trawngson/aware/PAPER.md

# AWARE Paper

Canonical Google Docs paper:

<https://docs.google.com/document/d/1BP99mH7bwltNn4pk-PNhn_heGZIfV6X5lEwvW1smD6A/edit?tab=t.0>

Use this Google Doc as the current source of truth for the paper. Local
research and implementation notes may supplement it, but should not be assumed
to reflect the latest prose in the paper.
