trawngson/aware/design/ab/body-options.html

Thùng rác phân loại · thân B · khung và vỏ

# Phương án thân B

Năm cách làm khung và vỏ cho cùng một thân 680 × 680 × 1170 mm. Cụm đầu, 2 ngăn kéo và 4 thùng gấp PP giữ nguyên. Chọn một phương án để xem hình 3D, vật liệu từng phần, giá và điểm mạnh yếu.

Tách rời Nhìn xuyên vỏ Kéo ngăn kéo Góc nhìn ban đầu

## So sánh 5 phương án

Giá khung và vỏ lấy từ tab 3 của sheet vật tư (giá tấm, thanh từ trang báo giá; tiền cắt, hàn, chấn, dán cạnh là ước tính). Hai phương án mix và cân nặng là ước tính của mình, chưa tra.

Hình 3D dựng từ kích thước thiết kế để so sánh hình dáng và vật liệu, chưa phải CAD đã kiểm tra va chạm. Chỉ Mix 2 (đã chọn) đang có trong CAD và đã qua kiểm tra 25 tư thế; các phương án khác phải sửa CAD và chạy lại kiểm tra trước khi gửi xưởng.
