trawngson/aware/design/ab/index.html

aware · design/ab · thiết kế chi tiết · E1

# Thiết kế thùng rác tự phân loại

- Kích thước ngoài 698 × 698 × 1170 mm, nặng khoảng 40 kg (ước tính). Khung sắt V lỗ bắt bulông, vỏ và nắp inox 304 dày 1 mm.
- Miệng ném Ø550 ở cao 1170 mm. Rác rơi xuống đĩa nhôm Ø320: MG90S xoay đĩa ±45° về phía ngăn, MG996R nghiêng đĩa 45° qua đai GT2 2:1 để đổ.
- 4 thùng trên 2 ngăn kéo: 1 Nhựa (sau phải), 2 Giấy (sau trái), 3 Kim loại (trước trái), 4 Khác (trước phải). Không chắc loại thì vào ngăn 4. Mỗi thùng 270 × 270 × 573 mm, 39,7 L theo hình học, dùng thật khoảng 25–31 L.
- Vật nặng tối đa ở mép đĩa 0,63 kg nếu giữ servo dưới 50% sức kéo. Vật 0,5 kg dùng 40% sức MG996R.
- Mạch S3-1: ESP32-S3 CAM với camera OV2640 120°, màn Guition 4,3" có ESP32-S3 riêng, 4 cảm biến đầy HC-SR04, nguồn adapter 12 V 5 A.

Thân

B · Khung nhôm

Màu nắp inox thân B

Đang tải lưới CAD…

Sẵn sàng

1 · Nhựa 2 · Giấy 3 · Kim loại 4 · Khác Nhìn xuyên vỏ Tách rời Góc nhìn ban đầu

## Số đo chính

## Chi tiết theo cách gia công

### Gửi đi gia công

- Cắt laser hoặc CNC: lấy các file trong dxf/, tỉ lệ 1:1, đơn vị mm. Gồm mâm, đĩa, đế xoay, phễu trải phẳng, các tấm, khay ngăn kéo và 2 file thùng gấp PP bin_wall_strip_x4, bin_floor_x4.
- Cắt CNC tấm Formex: floor_plate, head_seat_plate (Formex 15 mm, khoét góc), drawer_bottom_formex_x2 (Formex 8 mm). Alu 6 mm cắt lẻ: slide_mount_left/right, center_wall.
- Cắt laser + chấn inox 1 mm: phôi có đường gấp (lớp CUT, BEND, NOTE): side_panel_left/right, back_panel, head_panel_front, drawer_front_left/right (có lỗ tay nắm), drawer_stiffener_x4, top_cover. Thêm 4 bản đế chân thép 3 mm (foot_plate_1..4, hàn đai ốc M8).
- In 3D: lấy các file trong parts/*.stl: giá chữ C, giá MG996R, miếng nối servo xoay (yaw_hub, đặc 100%), miếng nối puly 20T (tilt_pulley_adapter, đặc 100%), 2 tai đĩa, 2 cục chặn, rãnh và trống vòng cáp, hộp cảm biến, bệ màn hình.
- Cắt thanh: nhôm hộp 30×30 và 40×30, nhôm dẹt 60×10 (2 đoạn 61 mm, taro M4 hai đầu), trục inox Ø8 (200 mm và 93 mm). Sắt V lỗ cắt theo cut_list_slotted_angle.csv: 4 cây 1155 mm, 9 cây 671 mm, 1 cây 665 mm.
- Bulông cơ cấu nghiêng: 42 con, CAD ghi cỡ và vị trí trong dimensions.json (mục tilt_drive_fasteners): phần lớn M4, thêm M3, M2 và 2 bulông M5 bắt giá chữ C. Xem trang lắp ráp Lắp truyền động D (https://claude.ai/artifact/4bjrufrW9ZDk44Mt1UgGmx).
- File cho xưởng: assembly_e1.step, exploded_e1.step, tilt_to_bin_1..4.step, components.csv.

### Phải đo trước khi cắt

- Thùng gấp PP: gấp thử 1 thùng trước, đo lại kích thước ngoài và độ phồng của thành khi chứa đầy.
- Servo MG996R và MG90S thật: lỗ tai (MG996R đang lấy 48,5 × 10 theo số cộng đồng tự đo), horn chữ thập của MG90S, số răng trục then hoa MG90S (20 hay 21). Đo mô-men MG996R bằng cân treo.
- Puly: lỗ 8 mm hay 5 mm (40T), chiều dài (17 hay 18 mm), đường kính vành 40T (26–29 mm).
- Gối KFL08: khoảng cách lỗ (36–37 mm, giá đã khoét rãnh ±1 mm) và chiều cao (11,5–13 mm). Đường kính trục inox mua về.
- Board ESP32-S3 camera thật: kích thước, số chân rảnh.
- Màn Guition 4,3" thật: kích thước bo, độ dày tính cả đầu cắm, lỗ bắt, vùng hiển thị có nằm giữa bo không (CAD đang giả sử nằm giữa). Board CAM thật: kích thước, vị trí đầu cắm camera và cổng USB-C.
- Ray trượt thật: độ dày, chiều cao, khoảng cách lỗ bắt.
- Sắt V lỗ thật: bề rộng cánh (26 hay 30 mm), khoảng cách lỗ tới góc và bước lỗ, để khoan lỗ vỏ inox và tấm bắt ray trùng lỗ thanh. Nắp inox: hỏi xưởng lượng bù khi gấp mép 1 mm (file tính theo K = 0,44).

## Cụm đầu và phễu

Cụm đầu là một khối liền: mâm, phễu, khung treo, cơ cấu nghiêng, đĩa, cảm biến đầy và bệ màn hình. Toàn bộ treo trên một vòng mâm đặt ở cao độ 1050 mm. Gom hết vào một khối thì thân chỉ cần làm đúng một việc: đỡ vòng mâm ở đúng cao độ đó.

Phần đậm là chi tiết của tab này, phần mờ là phần còn lại của thùng (nút “Hiện phần còn lại” để bật hoặc tắt). Bấm một dòng trong bảng “Chi tiết trong CAD” ở cuối tab để làm nổi chi tiết đó và xoay camera tới.

### Kích thước chính

Hạng mục | Giá trị
Cao miệng ném (mép trên phễu) | 1170 mm
Miệng phễu | Ø550
Phễu côn: cao / thành dày | 140 / 2 mm
Cổ phễu: đường kính / cao gờ | Ø330 / 30 mm
Mâm đầu (nhôm 3 mm) | Ø594 / lỗ Ø400, z = 1050
Vòng định vị dưới mâm | Ø556, sâu 20 mm
4 thanh treo 30×30×2 ở r255 | dài 375 mm
Thanh chữ thập 40×30×2 | 2 × 540 mm, đáy z = 645
Diềm cổ phễu | 36 dải PVC mềm × 14 mm
Chốt định hướng Ø6 | r284, mép sau
Khối lượng cụm đầu (ước tính) | khoảng 4–5 kg

### Gia công phễu (file DXF cắt laser)

- funnel_cone_half_x2.dxf: phễu côn gồm 2 nửa hình quạt, mỗi nửa 113,13°, bán kính trong và ngoài 268,7 / 446,7 mm, có mép chồng 15 mm để tán rivet. Vật liệu PP 2 mm.
- funnel_collar_ring.dxf: vành miệng phễu. funnel_lip_band.dxf: băng gờ cổ phễu, uốn tròn.
- head_shell_ring_strip.dxf: dải vỏ đầu (nhôm composite 3 mm, uốn tròn). head_locating_ring_strip.dxf: dải vòng định vị (PP 3 mm).
- head_deck.dxf: mâm đầu, có sẵn 4 lỗ bắt thanh treo.

Lỗi hay gặp: PP gần như không dán được bằng keo thường. Phải nối bằng rivet nhựa hoặc rivet nhôm kèm long đền, hoặc hàn nhựa. Mặt ngoài của mép chồng phải nằm xuôi theo chiều rác trượt xuống, nếu không rác sẽ vướng vào mép.

### Trình tự lắp

1. Cuộn dải vòng định vị thành vòng tròn, tán rivet rồi bắt vào mặt dưới mâm.
2. Bắt 4 thanh treo vào mâm (4 lỗ có sẵn). Bắt thanh chữ thập vào đầu dưới các thanh treo, chỗ hai thanh bắt chéo nhau có kẹp tấm 3 mm.
3. Dán 4 chân cao su dưới đầu thanh chữ thập. Đóng chốt định hướng vào lỗ ở mép sau mâm.
4. Cuộn và tán phễu côn, vành và gờ cổ. Đặt phễu lên mâm, dựng vỏ đầu bao quanh.
5. Treo diềm PVC dưới gờ cổ phễu. Lắp cơ cấu nghiêng (tab tiếp theo), 4 hộp cảm biến và bệ màn hình.

### Chi tiết trong CAD

Phương án D · đã chốt ngày 9/10

## Động cơ và cơ cấu nghiêng: xoay rồi nghiêng

Đĩa chạy theo 2 bước nối tiếp. Bước 1: servo nhỏ MG90S xoay cả cụm nghiêng quanh một trục đứng, để mép đĩa quay về phía ngăn cần đổ. Bước 2: MG996R nghiêng đĩa quanh một bản lề nằm ngang, qua đai GT2 tỉ số 2:1. Đĩa nghiêng được cả 2 chiều, nên chỉ cần xoay ±45° là tới đủ 4 ngăn chéo.

Hai điểm giúp motor nhỏ vẫn đủ sức: bản lề nằm sát mặt đĩa (cách 22 mm, gần trọng tâm đĩa) nên đĩa gần như cân bằng, và 2 gối đỡ ổ bi chịu trọng lượng đĩa, servo chỉ việc tạo mô-men xoay.

Phần đậm là chi tiết của tab này, phần mờ là phần còn lại của thùng (nút “Hiện phần còn lại” để bật hoặc tắt). Bấm một dòng trong bảng “Chi tiết trong CAD” ở cuối tab để làm nổi chi tiết đó và xoay camera tới.

### Truyền động

giá chữ C (trên thanh chữ thập)
  └ MG90S ─ horn chữ thập ─ miếng nối in ─ trục đứng Ø8 trong 2 gối KFL08 ─ mặt bích Ø32 ─ đế xoay
đế xoay
  ├ 2 trụ 60×10 ─ 2 gối KP08 ─ trục bản lề Ø8 ─ 2 tai ─ đĩa nhôm
  └ MG996R ─ horn nhôm 25T ─ miếng nối in ─ puly 20T ═ đai GT2 158 ═ puly 40T trên trục bản lề

Hạng mục | Giá trị
Servo nghiêng / xoay | MG996R / MG90S
Góc nghiêng / góc xoay | ±45° / ±45°
Mô-men kẹt MG996R ở 6 V (số thận trọng, shop ghi 15 kg·cm) | khoảng 11 kg·cm = 1,08 N·m
Puly, tỉ số | GT2 20T → 40T, 2:1
Đai kín GT2 rộng 6 mm / khoảng cách tâm puly | 158 mm / 48,58 mm
Trục bản lề (cách mặt đĩa 22 mm) | Ø8 × 200 mm, z = 878
Trục đứng | Ø8 × 93 mm
Đế xoay, nhôm 4 mm (13 lỗ, 4 lỗ ren M4 cho mặt bích) | 196 × 192 mm, z = 797–802
Puly 20T / 40T (dài theo trục, gồm vành và cổ) | 16 / 17 mm, vành Ø16 / Ø29
Mặt phẳng đai / mép puly 40T tới gối KP08 | x = 67–73 / 1,75 mm
Gối KP08 / KFL08: lỗ bắt | cách 42 / 37 mm, bulông M4
Mặt bích nối trục 8 mm | Ø32 × 13, 4 × M4 trên vòng Ø24
Trụ đỡ gối KP08 | nhôm dẹt 60×10 × 61 mm, taro M4

### Mô-men và tải

Trường hợp (đĩa nghiêng 45°, vật ở mép) | Giá trị
Mô-men cần ở bản lề, vật 0,5 kg | 0,783 N·m
Mô-men cần ở MG996R (qua 2:1, hiệu suất 90%) | 0,435 N·m (40%)
Vật nặng nhất ở mức 50% sức servo | 0,63 kg
Vật nặng nhất trước khi servo chết máy | 1,29 kg
Lực lớn nhất đĩa ép lên tay ở mép | khoảng 12 N
Tải của MG90S (trục xoay) | chỉ có quán tính, trọng lực không tạo mô-men quanh trục đứng

Quy tắc thiết kế: servo không làm việc quá 50% sức kéo tối đa. Script dừng hẳn nếu vượt mức này. Ngày 9/10 phương án D tính được vật ở mép khoảng 0,6 kg cho đĩa Ø280. CAD mới cho đĩa Ø320 bằng nhôm ra 0,63 kg, khớp với số cũ.

### Đĩa nghiêng

- Nhôm 1,5 mm, Ø320, nặng 0,326 kg, bắt vào 2 tai PETG bằng 4 vít M4 × 6 đầu bằng vào đai ốc cấy nhiệt. Mỗi tai kẹp trục bản lề bằng 1 vít trí M3 trên mặt D.
- Mặt đĩa ở cao độ 900 mm, trục bản lề ở 878 mm. Bản lề sát mặt đĩa nên đĩa nặng hơn PP vẫn nhẹ tải.
- Đổi từ PP sang nhôm: không chảy khi gặp tàn thuốc, khó xước, dễ lau.

Lưu ý: nhôm trần bóng sẽ hắt ánh đèn LED vào camera. Đã chốt bỏ sơn (20/10): chà mặt đĩa bằng miếng Scotch-Brite cho mờ, rồi chụp thử xem còn chói không. Không dán decal, vì decal sẽ chảy khi gặp đồ nóng.

### Cục chặn cứng 47° trên đế xoay

- 2 cục chặn PETG bọc cao su, đặt trên đế xoay ở y = ±88 mm, mặt trên ở z = 807,3.
- Đế xoay quay cùng hướng với đĩa, nên cục chặn luôn nằm ngay dưới mép đang hạ xuống.
- Đĩa nghiêng 45° vẫn cách cục chặn 5,7 mm. Tới 47° thì đáp lên cao su.
- Lực va đập hoặc lực tay ấn đi vào ổ của trục đứng, không đi vào bánh răng của cả 2 servo. Lực thẳng đứng không tạo mô-men quanh trục đứng, nên MG90S cũng không phải gánh.
- Mép thấp của đĩa ra tới bán kính khoảng 128 mm, còn đế xoay chỉ dài 96 mm mỗi bên, nên rác rơi ra không chạm đế.

### Đo góc

MPU-6050 dán dưới đĩa đo được góc nghiêng thật, nên phát hiện được kẹt (ra lệnh nghiêng sau 1,5 giây mà góc vẫn lệch quá 5°) và biết đĩa đang nghiêng bao nhiêu khi có điện lại.

IMU không đo được góc xoay, vì trọng lực không đổi khi xoay quanh trục đứng. MG90S chỉ chịu quán tính nên ít khi trượt bước. Nếu thử thực tế thấy hay đổ nhầm ngăn thì thêm AS5600 (khoảng 55k) dưới trục đứng.

Dây MG996R và IMU đi qua trục xoay: chừa vòng dây đủ dài cho ±45° xoay và ±47° nghiêng. Dùng dây silicon mềm.

### Đi dây động cơ qua khớp xoay (đã vẽ trong CAD)

Dây MG996R và IMU phải đi qua khớp xoay. Khớp này uốn khoảng 36.000 lần mỗi năm (ước tính 100 lần đổ mỗi ngày), nên không thả vòng chùng tự do mà dùng vòng lăn trong rãnh tròn: cáp dẹt gập chữ U, nằm giữa một thành cố định và một trống quay theo đế. Khi đế xoay, chỗ gập chỉ lăn dọc theo rãnh, nên cáp luôn uốn ở cùng một bán kính và không bị kéo căng.

Nhìn từ trên xuống, dưới đế xoay (z 783–797):

        thành ngoài cố định (r 40–43), có 2 vấu chặn ở ±70°
      ╭─────────────────────────╮
     │  cáp ─ chạy áp thành ngoài │ ← cáp vào qua rãnh ở 60°
     │    ╭─────────╮             │
     │    │ trống   │  ◯ trục Ø8  │   chốt chặn M4 dưới đế, ở r 55
     │    │ quay    │             │
     │    ╰────┬────╯             │
     │         ⊃ chỗ gập U, bán kính uốn 10,2 mm, lăn theo khi xoay
      ╰─────────────────────────╯
  cáp ra áp trống quay, đi lên qua lỗ ở đế (30°)

Hạng mục | Giá trị
Cáp | cáp dẹt 10 sợi, bước 1,27 mm, loại chịu uốn
Thứ tự sợi | 6 V, 6 V, GND, GND, PWM, GND, SDA, GND, SCL, 3,3 V
Chiều dài cáp trong rãnh | 134 mm
Bán kính uốn ở chỗ gập | 10,2 mm, khoảng 10 lần bề dày cáp
Chỗ gập lăn đi khi xoay hết ±70° | khoảng 46° quanh trục
Dây MG996R và IMU, cả đường từ bệ | khoảng 1,04 m → mua 1,2 m
Dây MG90S (không qua khớp) | 780 mm → dây nối dài servo 1 m

### Khi trục xoay quay quá tầm hoặc quay mãi

MG90S chuẩn chỉ quay trong 180°. Trục xoay vẫn có thể quay tự do nếu miếng nối trượt trên trục, tuốt răng servo, lắp nhầm bản MG90S 360°, hoặc có người lấy tay xoay đĩa. Khi đó dây có thể bị quấn quanh trục và giật đứt. Có 4 lớp bảo vệ:

1. Chặn cứng ±70° (đã vẽ): chốt M4 có ống lót dưới đế xoay, chạm vào 2 vấu trên rãnh. Dù servo hay miếng nối hỏng thì cụm vẫn không quay quá ±70°, đúng tầm rãnh được thiết kế. Đã kiểm tra: ở 68° chốt chưa chạm, ở 72° thì đã chạm. Tay ấn mạnh ở mép đĩa (khoảng 8 N·m) tạo khoảng 150 N lên chốt, nên vấu phải in đặc 100% và dán cao su.
2. Miếng nối servo xoay: không dùng khớp nối mềm. Khớp 5 × 8 mm dài 25 mm, không lọt dưới tay gối dưới, mà nửa 5 mm chỉ ôm được đầu then hoa ngắn của MG90S. Thay bằng một miếng nối in PETG đặc 100%, Ø20 × 11 mm. MG90S chỉ kèm horn dạng tay, không có horn tròn: miếng nối bắt vào horn chữ thập bằng 2 vít M2 tự ren qua 2 lỗ trên tay horn, mặt dưới có hốc tránh đầu vít tâm. Trục kẹp bằng vít trí M3 và đai ốc thả từ trên xuống, lên mặt D, bôi keo khoá ren. MG90S treo qua lỗ trên kệ, 2 tai tì lên mặt kệ (TowerPro: mặt dưới tai cách đáy 18,5 mm, trục then hoa nhô 4,1 mm). Kích thước horn chữ thập trong CAD là số tạm: đo horn thật trước khi in.
3. Phần mềm phát hiện: con quay trong IMU đo được tốc độ xoay quanh trục đứng. Thấy xoay khi không có lệnh, hoặc xoay quá xa so với lệnh, thì ngắt relay servo và báo lỗi. Ngắt xung PWM khi đứng yên để servo không rung làm mỏi dây. Lệnh xoay luôn giới hạn trong ±65°.
4. Khoanh vùng hỏng: cầu chì tự phục hồi 3 A trên đường 6 V, để dây có chập thì cũng không cháy mạch. Kẹp neo giữ vỏ cáp, để lực kéo không truyền vào mối hàn.

Khi lắp: cấp xung 1500 µs cho MG90S. Nếu servo cứ quay mãi thì đó là bản 360°, lắp nhầm hàng. Mình chưa thử tuổi thọ của cáp dẹt bán ở VN với bán kính uốn 10 mm. Nên in thử rãnh, cho chạy vài nghìn lần rồi đo thông mạch.

### Lỗi hay gặp

- Đai chùng hoặc quá căng: đai kín không có bộ căng đai, nên khoảng cách tâm 48,58 mm phải đúng. Giá bắt MG996R có rãnh đứng 2 mm (khoảng cách 2 puly là theo chiều đứng): kéo servo xuống cho đai căng rồi siết 4 vít M3.
- Puly 20T không lắp thẳng vào spline 25T của MG996R: lắp horn nhôm 25T Ø20 (4 lỗ ren M3), bắt miếng nối in vào horn bằng 4 vít M3, rồi lồng puly lên trụ Ø5,9 của miếng nối. Puly dài 16 mm: cổ puly quay về phía servo, vì 2 vít trí nằm trên cổ; mài mặt vát trên trụ cách đầu cổ 4 mm.
- Puly 40T dài 17 mm (2 vành Ø29, cổ một phía): lắp cổ quay vào giữa, vành ngoài cách gối KP08 khoảng 1,7 mm. Quay cổ ra ngoài là đụng gối.
- Puly 40T có shop ghi lỗ 8 mm nhưng đường link lại ghi 5 mm. Hỏi shop trước, nếu là lỗ 5 mm thì khoan lên 8 mm.
- MG996R giá rẻ hay là hàng nhái: mua 1 con, đo mô-men bằng cân treo rồi mới mua thêm. Gắn tay đòn 2,5 cm ở 6 V: cân phải lên tới khoảng 3,5 kg servo mới chịu thua (tức 9 kg·cm, đủ để tải 0,435 N·m chỉ chiếm 50%). Tháo đáy xem mọi bánh răng đều là kim loại. Shop đang chọn có bán cả bản MG996R-360: cấp xung 1500 µs, servo phải đứng yên ở giữa chứ không quay mãi.
- Xoay khi đĩa đang nghiêng: phần mềm phải luôn đưa đĩa về nằm ngang trước, rồi mới xoay sang ngăn khác.
- Nghiêng quá nhanh làm rác văng: tăng tốc từ từ, khoảng 1 giây cho 45°.

### Chi tiết trong CAD

## Cơ chế đổ

Rác không bị đẩy. Đĩa chỉ nghiêng về hướng của ngăn đích, và vật tự trượt khỏi mép thấp, qua khe giữa mép đĩa và gờ cổ phễu rồi rơi vào ngăn.

Phần đậm là chi tiết của tab này, phần mờ là phần còn lại của thùng (nút “Hiện phần còn lại” để bật hoặc tắt). Bấm một dòng trong bảng “Chi tiết trong CAD” ở cuối tab để làm nổi chi tiết đó và xoay camera tới.

### Hình học khi đổ (nghiêng 45°)

Hạng mục | Giá trị
Khe thoát dưới gờ cổ phễu | 180,9 mm
Cao độ mép thấp của đĩa | 779,4 mm
Cao độ miệng ngăn | 620 mm
Bán kính điểm rơi (tâm ngăn) | 224 mm
Vật lớn nhất lọt qua khe thoát | khoảng 170 mm

### Một lần đổ

1. Vật nằm yên trên đĩa, miệng phễu không có tay: camera nhận dạng và chọn ngăn.
2. Kiểm tra ngăn đó: còn chỗ chưa, có đang khoá không (đầy, hay ngăn kéo đang rút).
3. Xoay cụm nghiêng tới hướng ngăn (±45°, khoảng 0,7 giây), rồi nghiêng 45° trong khoảng 1 giây, tăng tốc và giảm tốc êm. Theo dõi IMU suốt lúc nghiêng.
4. Giữ 0,8 giây cho vật trượt hết.
5. Nghiêng về nằm ngang trong khoảng 1 giây, rồi mới xoay về 0°. Camera chụp lại xem đĩa đã trống chưa. Còn vật thì lắc nhẹ 2 lần, vẫn còn thì báo.

### Sức chứa

| Hình học (CAD) | Dùng được thật (ước tính) | Cả 4 ngăn
B · thùng 270×270×573 | 39,7 L | 25–31 L | khoảng 164 L

Rác luôn rơi vào cùng một chỗ nên chất thành hình nón, chỉ dùng được 60–75% thể tích. T17 · rải đều: mỗi lần đổ, đổi góc xoay lệch khoảng ±20° quanh đường chéo ngăn (MG90S làm được, vì xoay tới ±65° vẫn trong 180° của servo) và đổi góc nghiêng trong khoảng 35–45°, để dịch điểm rơi. Cách này có thể nâng phần dùng được lên khoảng 80%, nhưng mới là plausible, phải thử với rác thật.

### Khi đầy

Mức | Điều kiện (chỉnh lại khi thử) | Máy làm gì
Bình thường | Còn nhiều chỗ | Nhận rác
Gần đầy | khoảng 80% | Vẫn nhận. Màn hình hiện thanh vàng cho ngăn đó. E1 báo lên điện thoại qua wifi (tuỳ chọn)
Đầy | khoảng 90%, hoặc đỉnh rác cách đường rơi khoảng 80 mm | Khoá ngăn. Vật thuộc loại đó được giữ lại trên đĩa, màn hình báo “Ngăn X đầy”
Kẹt dù cảm biến chưa báo đầy | IMU thấy đĩa không tới được góc lệnh | Quay về, khoá ngăn, báo kẹt
Vừa đổ rác xong | Ngăn kéo đóng lại, cảm biến đo thấy ngăn trống | Hỏi “Đã lót túi chưa?”. Người dùng xác nhận thì mở khoá
Đo được dưới 200 mm | Rác không thể cao tới đó: đĩa nghiêng hết cỡ thì mép thấp ở 779 mm, cách cảm biến 216 mm. Đây là tiếng vọng từ diềm hoặc mép đĩa | Coi như cảm biến lỗi. Khoá ngăn, báo “Kiểm tra cảm biến ngăn X”
Nhảy từ gần trống lên đầy sau 1 lần đổ | Một vật không thể lấp gần hết ngăn. Thường là cảm biến nghe thấy mép túi hoặc khung | Khoá ngăn, báo kiểm tra cảm biến
Không có tiếng vọng | ECHO giữ mức cao quá 30 ms | Coi là không đọc được, không coi là trống. Khoá ngăn, báo kiểm tra

Đọc mỗi cảm biến 5 lần rồi lấy trung vị. Chỉ chuyển mức khi kết quả giữ nguyên 3 chu kỳ liền, để túi nilon phồng lên không làm máy báo đầy sai. Chỉ đo khi đĩa nằm ngang và đứng yên, vì lúc đổ thì rác rơi ngang qua chùm sóng.

### Chi tiết trong CAD (đường đổ rác, thân B)

## Lấy rác khi một ngăn đầy (thân B)

Rác nằm trong túi lót, nên lấy túi ra là lấy hết rác. Thùng vẫn nằm yên trong ngăn kéo, người dùng chỉ nhấc túi, không phải nhấc cả thùng nặng 10–12 kg. Bấm nút một ngăn bên dưới hình để xem từng bước.

Thùng và mặt ngăn kéo vẽ trong suốt để thấy túi rác bên trong. Túi đen là hình minh hoạ, không có trong CAD. Ray trượt vẽ đứng yên, thực tế ray kéo dài ra theo ngăn kéo.

### Các bước

1. Kéo ngăn kéo ra hết (ray 600 mm). Công tắc ở cuối ngăn kéo nhả ra, cắt nguồn servo và khoá 2 ngăn của ngăn kéo đó, nên đĩa không đổ rác xuống tay người.
2. Tháo vòng chun ở miệng thùng, miệng túi đang lộn ngoài vành sẽ tuột ra.
3. Gom miệng túi và buộc lại. Túi có dây rút thì chỉ cần kéo dây.
4. Nhấc túi thẳng lên. 4 lỗ Ø10 ở đáy cho khí vào dưới túi, nên túi không bị hút dính.
5. Lót túi mới, lộn miệng túi ra ngoài vành khoảng 5 cm, rồi lồng vòng chun lại.
6. Đẩy ngăn kéo vào rồi bấm xác nhận “Đã lót túi” trên màn hình để mở khoá ngăn.

### Khi có sự cố

Tình huống | Cách lấy rác ra
Quên lót túi, hoặc rác lọt xuống giữa túi và thành thùng | Kéo ngăn kéo ra, nhấc cả thùng lên (thùng nằm ngoài khung), dốc ngược đổ vào túi lớn
Túi rách khi nhấc | Nhấc cả thùng ra, dốc ngược như trên
Túi quá nặng (giấy ướt, chai lọ) | Thay sớm hơn. Màn hình báo vàng ở khoảng 80%, khoá ngăn ở khoảng 90%
Nước rỉ xuống đáy | Nước chảy qua lỗ thông khí xuống khay ngăn kéo. Lau khay, hoặc lót tấm thấm dưới đáy khay

### Lỗi hay gặp

- Túi quá nhỏ: túi phải rộng ít nhất 55 cm, dài ít nhất 82 cm. Túi ngắn sẽ tụt vào trong khi rác rơi xuống, rồi rác lọt xuống đáy thùng.
- Nhét tay thêm rác khi ngăn đã khoá: rác cao quá miệng thùng thì không buộc được túi.
- Thùng sau: khi kéo ra hết, thanh ngang trước của khung (rộng 20 mm) vẫn ở phía trên miệng thùng, cao hơn miệng 404 mm. Nhấc túi thì nghiêng túi ra trước một chút.

### Chi tiết trong CAD

## Bệ màn hình và camera

Bệ màn hình gồm hai phần: một tấm màn hình 4,3 inch ngả ra sau 12° và một đế thấp phía sau chứa các bo mạch. Màn hình là Guition JC4827W543: tấm IPS 480×272 gắn sẵn ESP32-S3 riêng, nối với board camera qua cổng UART JST 1,25 mm 4 chân. Ngoài hiển thị, board màn còn đọc 4 cảm biến siêu âm báo đầy. Tấm in là khung mỏng 5 mm quanh bo màn 120 × 70 mm (số của shop, phải đo). Sơ đồ chân ở trang mạch S3-1 (https://claude.ai/artifact/641f6wND7d8yH814VZVqmR).

Phần đậm là chi tiết của tab này, phần mờ là phần còn lại của thùng (nút “Hiện phần còn lại” để bật hoặc tắt). Bấm một dòng trong bảng “Chi tiết trong CAD” ở cuối tab để làm nổi chi tiết đó và xoay camera tới.

### Kích thước

Hạng mục | Giá trị
Đế: rộng × sâu × cao | 160 × 156 × 46 mm
Cằm: mép trước / cao | y = 132 / 20 mm
Màn hình 4,3": vùng hiển thị / tấm | 95 × 54 / 130 × 80 × 22 mm, ngả 12°
Mép trên màn hình (thân B) | cao 1268,3 mm so với sàn
Cáp camera 75 mm: khoảng cách từ camera tới đầu cắm trên board | 16,8 mm, dư khoảng 58 mm
Ống kính camera | (0; 154,9; 1178,7)
Trục camera so với phương thẳng đứng | 29,1°, chĩa vào tâm đĩa
Góc nhìn cần có (hình nón) | 60,2° → dùng ống 120°
Mép đĩa bị khuất | 0 / 72 điểm
Khoảng dư của tia nhìn tại gờ cổ phễu | khoảng 6,1 mm
Dải LED trắng 2835 (cắt mỗi 50 mm), rãnh rộng 9 | 100 mm, y = 174
Vành bắt vít trên mép phễu | cao 5 mm, từ y = 235 ra sau

### Bên trong bệ (vỏ in rỗng)

- Board ESP32-S3-N16R8 CAM nằm trong đế. Camera OV2640 ống 120° tách khỏi board, nối bằng cáp dẹt 75 mm, gắn sau ô kính dưới cằm, chĩa vào tâm đĩa. Script kiểm tra cáp với tới đầu cắm trên board, còn dư ít nhất 15 mm.
- Màn Guition 4,3" (bo 120 × 70 mm, khoảng 13 mm dày tính cả đầu cắm, số tạm) nằm gọn trong tấm màn, nối board camera bằng UART và nhận 5 V riêng từ mạch hạ áp. Giao diện làm bằng Guition Editor hoặc Arduino. Chừa lối cắm cổng USB-C của cả 2 board để nạp code không phải tháo bệ.
- Dải LED 5 V dài 100 mm (dải chỉ cắt được ở mốc 50 mm), bật tắt qua module 2 MOSFET XY-MOS. Module nhận tín hiệu từ 3,3 V nên chân GPIO của ESP32 mở hết MOSFET, đèn sáng tối đa. Lúc camera chụp thì bật 100%, không làm mờ bằng PWM để ảnh không bị sọc.
- Cầu đấu nguồn 5 V kèm tấm mạch nhỏ 8 điện trở chia áp, tụ 2200 µF, module relay cắt nguồn servo (xem tab Điện).
- Bệ in PETG làm 2 nửa, ghép bằng vít M3 và đai ốc cấy nhiệt. Bệ nằm trên mép trên của phễu, ra khỏi đường nước, bắt xuống mép phễu qua một vành thấp hai bên.
- Chỗ cho mạch (tra ngày 01/11): script kiểm tra 8 khối đặt vừa trong đế, mỗi khối có vách 2,5 mm bao quanh và không chạm màn hình, hốc camera hay nhau: board ESP32-S3 CAM 57×28×15 (2 cổng USB-C quay ra khe ở vách trái), cầu đấu 12P cắt còn 4 cực (37×18), tấm chia áp 24×20, tụ 13×26, XL4015 54×23 cộng chỗ dây hai đầu (66×23×18), mạch hạ áp 5 V 59×21×17 hàn dây ở hai đầu (62×21×17), relay 50×26 cộng phía cầu đấu (60×26×19), XY-MOS 34×17×12. Màn Guition 120×70,2 có 4 lỗ M3 cách 112,6 × 62,1, cổng USB-C và JST nguồn/UART ở mép trái ra qua khe trên thành tấm màn, vùng hiển thị lệch lên 1,7 mm so với tâm bo. Camera đặt sâu 3 mm trong lỗ Ø22 nên thành lỗ nằm ngoài nón 120°. Cáp camera 75 mm: từ camera tới đầu cắm giữa board khoảng 58 mm.

### Lỗi hay gặp

- Tấm màn hình dễ bị tì tay hoặc va: mép trên cao hơn miệng thùng khoảng 180 mm, lực bẻ dồn vào vành bắt vít ở mép phễu. Chưa kiểm tra độ bền chỗ này.
- Khoảng dư tia nhìn chỉ khoảng 6,1 mm: lắp camera lệch quá mức đó là khuất mất mép sau đĩa. In ổ camera có rãnh chỉnh và căn bằng một ảnh mẫu đĩa trống.
- Ống 120° làm méo ảnh kiểu mắt cá: hiệu chỉnh một lần bằng ảnh bàn cờ, hoặc huấn luyện mô hình nhận dạng luôn trên ảnh đã méo.
- LED chiếu thẳng xuống đĩa nhôm bóng gây chói: chà mặt đĩa cho mờ; nếu còn chói thì dán một dải nhựa mờ (không có trong danh sách mua) lên rãnh LED.

### Chi tiết trong CAD

## Cảm biến và điện

Dùng một adapter 12 V 5 A. Mạch hạ áp XL4015 hạ xuống 6 V cho 2 servo: phương án D tính mô-men của MG996R ở 6 V. Một mạch hạ áp khác hạ xuống 5 V cho ESP32-S3, màn hình và cảm biến. Nguồn servo đi qua công tắc an toàn bằng phần cứng, nên dù phần mềm treo thì ngăn kéo rút ra cũng không làm đĩa chuyển động được.

Phần đậm là chi tiết của tab này, phần mờ là phần còn lại của thùng (nút “Hiện phần còn lại” để bật hoặc tắt). Bấm một dòng trong bảng “Chi tiết trong CAD” ở cuối tab để làm nổi chi tiết đó và xoay camera tới.

### Sơ đồ nguồn

Adapter 12 V 5 A ──┬── hạ áp 5 V 3 A ── ESP32-S3 cam, màn hình, IMU, 4 × HC-SR04, LED
                   └── XL4015 6 V ── cầu chì 3 A ── Relay ── tụ 2200 µF ── MG996R + MG90S
                         ▲
   2 công tắc ngăn kéo, nối tiếp
- Cuộn hút của relay được cấp điện qua các công tắc mắc nối tiếp. Chỉ cần một công tắc mở là relay nhả, servo mất nguồn. Chân GPIO đọc thêm trạng thái để báo lên màn hình.
- Dây servo cỡ 18–20 AWG, đi riêng một đường từ cầu đấu.
- Nối chung mass cho mọi khối.

### Gán chân dự kiến

Khối | Số chân
Camera (có sẵn trên board) | không tính
Màn Guition (ESP32-S3 riêng): UART TX, RX | 2
Servo PWM: MG996R, MG90S | 2
I²C (IMU) | 2
HC-SR04: 4 TRIG + 4 ECHO, nối vào board màn Guition, không tính cho board camera | 0
2 công tắc ngăn kéo đọc vào | 2
LED XY-MOS, relay | 2
Tổng trên board camera | 10

Board ESP32-S3-N16R8 WROOM CAM còn khoảng 11 chân trống (suy ra từ board Freenove cùng kiểu, chưa đếm trên board thật), đủ cho 10 chân trên. 4 cảm biến siêu âm cần 8 chân nên đặt trên board màn Guition, mỗi cái 1 chân TRIG riêng. Chi tiết gán chân ở trang mạch S3-1 (https://claude.ai/artifact/641f6wND7d8yH814VZVqmR).

### Cảm biến đầy

- 4 cảm biến siêu âm HC-SR04 (25k một cái), mỗi cái trong một hộp in treo dưới gờ cổ phễu ở r215, úp mặt nhìn thẳng xuống một ngăn.
- Hộp ôm board 45 × 20 mm. Đầu dây quay ra ngoài, dây đi lên qua miệng hộp để hở. In với miệng loa úp xuống bàn in: có vạt nghiêng 45° đỡ phần chứa đầu dây nên không cần support.
- Mỗi đầu phát và đầu thu có một loa in: dài 15 mm, loe từ Ø16 ra Ø24. Miệng rộng hơn thì chùm sóng hẹp hơn: theo ước tính, sóng yếu đi một nửa ở ±11° thay vì ±16°. In ở trường nên không tốn thêm tiền.
- Thân B: miệng loa ở cao 995 mm. Ngăn trống đo ra khoảng 962 mm, đầy 90% khoảng 434 mm.
- B: khi rút thùng ra, cảm biến đo xa hơn mốc ngăn trống, nên máy biết ngăn đó đang thiếu thùng.
- Khoảng cách giữa 2 đầu đổi thành 27 mm theo 2 footprint độc lập (trước để 26). Vẫn nên mua 1 board, đo lại rồi sửa fill_sensor trước khi in.
- Nếu thử thật vẫn đo sai thì đổi sang VL53L1X (laser, khoảng 200k một cái) và in lại hộp.

### Lỗi hay gặp

- Chân ECHO của HC-SR04 ra 5 V, nối thẳng vào ESP32 (chỉ chịu 3,3 V) sẽ hỏng chân. Dùng cầu chia áp 1 kΩ / 2 kΩ.
- ESP32 tự khởi động lại khi servo bắt đầu chạy, do sụt áp. Cần tụ lớn và đường dây servo đi riêng.
- Dùng chung 1 chân TRIG thì cả 4 cái phát cùng lúc, nghe nhầm tiếng vọng của nhau. Mỗi cái một chân TRIG, đo lần lượt, cách nhau ít nhất 60 ms (datasheet khuyên chu kỳ đo trên 60 ms).
- Đưa chân ECHO qua PCF8574 thì đo sai: đọc qua I²C quá chậm, mà mỗi 1 mm chỉ chênh khoảng 6 µs.

### Vật nằm gần hơn mặt rác lúc đầy (thân B)

HC-SR04 trả về tiếng vọng đầu tiên nó nghe được. Vật nào gần hơn 434 mm mà nó nghe thấy thì máy sẽ tưởng ngăn đã đầy. CAD tìm các cạnh như vậy và đo góc lệch khỏi trục cảm biến (ghi trong dimensions.json, mục fill_sensor). Cột dB là mức nghe ước tính, tính cả đường đi lẫn đường về: càng âm thì càng khó nghe thấy.

Vật | Lệch khỏi trục | Cách cảm biến | Không loa | Có loa
Mép thùng, chỗ túi trùm qua | 18,5° | 396 mm | −8 dB | −21 dB
Thanh chữ thập | 20,6° | 374 mm | −10 dB | −28 dB
Đế xoay dưới đĩa | 22,3° | 220 mm | −12 dB | dưới −35 dB
Dây servo | 24,2° | 351 mm | −15 dB | dưới −35 dB
Đầu dưới diềm PVC | 26,2° | 108 mm | −17 dB | dưới −35 dB
Mép đĩa | 29,7° | 111 mm | −24 dB | dưới −35 dB

Cột dB tính theo mô hình đơn giản, coi miệng loa như một màng rung phẳng, chưa đo. Phép tìm cạnh cũng không tính chuyện vật này che vật kia. Datasheet chỉ hứa góc đo 15° với vật phẳng rộng ít nhất 0,5 m², mà miệng thùng chỉ khoảng 0,07 m². Phải thử 1 cái trên thùng thật trước khi in cả 4 hộp.

### Chi tiết trong CAD

## Thân B · khung sắt V lỗ, 2 ngăn kéo

Khung sắt V lỗ "3×3" dày 2 mm (cánh thực tế khoảng 26 mm theo các shop) bắt bulông như kệ kho: thanh ngang chồng lên mặt trong cánh cột và bắt bulông M8 qua lỗ V. Khung 680 × 680 mm đứng trên 4 chân tăng chỉnh M8; vỏ inox 1 mm cách cột 6 mm để chừa mũ bulông, ngoài cùng 698 × 698 mm, cao 1170 mm. Bốn thùng gấp từ tấm nhựa PP 3 mm đặt trên 2 ngăn kéo, mỗi ngăn kéo chở 1 thùng trước và 1 thùng sau. Mặt sau là tấm cố định nên thùng kê sát tường được. Cụm đầu bắt vít cố định vào tấm đỡ, vì đổ rác không cần nhấc đầu.

Phần đậm là chi tiết của tab này, phần mờ là phần còn lại của thùng (nút “Hiện phần còn lại” để bật hoặc tắt). Bấm một dòng trong bảng “Chi tiết trong CAD” ở cuối tab để làm nổi chi tiết đó và xoay camera tới.

### Khung và tấm

Hạng mục | Giá trị
Sắt V lỗ: cột đứng, đứng trên bản đế chân | 4 × 1155 mm
Sắt V lỗ: thanh ngang chồng trong cột (dưới 3, giữa 3, trên 4; không có thanh dưới phía trước) | 9 × 671 + 1 × 665 mm
Bulông kệ M8 bắt thanh vào cột (2 đầu mỗi thanh) | 16 × M8×12 + 4 × M8×15
Chân tăng chỉnh M8 đế Ø30 + bản đế thép 3 mm có đai ốc hàn; tai bản đế kẹp dưới thanh dưới | 4 bộ, cao 15 mm
Tấm sàn Formex 15 mm trên 3 thanh dưới, khoét 4 góc, 3 bulông M8×30 | 666 × 672
Tấm đỡ đầu Formex 15 mm trên 4 thanh trên, khoét 4 góc, 4 bulông M8×30 | 672 × 672, lỗ Ø560 + lỗ chốt
Vách giữa / 2 tấm bắt ray, alu composite 6 mm | 640 × 106 / 670 × 106
Tấm bắt ray bắt vào lỗ cột qua ống lót 18 mm | 8 bộ M5×40
Vỏ inox 1 mm gấp mép kín 10 mm: 2 hông / lưng / tấm che trước | 696 × 1155 / 692 × 1155 / 692 × 161
Nắp trên inox 304 dày 1 mm, mép gập xuống 15 mm | 698 × 698, lỗ Ø598
Tổng inox (vỏ, 2 mặt ngăn kéo, 4 nẹp, nắp) | khoảng 30,7 kg

### Ngăn kéo

Hạng mục | Giá trị
Ray bi 3 tầng First Slide 46 × 12,7, 45 kg/cặp | 4 × 600 mm (2 cặp)
Đáy khay, Formex 8 mm | 2 × 285,6 × 647
Thành hông khay, PP 3 mm phần dư | 4 × 647 × 60
Thành sau khay, PP 3 mm phần dư | 2 × 285,6 × 60
Mặt ngăn kéo inox 1 mm gấp mép, lỗ tay nắm 120 × 30, 2 nẹp gân mũ phía sau | 2 × 339 × 990
Thùng gấp từ tấm PP 3 mm, tâm ở (±158,5; ±158,5) | 270 × 270 × 573
Mép miệng gấp ra ngoài / 2 lỗ tay nắm | 15 mm / 90 × 30
Lỗ thông khí ở đáy mỗi thùng | 4 × Ø10, cách tâm (±80; ±80)
Vòng chun ép túi, bản 10 mm, dày 2 mm | 4 vòng, cách miệng 12 mm
Mép trên thùng / đáy thanh chữ thập | 617 / 645 mm

### Thùng gấp từ tấm PP 3 mm

Không có thùng bán sẵn nào hẹp mà cao như cần (270 × 270 × 573): thùng 27 × 27 cm thì chỉ cao 30–37 cm, thùng cao 50–60 cm thì rộng 38–44 cm. Vì vậy mỗi thùng được cắt phẳng từ tấm PP rồi gấp lại, giống gấp hộp carton. Đáy thùng nằm trên khay ngăn kéo, nên khay chịu sức nặng của rác, thành thùng chỉ giữ rác khỏi tràn ra ngang.

 Miếng 1 · thân  (bin_wall_strip_x4.dxf)
 ┌──────┬──────┬──────┬──────┬─┐ ← mép miệng 15 mm, xẻ ở góc
 │      │ ▭    │      │ ▭    │•│ ← mép dán 15 mm, 8 rivet
 │ mặt 1│ mặt 2│ mặt 3│ mặt 4│•│   ▭ lỗ tay nắm 90×30
 │ 270  │ 270  │ 270  │ 270  │•│   cao 573 mm
 └──•─•─┴──•─•─┴──•─•─┴──•─•─┴─┘ ← 8 rivet bắt vạt đáy
   1095 × 588 mm

 Miếng 2 · đáy  (bin_floor_x4.dxf)
      ┌────┐
   ┌──┼────┼──┐   264 × 264 + 4 vạt 30 mm
   │  │ ○ ○│  │   ○ 4 lỗ thông khí Ø10
   │  │ ○ ○│  │
   └──┼────┼──┘   324 × 324 mm
      └────┘

File DXF theo cùng quy ước với vỏ inox: đường cắt ở lớp CUT, đường gấp nét đứt ở lớp BEND, ghi chú cách gấp ở lớp NOTE. Ở đường gấp, xưởng chỉ rạch rãnh chữ V sâu khoảng 2/3 bề dày, không cắt đứt. Một tấm 1220 × 2440 xếp vừa 4 miếng thân. 4 miếng đáy cắt từ một tấm lẻ khoảng 0,65 × 0,65 m.

1. Cắt CNC theo 2 file DXF, mỗi file 4 miếng: đường viền, lỗ thông khí, lỗ tay nắm, lỗ rivet Ø4,1. Rạch rãnh gấp ở các đường lớp BEND.
2. Gấp thân thành ống vuông theo 4 rãnh, mép dán nằm bên trong mặt 1. Tán 8 rivet Ø4 có long đền.
3. Gấp 4 vạt đáy lên, đẩy đáy vào trong ống, tán 8 rivet quanh chân thùng.
4. Gấp 4 mảnh mép miệng ra ngoài. Hơ nóng nhẹ bằng máy khò nếu mép bị bật lại.
5. Gấp thử 1 thùng trước, đo lại, rồi mới cắt 3 thùng còn lại.

### Ngân sách cho 4 thùng

Hạng mục | Cơ sở tính | Ước tính
1 tấm PP 3 mm 1220 × 2440 (4 miếng thân) | Bảng giá các nhà bán năm 2026: 350–680k, phổ biến khoảng 535k | 350–680k
Tấm PP 3 mm cắt lẻ khoảng 0,65 × 0,65 m (4 miếng đáy) | Theo giá m² của tấm nguyên (khoảng 180k/m²), cộng phí cắt lẻ | 80–130k
Cắt CNC và rạch rãnh gấp | Khoảng 23 m đường cắt và 18 m rãnh. Bảng giá cũ khoảng 1.800 đ/m cho tấm 3 mm, nhưng xưởng thường tính phí tối thiểu | 100–200k
64 rivet nhôm Ø4 kèm long đền | 16 rivet mỗi thùng. Chưa tra giá trong nước | 40–60k
4 vòng chun ép túi | Chưa tra giá | 20k
Tổng 4 thùng | Khoảng 150–270k mỗi thùng. Đã có trong danh sách vật tư | 0,59–1,09 triệu

Rẻ hơn: tấm PP 2 mm (thành mềm hơn, dễ phồng) hoặc tấm PP rỗng (danpla, loại làm thùng carton nhựa; rất nhẹ và rẻ nhưng khe rỗng dễ đọng nước). Cả hai loại này chưa tra giá. Thùng tự gấp không kín nước hoàn toàn, vì nước rỉ qua rivet và lỗ thông khí xuống khay ngăn kéo.

### Màu nắp inox

Nắp trên, 2 hông, lưng, tấm che trước và 2 mặt ngăn kéo đều bằng inox 304 dày 1 mm (đổi từ Formex ngày 31/10). Mỗi tấm gấp mép kín 10 mm ở cả 4 cạnh, mặt gấp quay vào khung, nên không lộ cạnh cắt. Màu nắp:

Bạc là inox phun cát hoặc để mặt 2B. Các màu khác cần mạ PVD, đắt so với một tấm nắp nhỏ. Ở tab này vỏ được vẽ trong suốt để thấy khung; mở tab “Tổng quan · 3D” để xem vỏ đặc.

### Khung V lỗ, vỏ inox: lắp

- Chân: bắt chân tăng chỉnh M8 vào đai ốc hàn dưới 4 bản đế. Đặt chân cột lên bản đế.
- Khung: lắp như kệ kho: thanh ngang đặt chồng lên mặt trong cánh cột, bulông kệ M8 đầu tròn cổ vuông xuyên lỗ V từ ngoài vào, đai ốc ở trong. Thanh dưới hai bên kẹp luôn tai của bản đế chân (dùng M8×15). Hai thanh gặp nhau ở góc thì cánh nằm của thanh này đè lên cánh nằm của thanh kia. Đo 2 đường chéo, phải bằng nhau; siết kèm long đền vênh vì servo chạy gây rung.
- Không có thanh dưới phía trước: chỗ đó để khay ngăn kéo chạy ra. Tấm sàn bắt 3 bulông M8×30 vào 3 thanh dưới còn lại; 4 góc tấm khoét 28 × 28 để chừa tai bản đế và đai ốc bulông khung.
- Tấm bắt ray: alu composite 6 mm dài 670 mm, bắt vào lỗ cột trước và cột sau qua 4 ống lót 18 mm mỗi tấm. Vách giữa mang 2 ray quay lưng vào nhau: dùng vít đầu thấp và so le lỗ 2 ray để đai ốc bên này không cọ ray bên kia.
- Vỏ inox: cách mặt ngoài cột 6 mm (chừa mũ bulông kệ cao khoảng 4–5 mm và ke ốp ngoài nếu dùng). Bắt vít M4 inox có ống cách 6 mm vào lỗ V.
- Nắp inox: mép gập trùm xuống ngoài vỏ, bắt 2 vít ở mỗi góc vào đầu cột.

Đã có trong CAD: 35 bulông khung (cỡ và vị trí trong dimensions.json, mục body_fasteners). Chưa có: lỗ V của thanh (chưa đo được khoảng cách tâm lỗ tới góc) và lỗ vít trên vỏ inox. Đo 1 thanh V thật trước khi khoan vỏ.

### Thay túi

 ┌─────────┬─────────┐
 │ 2 Giấy  │ 1 Nhựa  │ ← sát tường
 ├─────────┼─────────┤
 │ 3 K.loại│ 4 Khác  │ ← phía trước
 └────↓────┴────↓────┘
  ngăn kéo   ngăn kéo
    trái       phải

Rút túi tại chỗ: thùng không phải nhấc ra, chỉ nhấc túi. Đây là cách rẻ và đơn giản nhất: mỗi thùng chỉ thêm 1 vòng dây chun bản 10 mm và 4 lỗ thông khí, tốn khoảng 20k cho cả 4 thùng.

1. Kéo ngăn kéo ra hết. Công tắc ở cuối ngăn kéo cắt nguồn servo và khoá 2 ngăn của nó.
2. Tháo vòng chun ở miệng thùng, gom miệng túi lại rồi buộc.
3. Nhấc túi thẳng lên. 4 lỗ Ø10 ở đáy cho khí vào dưới túi, nên túi không bị hút dính vào thùng.
4. Lót túi mới, lộn miệng túi trùm ra ngoài vành thùng khoảng 5 cm, rồi lồng vòng chun vào ép lại (cách miệng 12 mm).
5. Đẩy ngăn kéo vào rồi xác nhận trên màn hình là đã lót túi.

Túi cần rộng ít nhất 55 cm, dài ít nhất 82 cm. Nên dùng túi có dây rút để buộc nhanh. Ngăn kéo kéo ra hết thì thanh ngang trước của khung (rộng 20 mm) vẫn nằm phía trên miệng thùng sau, cách mép sau của miệng 10–30 mm và cao hơn miệng 404 mm. Khi nhấc túi, nghiêng túi về phía trước một chút là qua.

### Lỗi hay gặp

- Hai ray không song song: ngăn kéo sẽ bị kẹt. Bắt ray lên tấm phẳng, đo hai đầu lệch nhau không quá 1 mm.
- Ngăn kéo nặng: 2 thùng đầy giấy ướt có thể tới 19–25 kg; ray First Slide chịu 45 kg/cặp.
- Khung bị lệch vuông góc: lắp xong đo hai đường chéo của khung, phải bằng nhau.
- Cạnh inox sắc: mép đã gấp kín, nhưng lỗ tay nắm 120 × 30 trên mặt ngăn kéo vẫn là cạnh cắt: mài cạnh hoặc nẹp viền cao su.
- Siết bulông V lỗ không đủ chặt: khung rung theo servo và kêu. Dùng long đền vênh, kiểm tra lại sau 1 tuần chạy.
- Thùng nặng khoảng 40 kg (ước tính): sắt V lỗ nặng hơn nhôm. Lắp 4 chân tăng chỉnh, hoặc chân có bánh xe khoá.
- Ngân sách: tổng vật tư khoảng 8,3 triệu (sheet 02/11), vượt ngân sách 5 triệu. Chi tiết ở trang Vật tư trên CAD (https://claude.ai/artifact/5nJeV9B7Xnti5N8VQk3BP4).

### Chi tiết trong CAD (chỉ phần thân)

## Phần mềm và an toàn

Phần mềm chạy trên ESP32-S3 dưới dạng một máy trạng thái: tại mỗi thời điểm máy chỉ ở đúng một trạng thái, và chỉ chuyển sang trạng thái khác khi thoả điều kiện. Cách viết này giúp không bao giờ lỡ tay ra lệnh nghiêng khi chưa đủ điều kiện an toàn.

### Các trạng thái

Trạng thái | Làm gì | Chuyển sang
IDLE | Đĩa nằm ngang, LED xanh, chờ có vật. Màn hình lần lượt hiện các thông tin về rác, chữ to để người đi ngang đọc được | Camera thấy có thay đổi → SETTLE
SETTLE | Chờ vật nằm yên và miệng phễu không có tay liên tục 0,5 giây | → CLASSIFY
CLASSIFY | Đếm số vật, đo kích thước, nhận dạng loại | Nhiều hơn 1 vật hoặc vật quá cỡ → HOLD. Không chắc loại → ngăn 4. Còn lại → CHECK
CHECK | Ngăn đích có đang đầy, ngăn kéo có đang rút không | Bị khoá → HOLD. Được → TILT
TILT | Nghiêng trong 0,8–1 giây theo T17, theo dõi IMU | Sau 1,5 giây mà lệch quá 5° → JAM. Tới góc → DWELL
DWELL / RETURN | Giữ 0,8 giây, rồi về nằm ngang trong 1 giây | → VERIFY
VERIFY | Chụp xem đĩa đã trống chưa, chưa trống thì lắc 2 lần | Trống → IDLE. Vẫn còn → HOLD
HOLD | Đĩa nằm ngang, LED đỏ, màn hình báo lý do | Hết lý do → IDLE
YAW_FAULT | Con quay của IMU thấy trục xoay quay khi không có lệnh, hoặc quay quá xa so với lệnh: ngắt relay servo, báo “Lỏng hoặc kẹt trục xoay” | Kiểm tra xong, người dùng xác nhận → BOOT
JAM | Đưa đĩa về, khoá ngăn đích, báo kẹt | Người dùng xác nhận đã gỡ → IDLE
BOOT | Đọc góc IMU, đưa đĩa về nằm ngang thật chậm, tự kiểm tra 4 cảm biến | → IDLE

### Nhận dạng

- Mô hình nhỏ chạy ngay trên ESP32-S3, ví dụ MobileNet ảnh 96×96, phân 4 lớp: Nhựa, Giấy, Kim loại, Khác.
- Độ tin dưới ngưỡng (khởi đầu đặt 0,7) thì cho vào ngăn 4 “Khác”.
- Tự chụp khoảng 200 ảnh mỗi lớp ngay trên đĩa thật, dưới đèn LED thật để huấn luyện.
- Khả năng chạy được trên ESP32-S3 là plausible, độ chính xác chưa biết. Phải thử mới có số.

### Hiệu chỉnh lần đầu

1. Đặt thước thuỷ lên đĩa, chỉnh servo cho đĩa nằm ngang, lưu giá trị IMU làm mốc 0.
2. Nghiêng thử từng ngăn, kiểm tra hướng có đúng ngăn không. Nếu ngược thì đảo chiều servo.
3. Chụp ảnh đĩa trống làm ảnh mẫu, dùng để kiểm tra đĩa trống và phát hiện camera bẩn.
4. Đo khoảng cách tới đáy từng ngăn khi trống, lấy làm mốc 0% đầy. Thân B phải ra khoảng 960 mm. Ra khoảng 400 mm là cảm biến đang nghe mép túi hoặc thanh chữ thập, khoảng 110 mm là nghe diềm hoặc mép đĩa: chỉnh lại hộp cho thẳng rồi đo lại.

## Các giải pháp T: trạng thái cuối

## 45 bad case và cách đối phó

Các con số dựa trên thiết kế hiện tại: miệng phễu Ø550, cổ phễu Ø330, đĩa nhôm Ø320, khe giữa đĩa và cổ phễu 5 mm, xoay ±45° rồi nghiêng 45°, chặn cứng ở 47°, servo MG996R và MG90S (phương án D).
