trawngson/aware/design/ab/lap-truyen-dong-d.html

aware · thân B · cụm đầu · phương án D · CAD sinh lại ngày 01/11 theo kích thước thật

# Lắp truyền động D

Mọi chi tiết và mọi bulông trên trang lấy từ CAD (b_frame/mesh.json và dimensions.json). Các linh kiện mua sẵn đã vẽ theo kích thước tra từ catalogue và bảng của nhà sản xuất (gối KP08, KFL08, mặt bích, puly, servo, horn). 25 tư thế xoay và nghiêng không chi tiết nào chồng nhau, 42 bulông và vít đều đi qua lỗ thông.

Chi tiết của bước đang xem Đã lắp ở bước trước Bulông, vít của bước đang xem Chi tiết mới thêm vào CAD

Đang tải mô hình CAD (khoảng 5 MB)…

← Bước trước Bước sau → Xem đủ 9 bước Hiện mờ các bước sau Nhìn vào bước này

Kéo để xoay, cuộn để phóng to, rê chuột lên chi tiết hoặc bulông để xem tên. Phễu, mâm và thùng đã ẩn cho dễ nhìn; thanh chữ thập giữ lại làm mốc.

## Sửa theo kích thước thật (01/11)

### Gối KFL08 và KP08

KFL08 trước vẽ theo loại trục 10 mm. Nay là bích 48 × 27, thân tròn Ø27, cao 12,5, lỗ cách 37 mm (cánh giá khoét rãnh ±1 mm). KP08 giữ 55 × 13 × 29, nhưng lỗ chỉ Ø4,8 nên mọi bulông gối đổi sang M4; vẽ thêm vòng trong nhô 1,5 mm.

### Mặt bích nối trục 8 mm

Loại phổ biến cho trục 8 mm là bích Ø32 × 3, cổ Ø16, cao 13, 4 lỗ M4 trên vòng Ø24, 2 vít trí M4. Đế xoay taro 4 lỗ M4. Trục đứng cắt 93 mm.

### Puly thật dài 16 và 17 mm

Puly 20T dài 16 (vành Ø16, cổ Ø16), cổ quay về servo để 2 vít trí bám trụ miếng nối. Puly 40T dài 17, 2 vành Ø29, cổ quay vào giữa để không đụng gối. Trục bản lề 200 mm. Đai nằm trong vùng răng của cả 2 puly.

### Servo và horn

MG996R cao 37 mm tới mặt bệ (42,7 là tới đỉnh trục then hoa), lùi vào trong để chứa horn nhôm Ø20 (4 lỗ ren M3) và miếng nối. Rãnh căng đai chuyển sang chiều đứng. Dây ra ở đầu gần trục. MG90S treo tai lên kệ, dùng horn chữ thập vì không kèm horn tròn.

### Vẫn phải đo hàng thật trước khi cắt và in

- Horn chữ thập của MG90S (kích thước đang để tạm) và số răng trục then hoa (20 hay 21).
- Khoảng cách lỗ tai MG996R (48,5 × 10, số cộng đồng tự đo) và lỗ có cao su đệm.
- Chiều dài 2 puly (17 hay 18 mm), đường kính vành puly 40T (26–29).
- Lỗ KFL08 (36–37), chiều cao KFL08 (11,5–13), đường kính trục inox mua về.

## Bulông và vít (CAD đếm)

Mối nối | Cỡ | Bước | SL
Đang đọc danh sách từ CAD…

Chưa tính: vít trí đi kèm puly và gối, chốt chặn M4 + ống lót (yaw_stop_pin), keo khoá ren, đai ốc cấy nhiệt M4 cho tai đĩa.
