trawngson/aware/design/ab/vat-tu-khung-3d.html

# Vật tư thùng rác trên CAD

Chọn một món trong danh sách: các chi tiết của món đó sáng màu cam trên mô hình CAD thân B. Kéo để xoay, cuộn để phóng to, bấm vào chi tiết để xem tên. Số liệu lấy từ sheet Vật tư thân B (https://docs.google.com/spreadsheets/d/1vzqrNroD9JphUqxbcaRoN8dWD1GZd_ALjCfd4plWBCY/edit) (tab 1 và tab 2) ngày 02/11. Thành tiền theo đơn giá thấp.

Tìm món

Đang tải mô hình CAD (khoảng 5 MB)…

Làm mờ phần còn lại Tách rời Nhìn toàn thùng

Mô hình lấy từ b_frame/mesh.json (150 chi tiết, phương án thân B Mix 2, vỏ inox). Board nhỏ, mạch hạ áp, relay, điện trở không vẽ riêng: chọn chúng sẽ sáng cả bệ màn hình, nơi chúng được lắp. Bulông, vít và rivet không vẽ thành khối; vị trí từng cái nằm trong dimensions.json và trên trang Mối ghép thân B.
