trawngson/aware/design/cad/viewer_v3_template.html

# Smart sorting bin

Raised walls · funnel onto one tipping plate · four blank-category bins

v3 · raised walls and funnel

## Water bottle example

▶ Play detection demoPauseReset

Detection and movement sounds

Sound starts with your click. No external audio files.

## View

AssembledCutaway · funnel and plateOuter shell hiddenExploded service viewTop view into the funnelTilt joint detail

## Plate direction

The demo uses the selected bin, or sub-bin 4 when the plate is level. This is an example route; category mapping is undecided.

## Inspection

Outer shellIntake funnelFour fill sensorsCut away the side facing you

Explode amount

## Provisional geometry

Full destination → keep the plate level and request service. The four bins stay separate; the plate does not send an item to a different category.

The bottle animation illustrates the sequence. It is not a rigid-body simulation or live sensor output. Actuator torque, surface friction and real-item tests remain to be resolved.

Illustrative detection sequence

Ready

Throw → scan → identify → tip → return

Drag to rotate · scroll to zoom · double-click to reset view
