trawngson/aware/.github/readme/screens/co2-saved.png

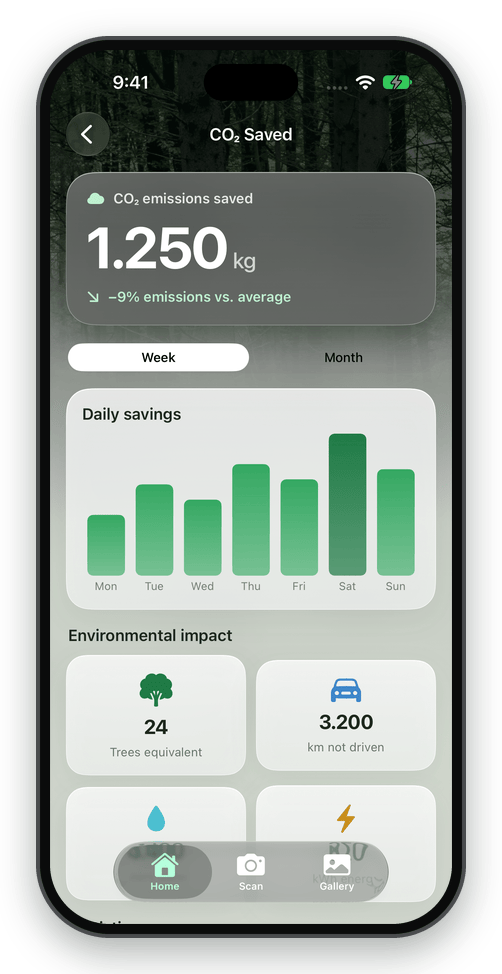
.github/readme/screens/co2-saved.png
