trawngson/aware/.github/readme/screens/gallery.png

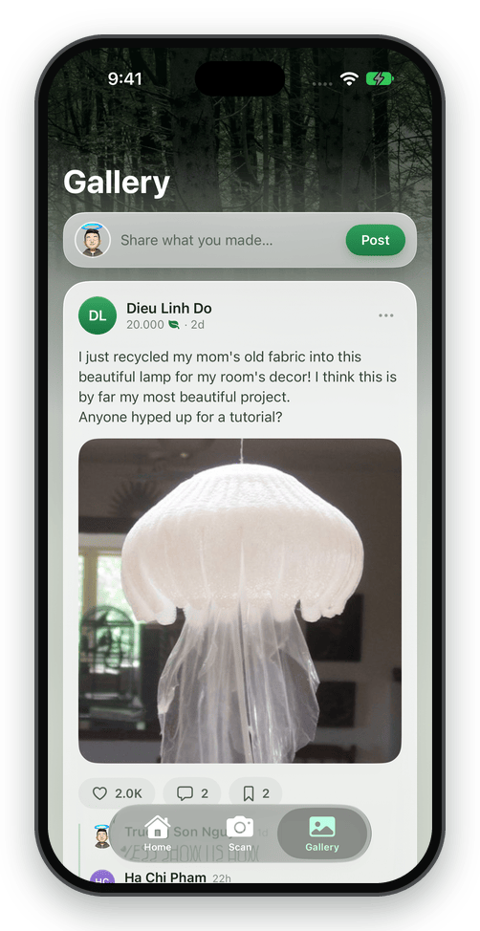
.github/readme/screens/gallery.png
