trawngson/aware/.github/readme/screens/home.png

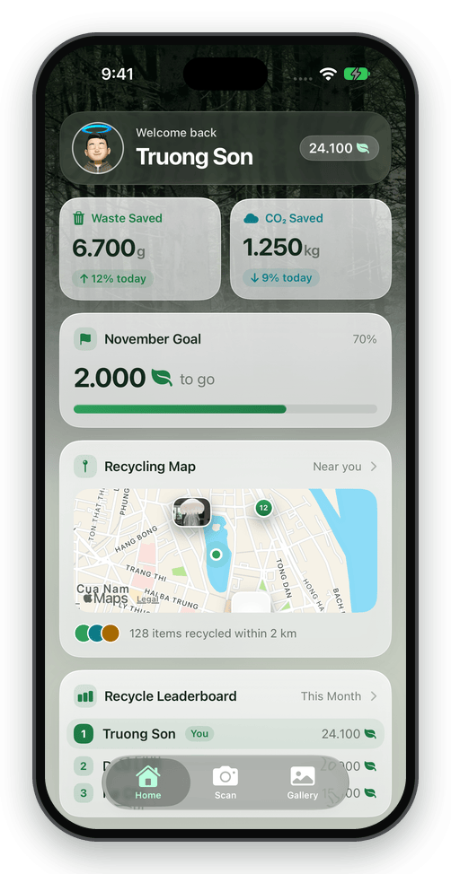
.github/readme/screens/home.png
