trawngson/aware/.github/readme/screens/recycling-map.png

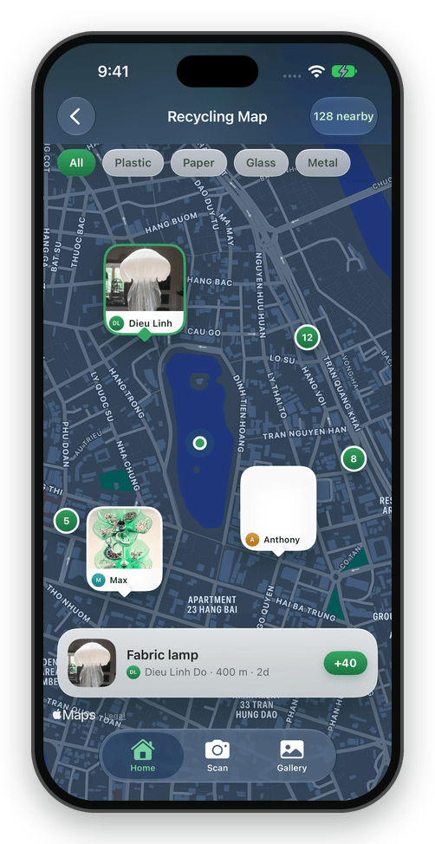
.github/readme/screens/recycling-map.png
