trawngson/aware/design/v3/exploded.png

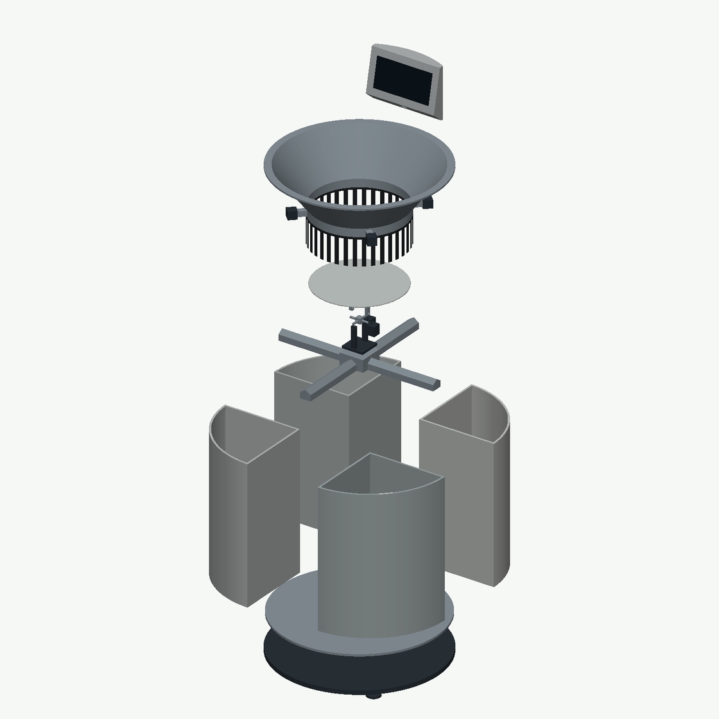
design/v3/exploded.png
