trawngson/aware/design/v3/internals.png

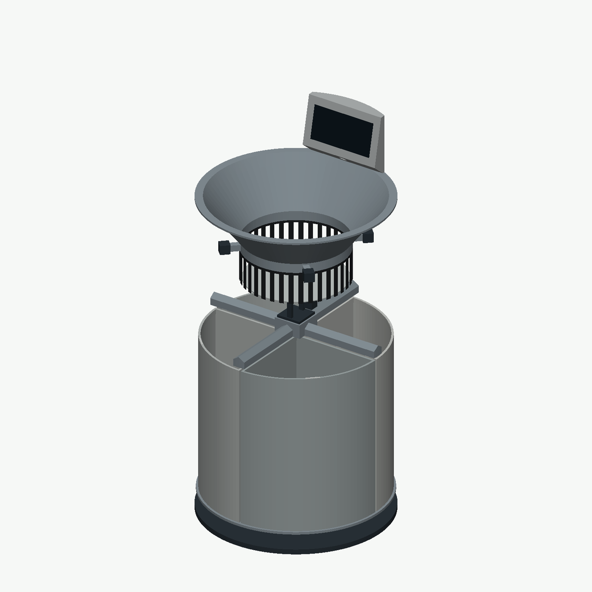
design/v3/internals.png
