trawngson/aware/design/v3/plan.png

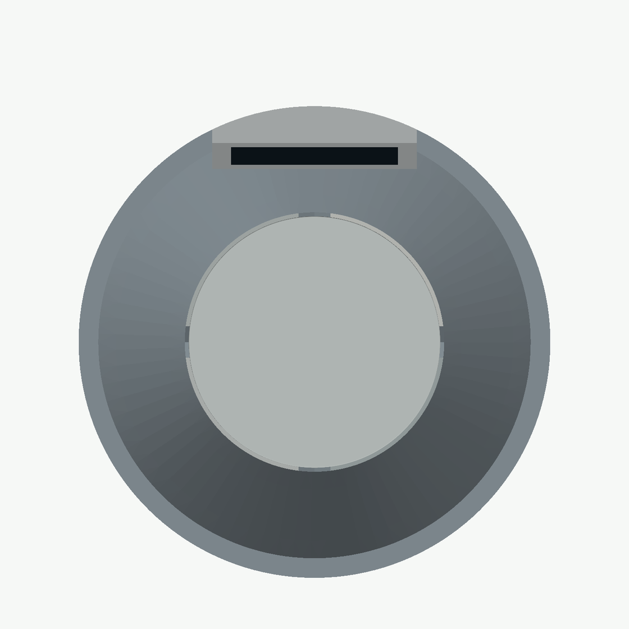
design/v3/plan.png
