trawngson/aware/design/v3/preview.png

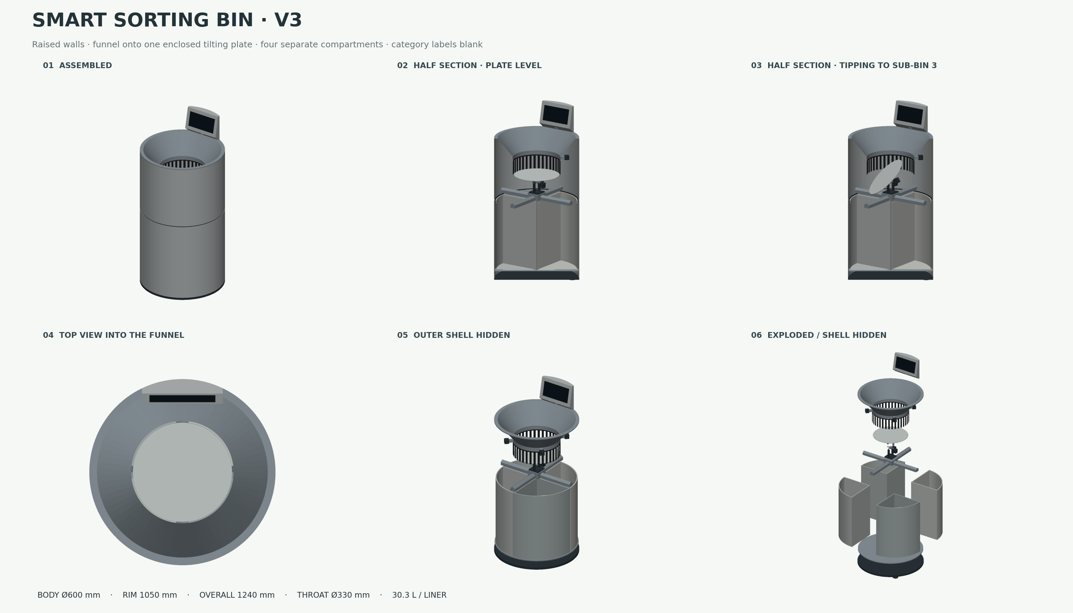
design/v3/preview.png
