trawngson/aware/design/v3/section.png

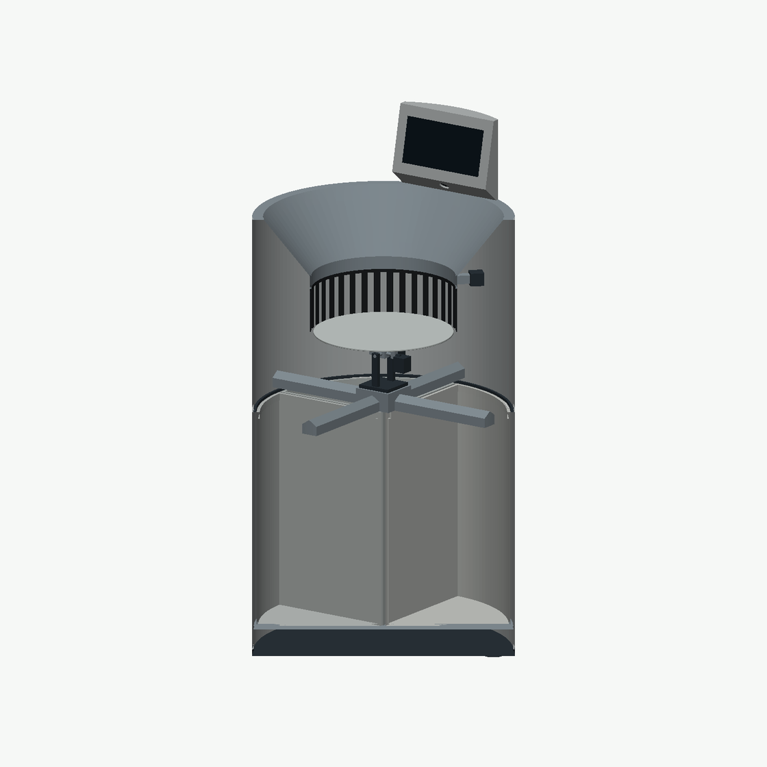
design/v3/section.png
