trawngson/aware/design/v3/smart_bin_assembly.step

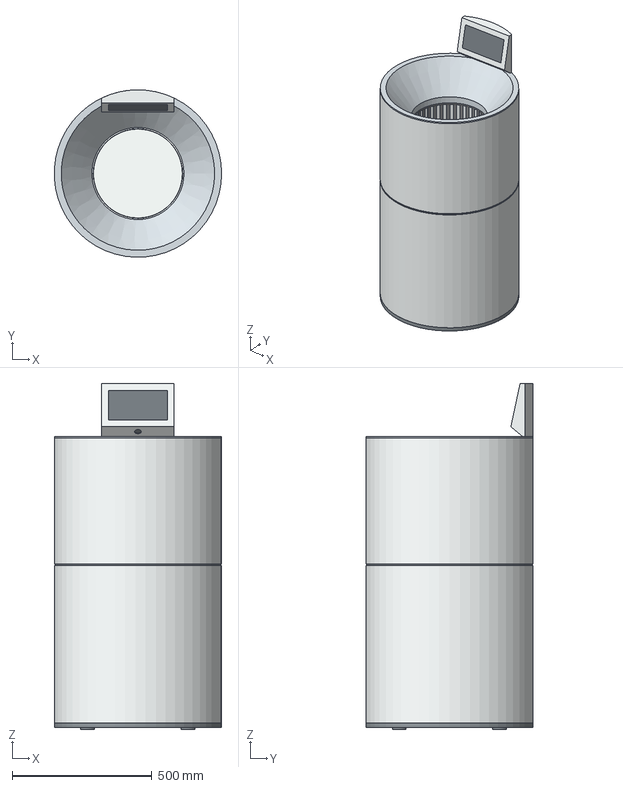
[picture p26: CAD file, 2026-10-09]
design/v3/smart_bin_assembly.step
599.4 x 599.9 x 1240.0 mm
outer_shell
plinth
liner_support_deck
foot_1
foot_2
foot_3
foot_4
sub_bin_1
blank_label_1
sub_bin_2
blank_label_2
sub_bin_3
blank_label_3
sub_bin_4
blank_label_4
head_seat_ring
head_shell
intake_funnel
flexible_throat_skirt
plate_support_spider
fixed_tilt_yoke
two_axis_cross_pin
moving_plate_yoke
single_detection_and_tipping_plate
pitch_actuator_envelope
roll_actuator_envelope
fill_sensor_housing_1
fill_sensor_window_1
fill_sensor_bracket_1
fill_sensor_housing_2
fill_sensor_window_2
fill_sensor_bracket_2
fill_sensor_housing_3
fill_sensor_window_3
fill_sensor_bracket_3
fill_sensor_housing_4
fill_sensor_window_4
fill_sensor_bracket_4
display_camera_console
blank_display_face
camera_lens_placeholder
