trawngson/aware/design/ab/b_frame/dxf/bin_floor_x4.dxf

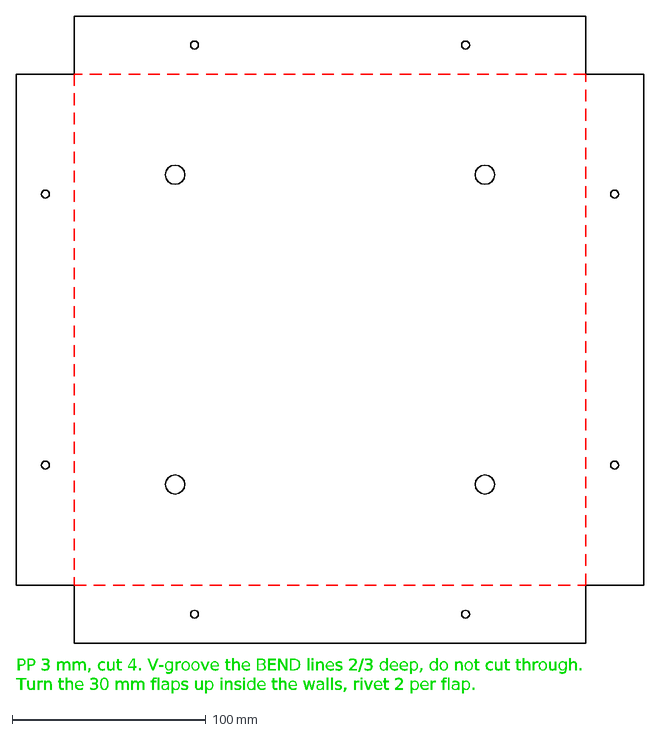
[picture p27: CAD file, 2026-11-06]
design/ab/b_frame/dxf/bin_floor_x4.dxf
PP 3 mm, cut 4. V-groove the BEND lines 2/3 deep, do not cut through.
Turn the 30 mm flaps up inside the walls, rivet 2 per flap.
