trawngson/aware/design/ab/b_frame/parts/foot_2.step

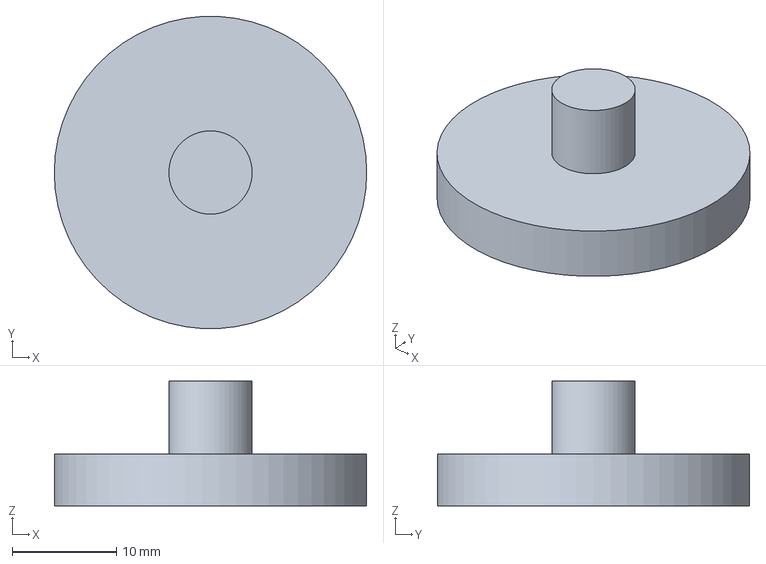
[picture p28: CAD file, 2026-11-06]
design/ab/b_frame/parts/foot_2.step
30.0 x 30.0 x 12.0 mm
