trawngson/aware/design/ab/b_frame/tilt_to_bin_4.step

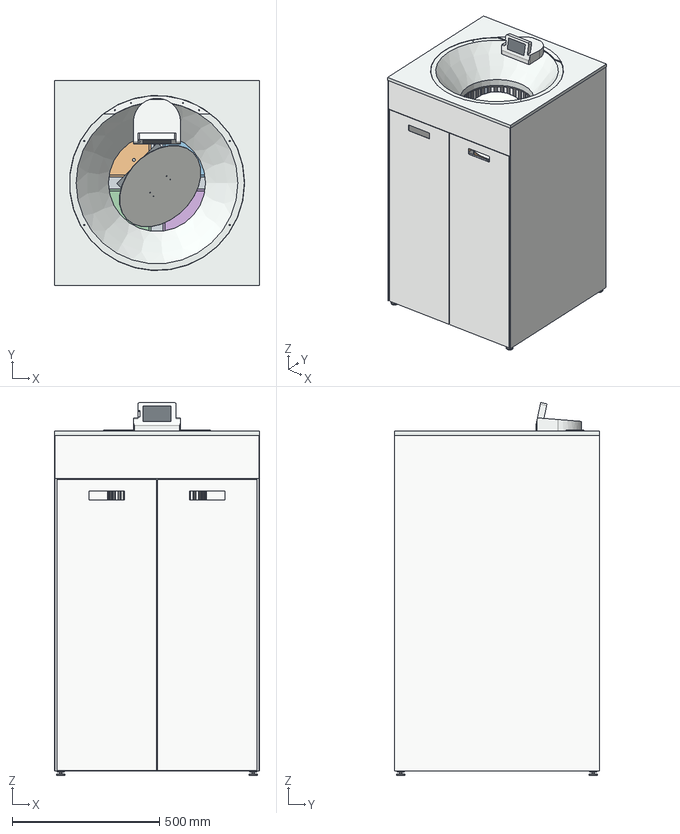
[picture p29: CAD file, 2026-11-06]
design/ab/b_frame/tilt_to_bin_4.step
698.0 x 698.0 x 1268.3 mm
head_deck
orientation_pin
head_locating_ring
locating_ring_clip_1
locating_ring_clip_2
locating_ring_clip_3
locating_ring_clip_4
head_shell_ring
shell_ring_clip_low_1
shell_ring_clip_high_1
shell_ring_clip_low_2
shell_ring_clip_high_2
shell_ring_clip_low_3
shell_ring_clip_high_3
shell_ring_clip_low_4
shell_ring_clip_high_4
intake_funnel
flexible_throat_skirt
hanger_1
hanger_insert_top_1
hanger_insert_bottom_1
hanger_2
hanger_insert_top_2
hanger_insert_bottom_2
hanger_3
hanger_insert_top_3
hanger_insert_bottom_3
hanger_4
hanger_insert_top_4
hanger_insert_bottom_4
joint_beam
beam_splice_plate
spider_foot_1
spider_foot_2
spider_foot_3
spider_foot_4
yaw_bracket
yaw_bearing_lower
yaw_bearing_upper
yaw_servo
yaw_servo_horn
yaw_hub
yaw_shaft
yaw_collar
yaw_flange
yaw_platform
hinge_post_1
hinge_block_1
hinge_post_2
hinge_block_2
tilt_servo
tilt_servo_bracket
tilt_servo_horn
tilt_pulley_adapter
tilt_pulley_small
tilt_belt
tilt_stop_pad_1
tilt_stop_pad_2
hinge_shaft
hinge_collar_1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
