trawngson/aware/design/v3/parts/flexible_throat_skirt.step

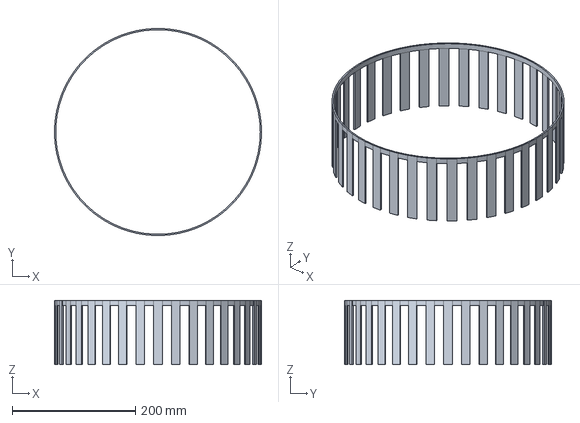
[picture p30: CAD file, 2026-10-09]
design/v3/parts/flexible_throat_skirt.step
336.0 x 336.0 x 104.0 mm
