trawngson/aware/design/ab/b_frame/dxf/drawer_stiffener_x4.dxf

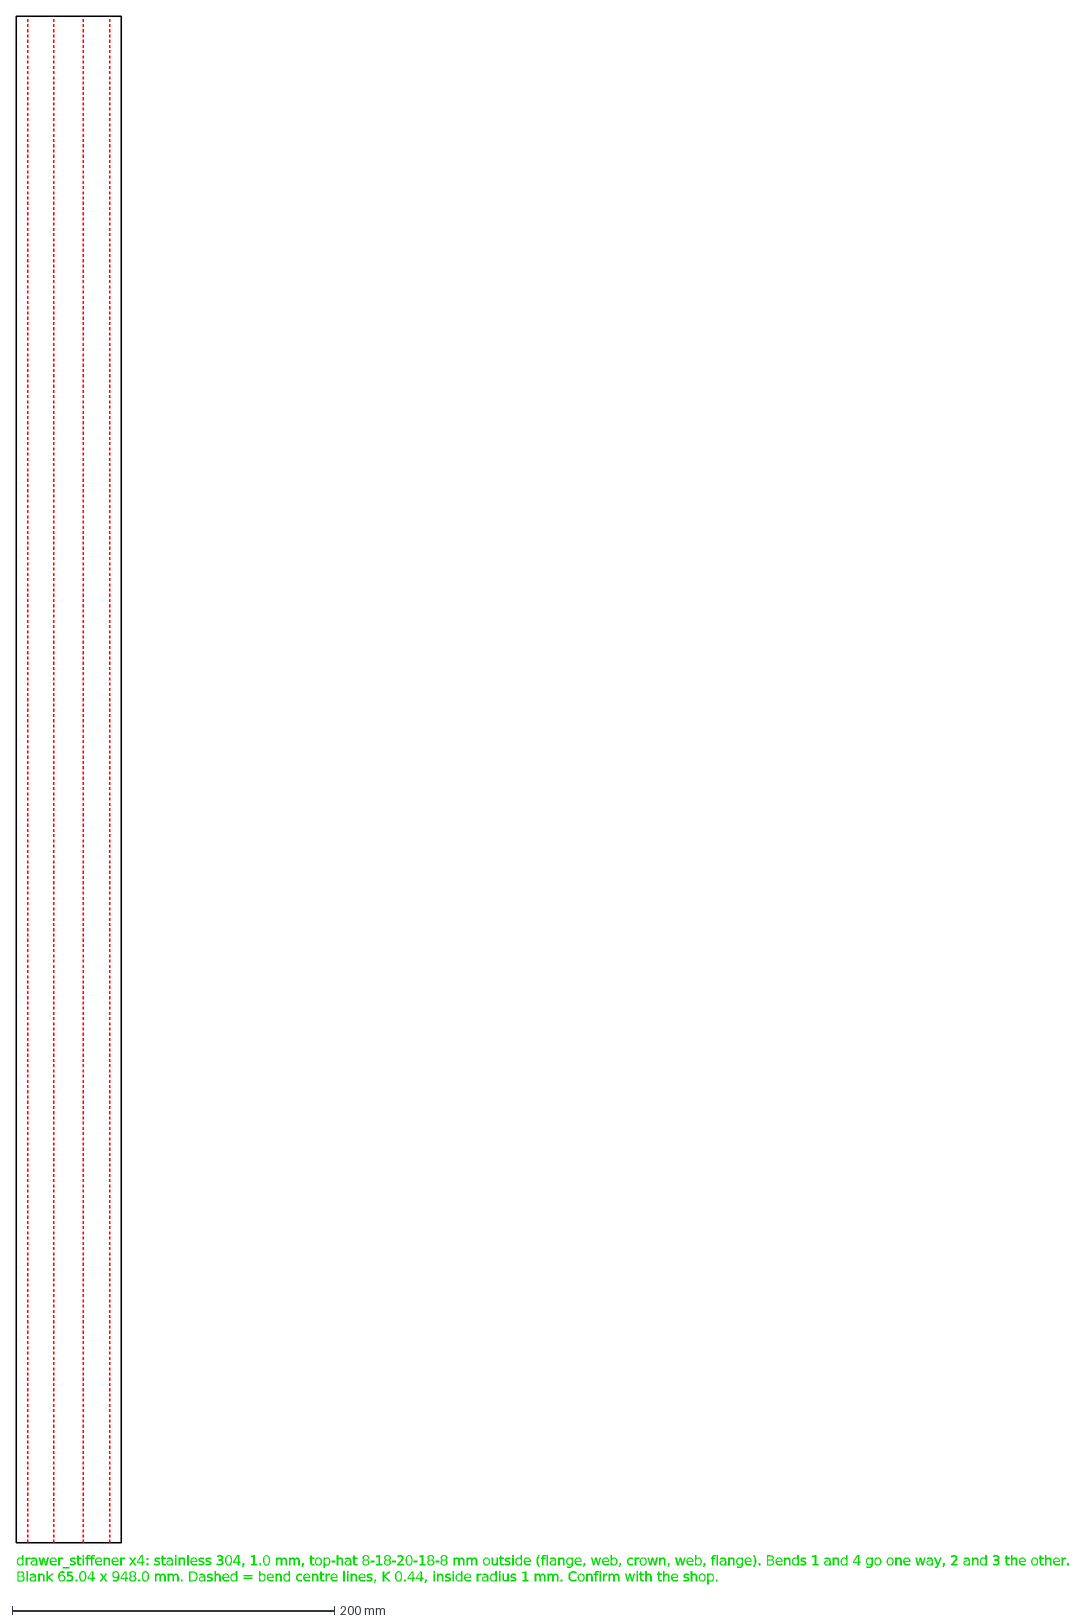
[picture p31: CAD file, 2026-11-06]
design/ab/b_frame/dxf/drawer_stiffener_x4.dxf
drawer_stiffener x4: stainless 304, 1.0 mm, top-hat 8-18-20-18-8 mm outside (flange, web, crown, web, flange). Bends 1 and 4 go one way, 2 and 3 the other.
Blank 65.04 x 948.0 mm. Dashed = bend centre lines, K 0.44, inside radius 1 mm. Confirm with the shop.
