trawngson/aware/design/ab/b_frame/parts/hinge_block_2.step

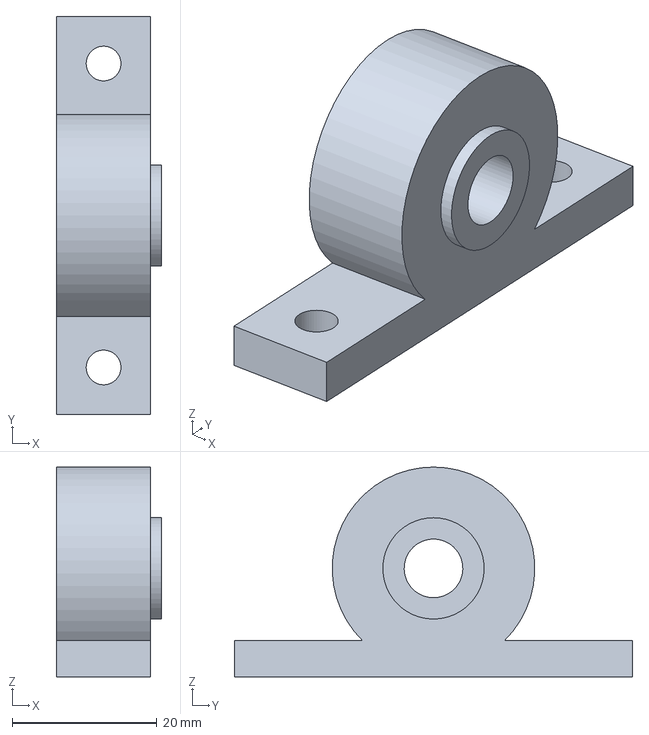
[picture p33: CAD file, 2026-11-06]
design/ab/b_frame/parts/hinge_block_2.step
14.5 x 55.0 x 29.0 mm
