trawngson/aware/design/v3/parts/sub_bin_1.step

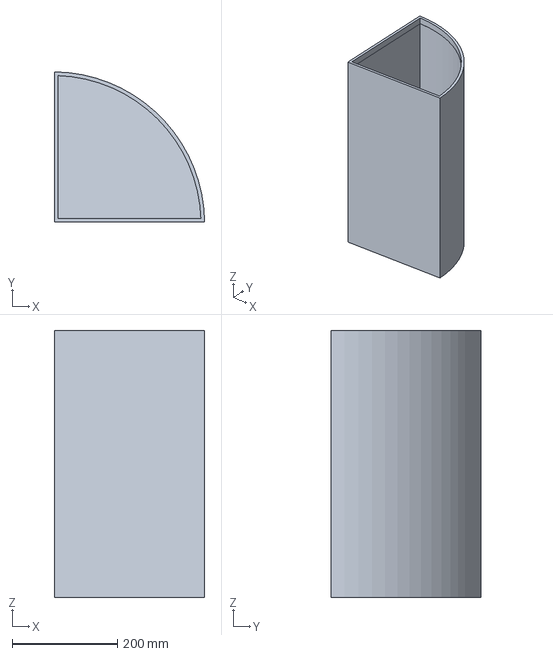
[picture p34: CAD file, 2026-10-09]
design/v3/parts/sub_bin_1.step
286.0 x 286.0 x 508.0 mm
