trawngson/aware/design/ab/b_frame/dxf/drawer_back_wall_pp_x2.dxf

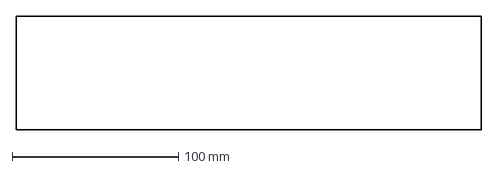
[picture p35: CAD file, 2026-11-06]
design/ab/b_frame/dxf/drawer_back_wall_pp_x2.dxf
279.6 x 68.0 mm
