trawngson/aware/design/ab/b_frame/parts/shell_ring_clip_low_4.step

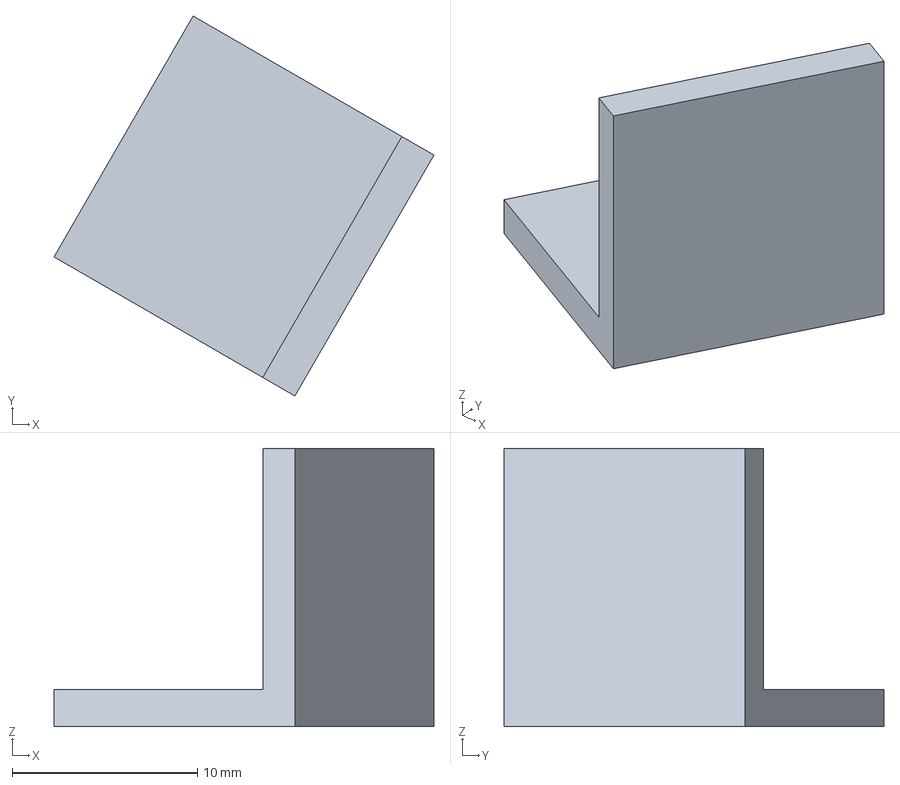
[picture p36: CAD file, 2026-11-06]
design/ab/b_frame/parts/shell_ring_clip_low_4.step
20.5 x 20.5 x 15.0 mm
