trawngson/aware/design/v3/parts/blank_label_1.step

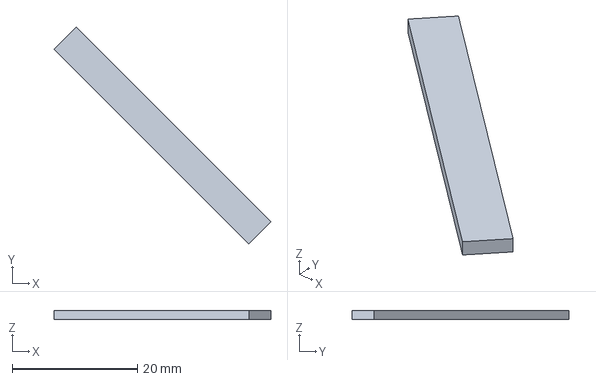
[picture p37: CAD file, 2026-10-09]
design/v3/parts/blank_label_1.step
34.6 x 34.6 x 1.50 mm
