trawngson/aware/design/ab/b_frame/dxf/head_shell_ring_strip.dxf

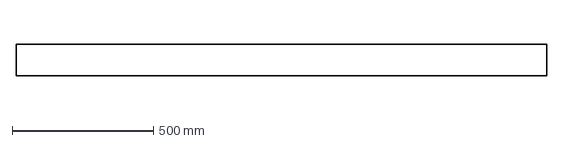
[picture p38: CAD file, 2026-11-06]
design/ab/b_frame/dxf/head_shell_ring_strip.dxf
1876.7 x 111.0 mm
