trawngson/aware/design/ab/b_frame/parts/tilt_pulley_large.step

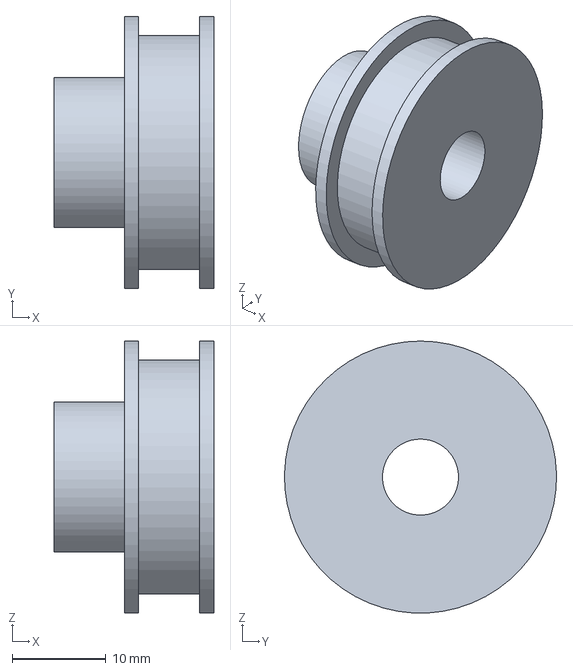
[picture p39: CAD file, 2026-11-06]
design/ab/b_frame/parts/tilt_pulley_large.step
17.0 x 29.0 x 29.0 mm
