trawngson/aware/design/v3/parts/liner_support_deck.step

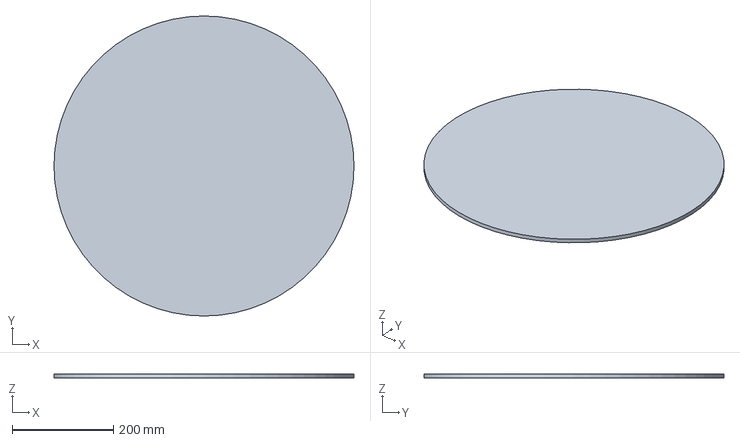
[picture p40: CAD file, 2026-10-09]
design/v3/parts/liner_support_deck.step
592.0 x 592.0 x 8.00 mm
