trawngson/aware/design/ab/b_frame/parts/tilt_pulley_small.step

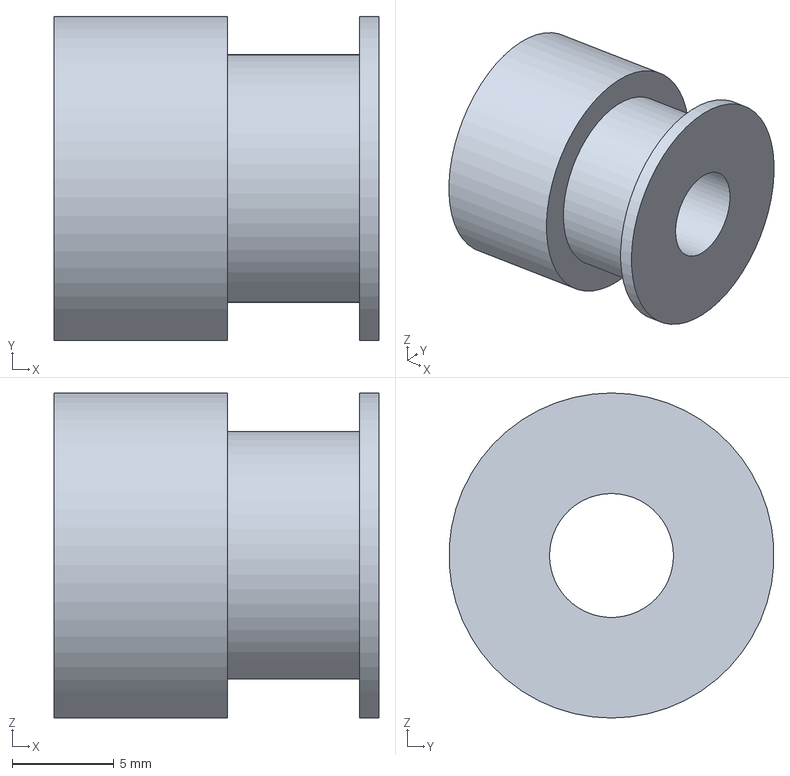
[picture p41: CAD file, 2026-11-06]
design/ab/b_frame/parts/tilt_pulley_small.step
16.0 x 16.0 x 16.0 mm
