trawngson/aware/design/v3/parts/outer_shell.step

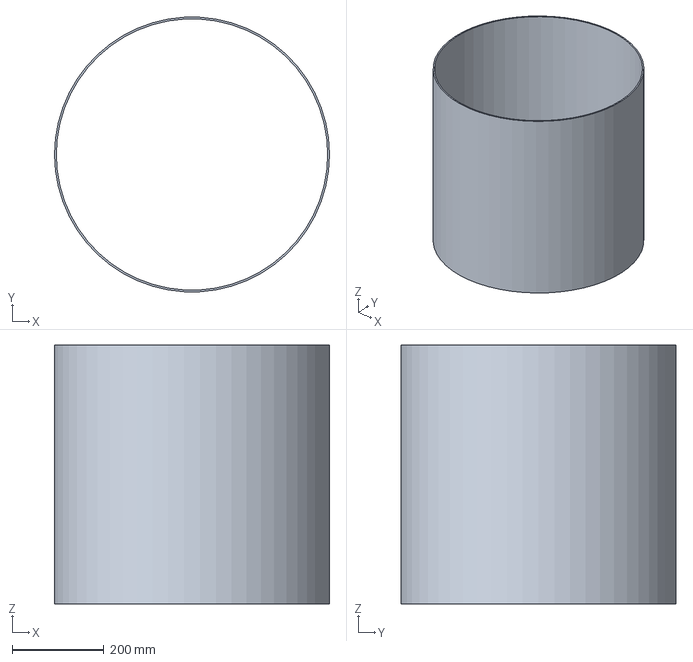
[picture p42: CAD file, 2026-10-09]
design/v3/parts/outer_shell.step
600.0 x 599.0 x 564.0 mm
