trawngson/aware/design/ab/b_frame/parts/hinge_collar_1.step

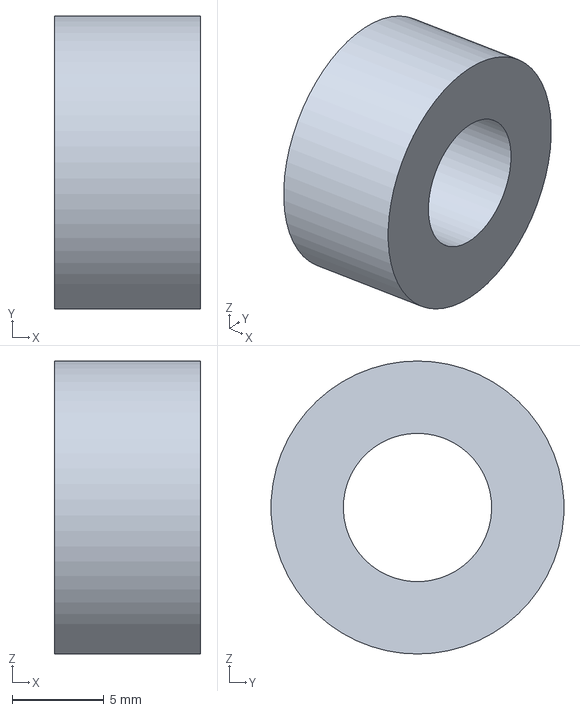
[picture p43: CAD file, 2026-11-06]
design/ab/b_frame/parts/hinge_collar_1.step
8.00 x 16.0 x 16.0 mm
