trawngson/aware/design/v3/parts/fill_sensor_housing_1.step

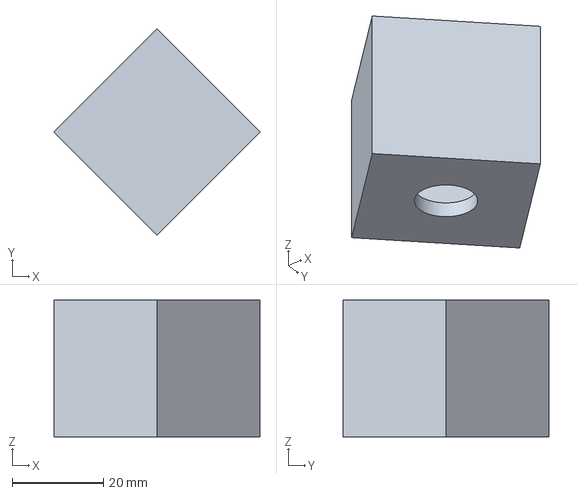
[picture p44: CAD file, 2026-10-09]
design/v3/parts/fill_sensor_housing_1.step
45.3 x 45.3 x 30.0 mm
