trawngson/aware/design/ab/b_frame/parts/slide_left_outer.step

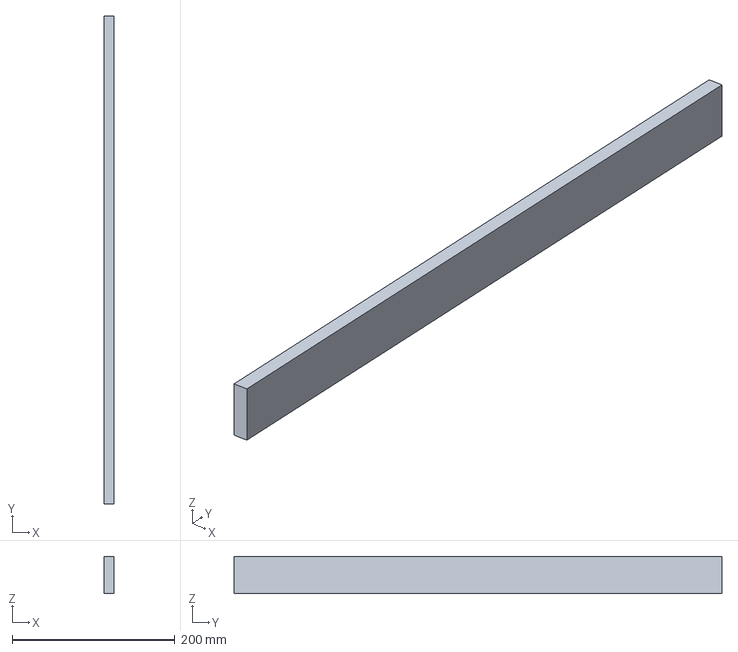
[picture p46: CAD file, 2026-11-06]
design/ab/b_frame/parts/slide_left_outer.step
12.7 x 600.0 x 46.0 mm
