trawngson/aware/design/v3/parts/fill_sensor_window_2.step

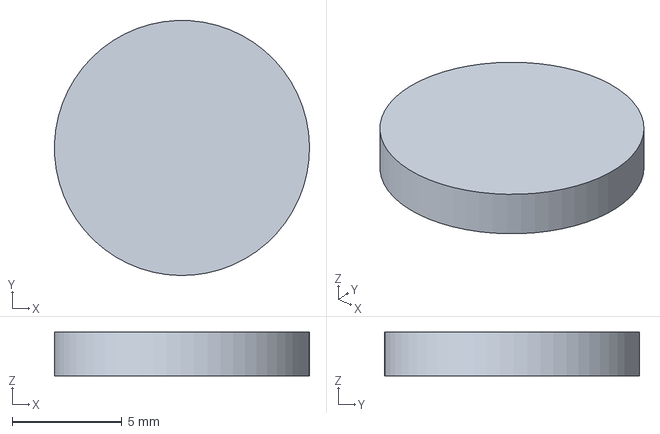
[picture p47: CAD file, 2026-10-09]
design/v3/parts/fill_sensor_window_2.step
11.6 x 11.6 x 2.00 mm
