trawngson/aware/design/ab/b_frame/parts/spider_foot_4.step

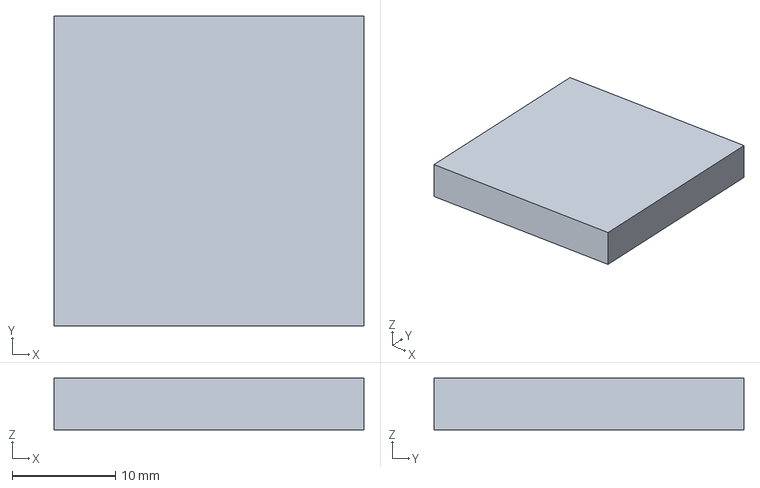
[picture p48: CAD file, 2026-11-06]
design/ab/b_frame/parts/spider_foot_4.step
30.0 x 30.0 x 5.00 mm
