trawngson/aware/design/v3/parts/camera_lens_placeholder.step

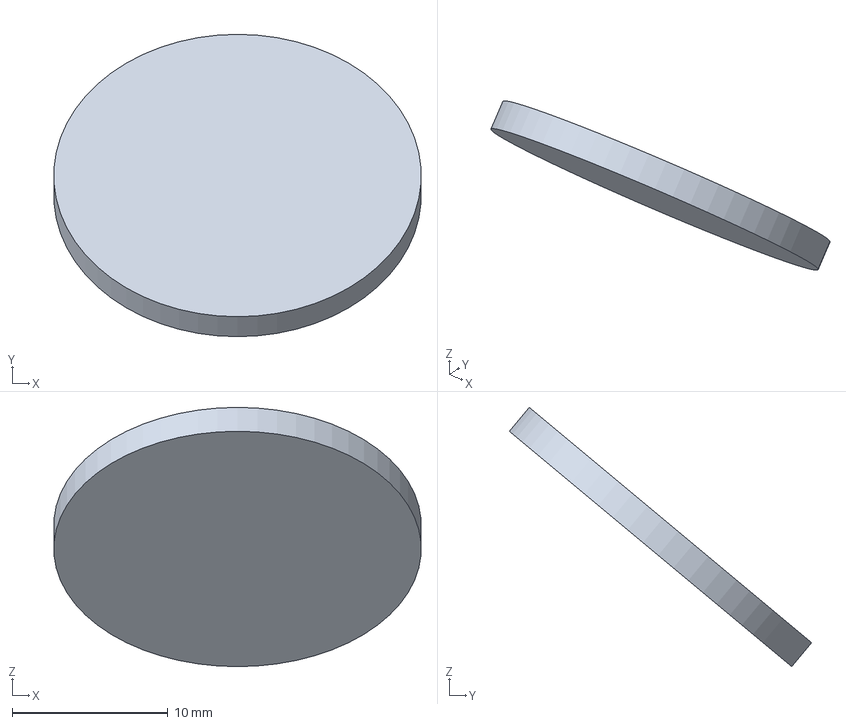
[picture p49: CAD file, 2026-10-09]
design/v3/parts/camera_lens_placeholder.step
23.6 x 19.4 x 16.6 mm
