trawngson/aware/design/ab/b_frame/parts/yaw_bearing_upper.step

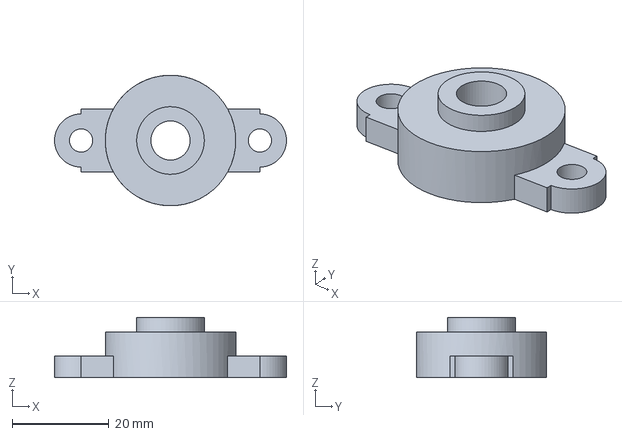
[picture p50: CAD file, 2026-11-06]
design/ab/b_frame/parts/yaw_bearing_upper.step
48.0 x 27.0 x 12.5 mm
