trawngson/aware/design/ab/b_frame/parts/floor_plate.step

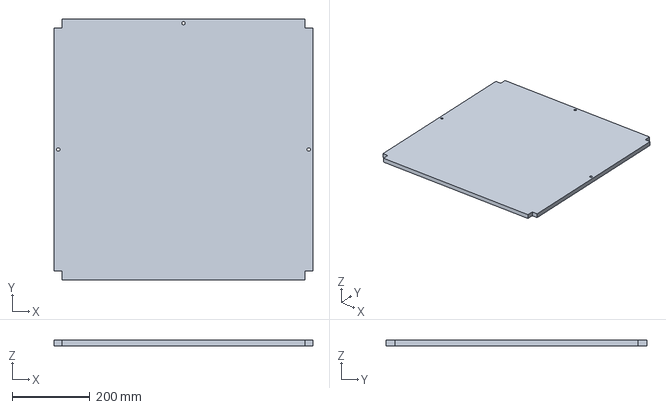
[picture p51: CAD file, 2026-11-06]
design/ab/b_frame/parts/floor_plate.step
666.0 x 672.0 x 15.0 mm
