trawngson/aware/design/v3/parts/two_axis_cross_pin.step

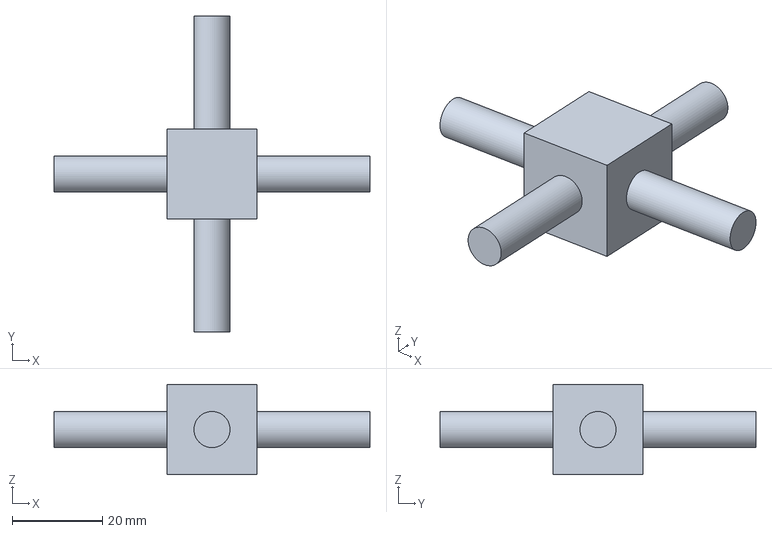
[picture p52: CAD file, 2026-10-09]
design/v3/parts/two_axis_cross_pin.step
70.0 x 70.0 x 20.0 mm
