trawngson/aware/design/ab/b_frame/parts/intake_funnel.stl

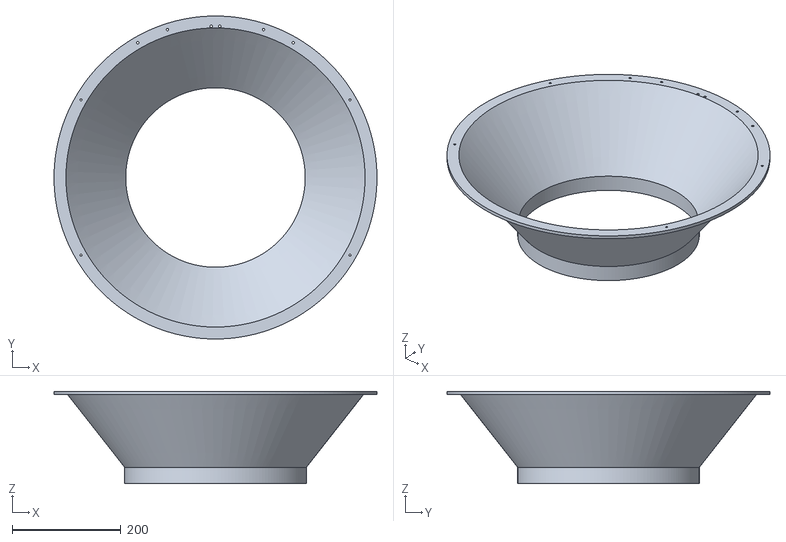
[picture p53: CAD file, 2026-11-06]
design/ab/b_frame/parts/intake_funnel.stl
594.0 x 593.9 x 170.0
