trawngson/aware/design/ab/b_frame/parts/side_panel_left.step

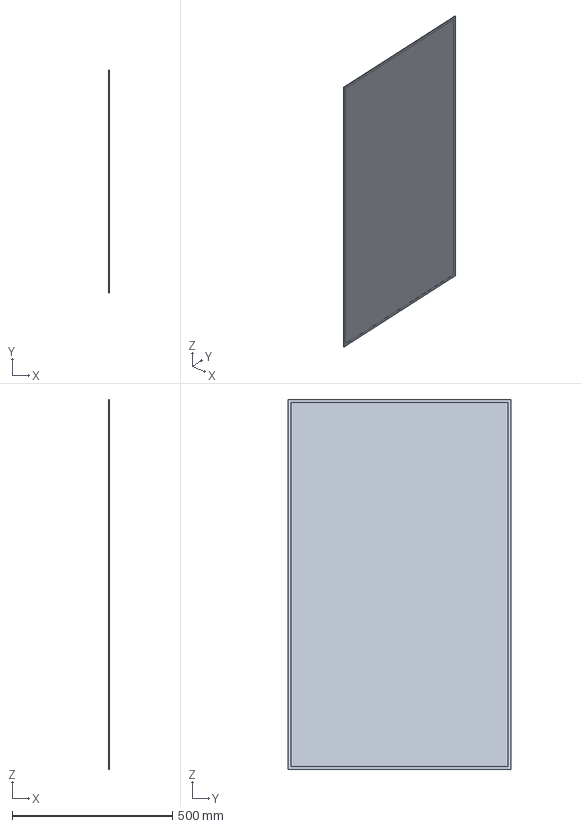
[picture p54: CAD file, 2026-11-06]
design/ab/b_frame/parts/side_panel_left.step
2.00 x 696.0 x 1155.0 mm
