trawngson/aware/design/v3/parts/head_seat_ring.step

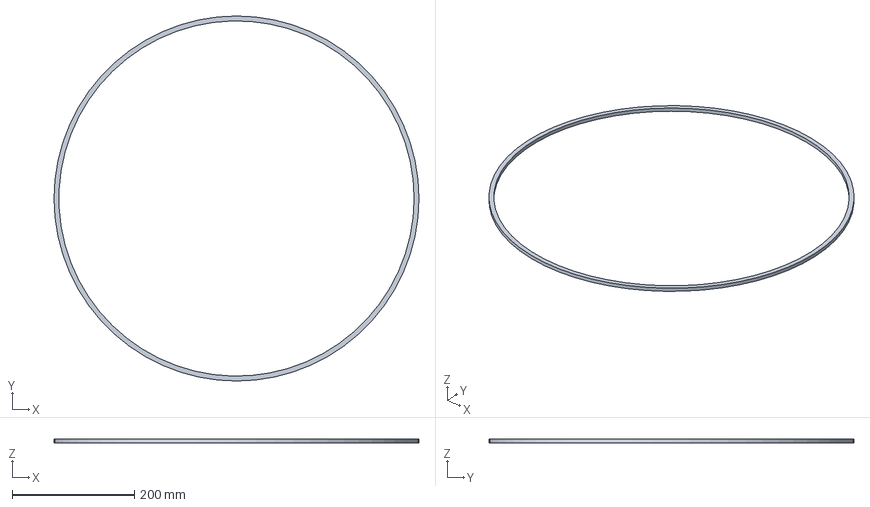
[picture p55: CAD file, 2026-10-09]
design/v3/parts/head_seat_ring.step
596.0 x 596.0 x 6.00 mm
