trawngson/aware/design/ab/b_frame/parts/drawer_stiffener_right_2.step

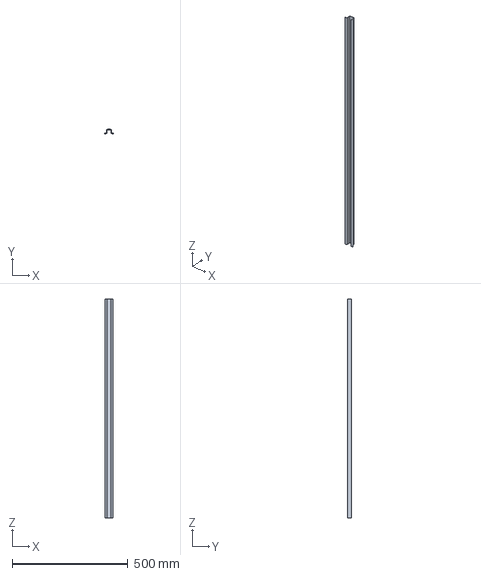
[picture p56: CAD file, 2026-11-06]
design/ab/b_frame/parts/drawer_stiffener_right_2.step
36.0 x 18.0 x 948.0 mm
