trawngson/aware/design/ab/b_frame/parts/hanger_insert_top_1.step

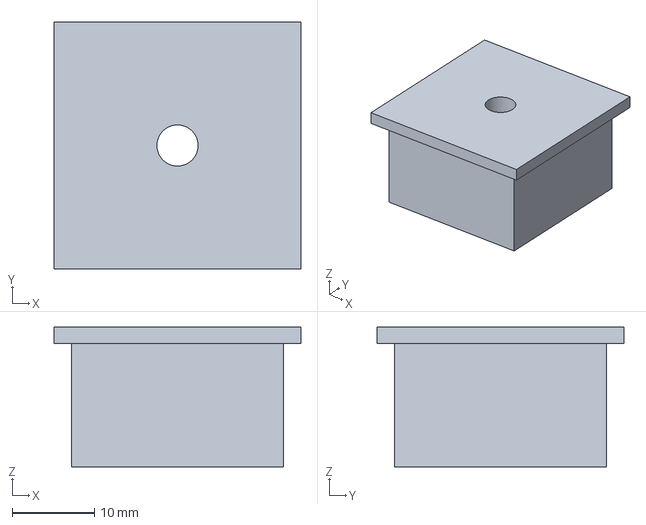
[picture p57: CAD file, 2026-11-06]
design/ab/b_frame/parts/hanger_insert_top_1.step
30.0 x 30.0 x 17.0 mm
