trawngson/aware/design/ab/b_frame/parts/head_locating_ring.step

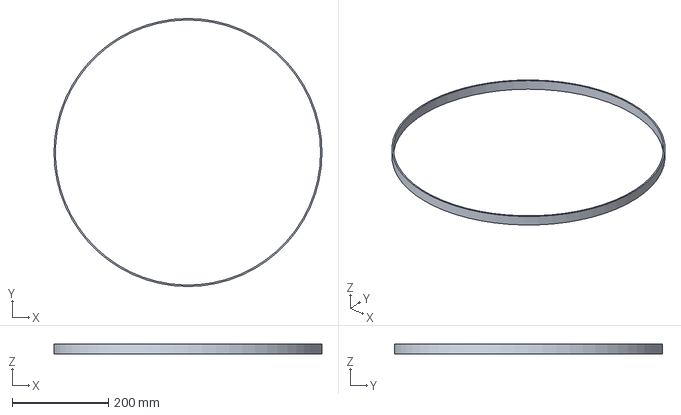
[picture p58: CAD file, 2026-11-06]
design/ab/b_frame/parts/head_locating_ring.step
556.0 x 556.0 x 20.0 mm
