trawngson/aware/design/ab/b_frame/parts/top_cover.step

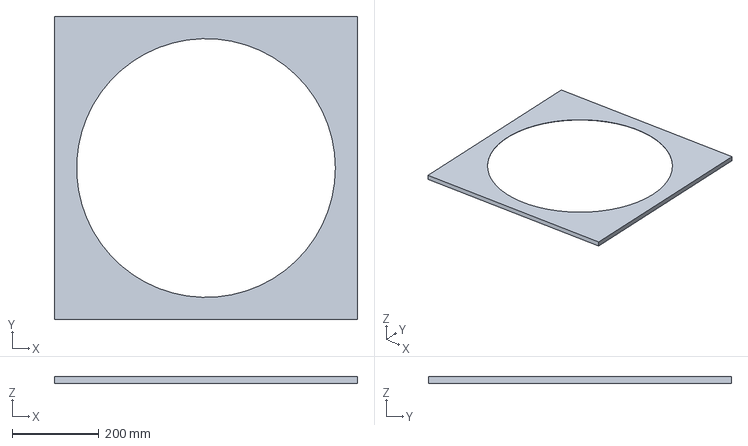
[picture p59: CAD file, 2026-11-06]
design/ab/b_frame/parts/top_cover.step
698.0 x 698.0 x 15.0 mm
