trawngson/aware/design/ab/b_frame/parts/yaw_hub.step

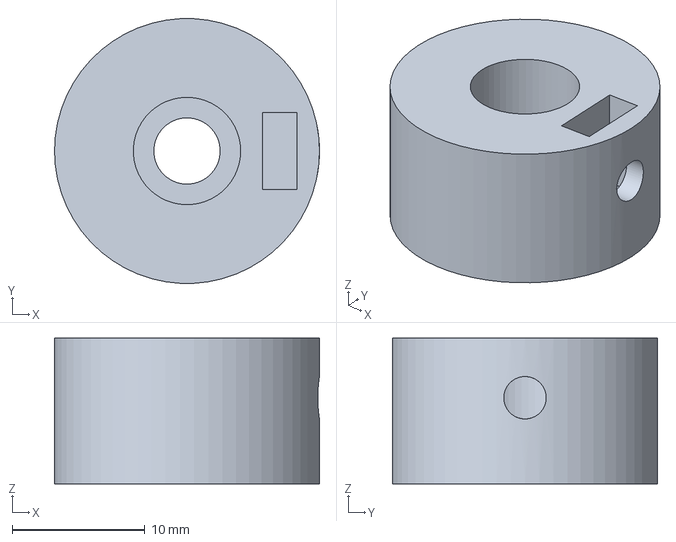
[picture p60: CAD file, 2026-11-06]
design/ab/b_frame/parts/yaw_hub.step
20.0 x 20.0 x 11.0 mm
