trawngson/aware/design/v3/parts/roll_actuator_envelope.step

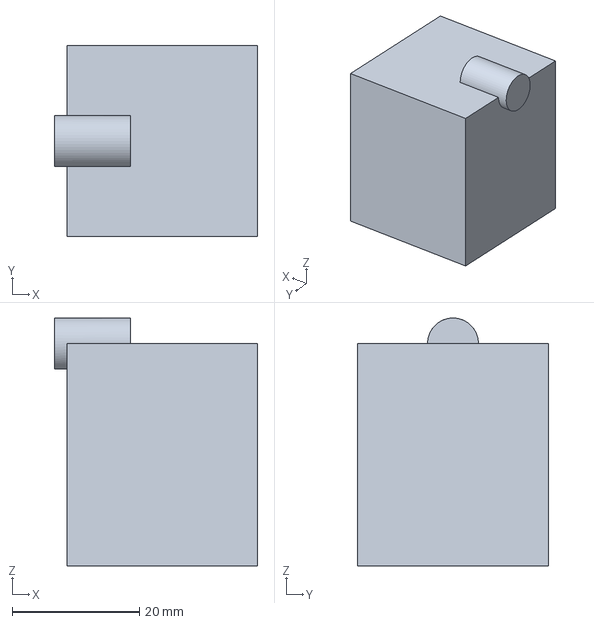
[picture p61: CAD file, 2026-10-09]
design/v3/parts/roll_actuator_envelope.step
32.0 x 30.0 x 39.0 mm
