trawngson/aware/design/v3/parts/fill_sensor_bracket_4.step

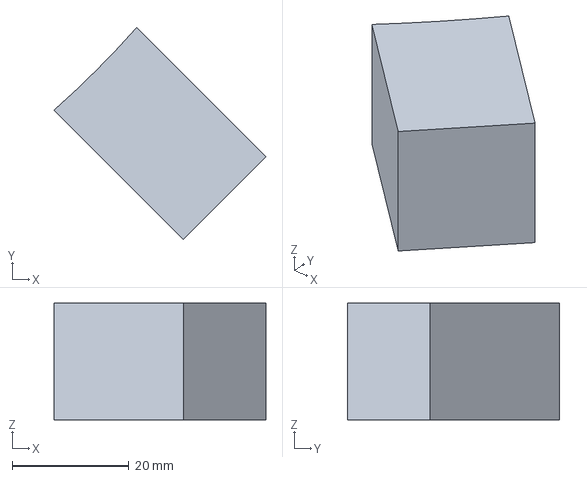
[picture p62: CAD file, 2026-10-09]
design/v3/parts/fill_sensor_bracket_4.step
36.3 x 36.3 x 20.0 mm
