trawngson/aware/design/ab/b_frame/parts/tilt_imu.step

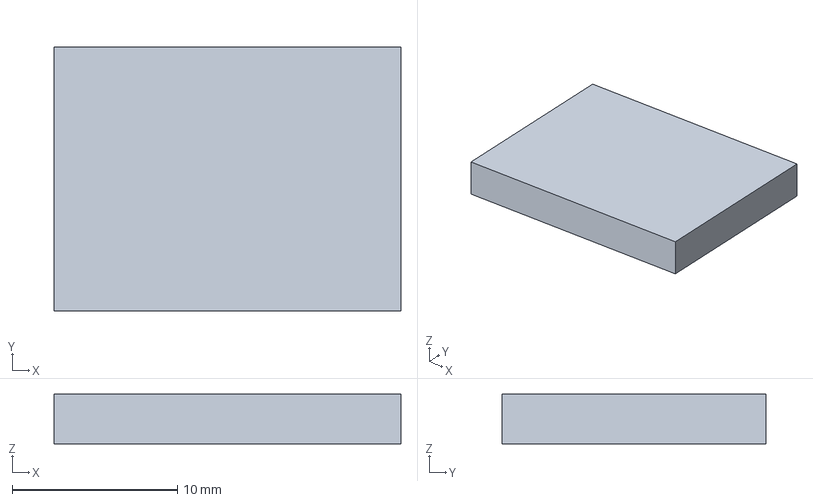
[picture p63: CAD file, 2026-11-06]
design/ab/b_frame/parts/tilt_imu.step
21.0 x 16.0 x 3.00 mm
