trawngson/aware/design/v3/parts/plinth.step

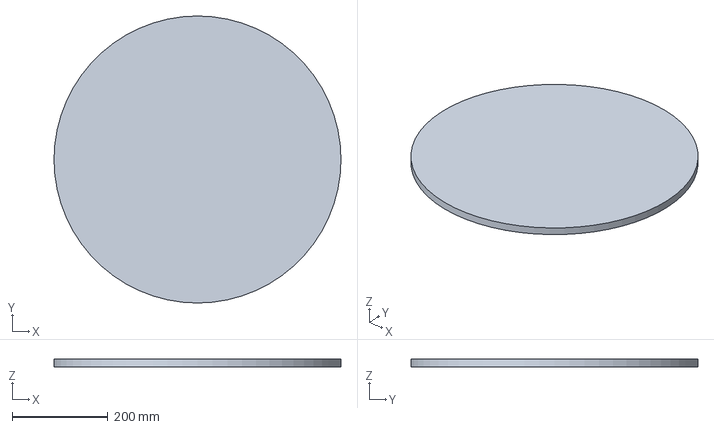
[picture p64: CAD file, 2026-10-09]
design/v3/parts/plinth.step
600.0 x 600.0 x 16.0 mm
