trawngson/aware/design/ab/b_frame/parts/fill_sensor_pod_3.stl

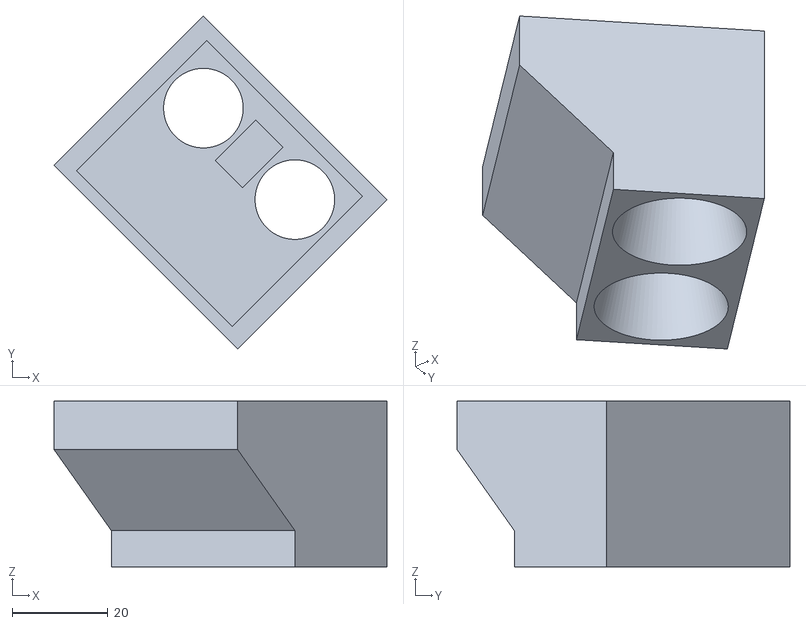
[picture p65: CAD file, 2026-11-06]
design/ab/b_frame/parts/fill_sensor_pod_3.stl
69.5 x 69.5 x 34.6
