trawngson/aware/design/ab/b_frame/parts/rail_seat_yn.step

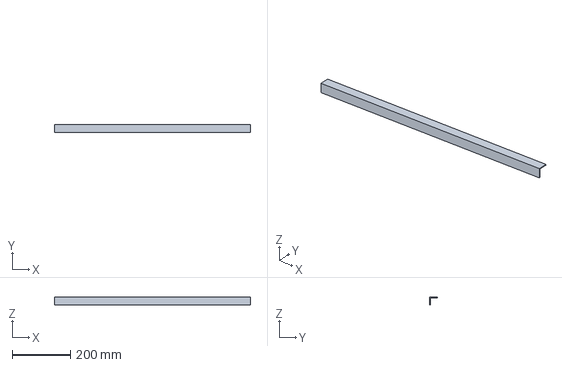
[picture p66: CAD file, 2026-11-06]
design/ab/b_frame/parts/rail_seat_yn.step
671.0 x 26.0 x 26.0 mm
