trawngson/aware/design/v3/parts/single_detection_and_tipping_plate.step

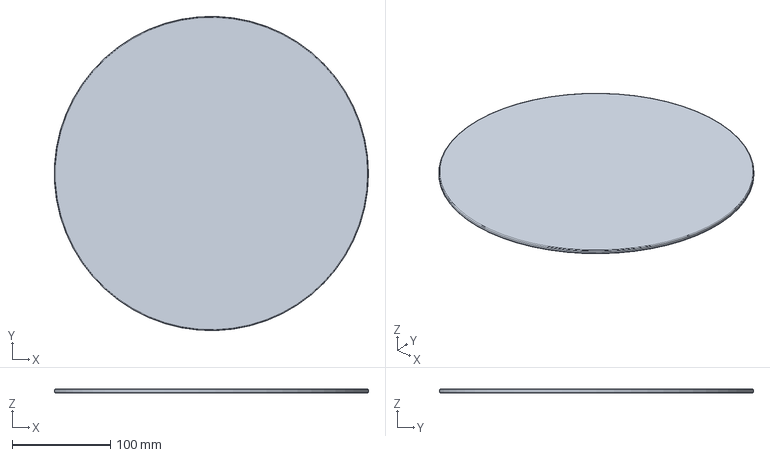
[picture p67: CAD file, 2026-10-09]
design/v3/parts/single_detection_and_tipping_plate.step
319.8 x 319.9 x 4.00 mm
