trawngson/aware/design/ab/b_frame/parts/post_3.stl

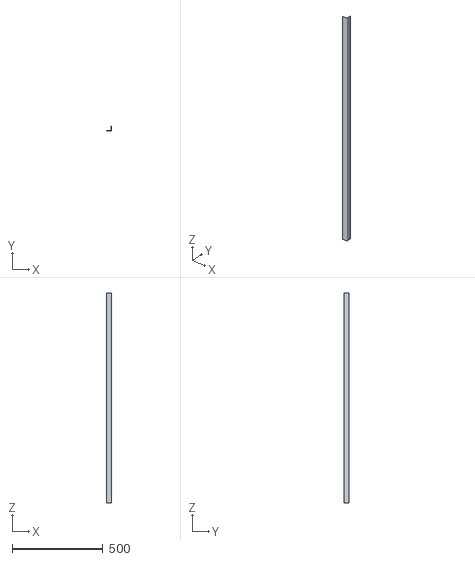
[picture p68: CAD file, 2026-11-06]
design/ab/b_frame/parts/post_3.stl
26.0 x 26.0 x 1155.0
