trawngson/aware/design/v3/parts/pitch_actuator_envelope.step

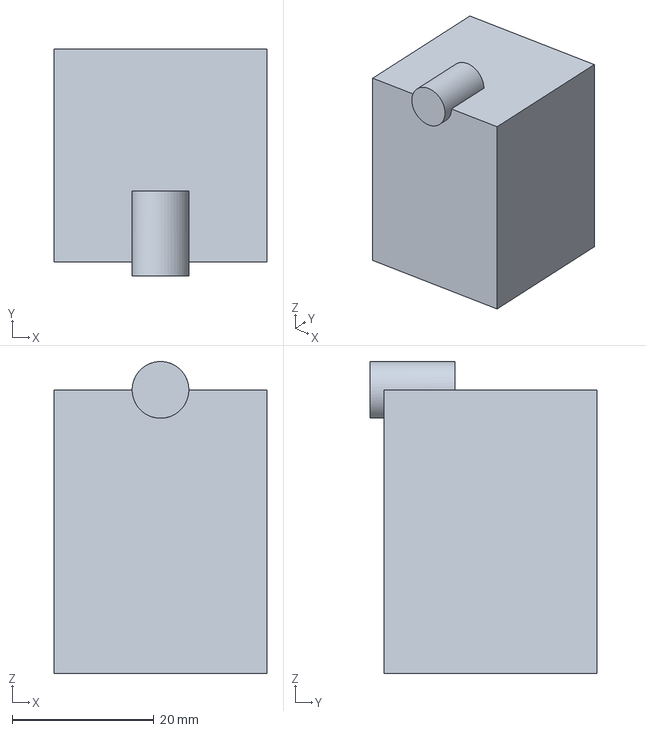
[picture p69: CAD file, 2026-10-09]
design/v3/parts/pitch_actuator_envelope.step
30.0 x 32.0 x 44.0 mm
