trawngson/aware/design/ab/b_frame/parts/hinge_post_1.step

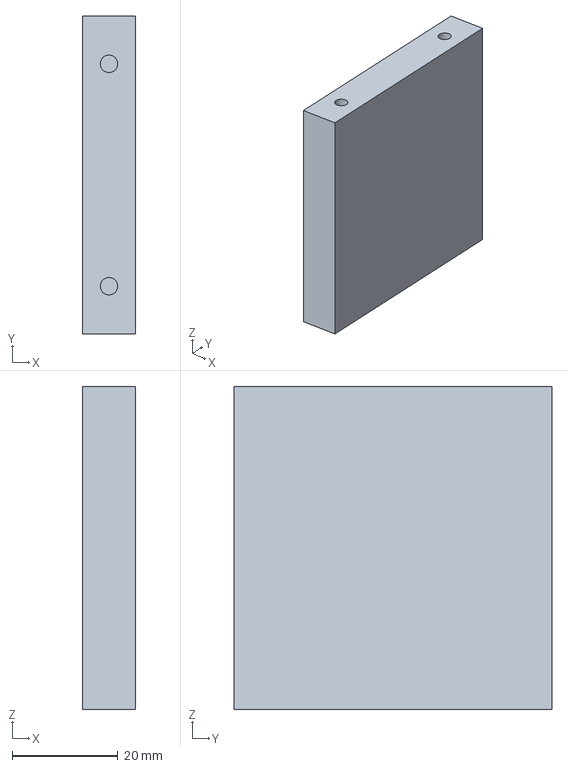
[picture p70: CAD file, 2026-11-06]
design/ab/b_frame/parts/hinge_post_1.step
10.0 x 60.0 x 61.0 mm
