trawngson/aware/design/ab/b_frame/parts/beam_splice_plate.step

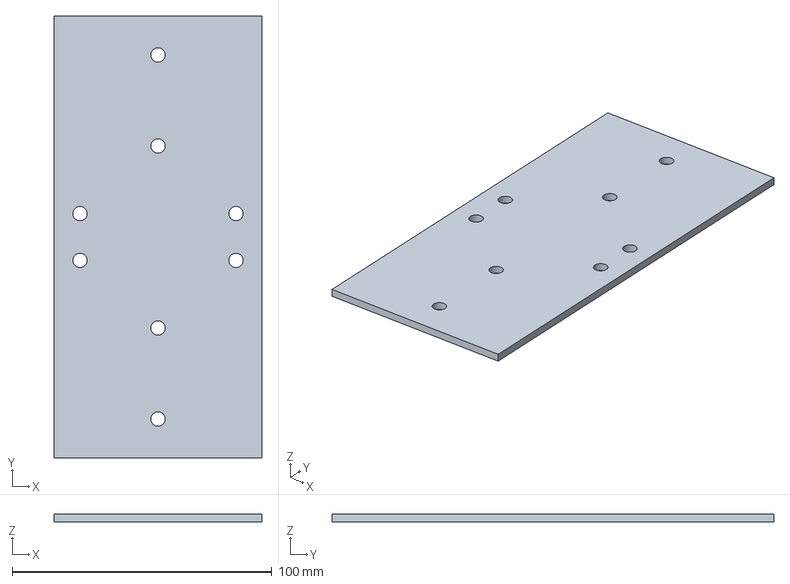
[picture p71: CAD file, 2026-11-06]
design/ab/b_frame/parts/beam_splice_plate.step
80.0 x 170.0 x 3.00 mm
