trawngson/aware/design/ab/b_frame/parts/fill_sensor_arm_3.stl

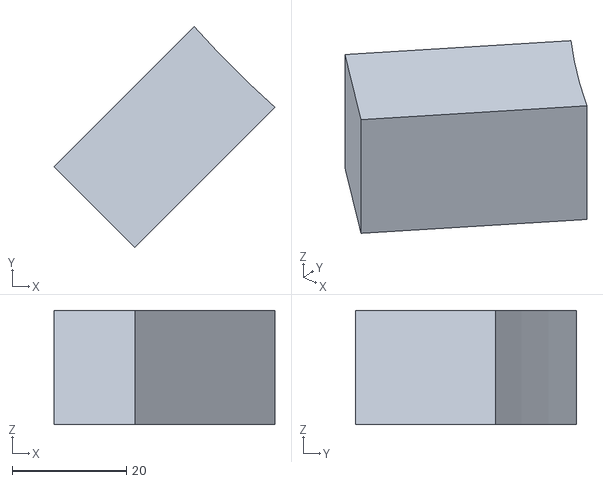
[picture p72: CAD file, 2026-11-06]
design/ab/b_frame/parts/fill_sensor_arm_3.stl
38.7 x 38.7 x 20.0
