trawngson/aware/design/v3/parts/intake_funnel.step

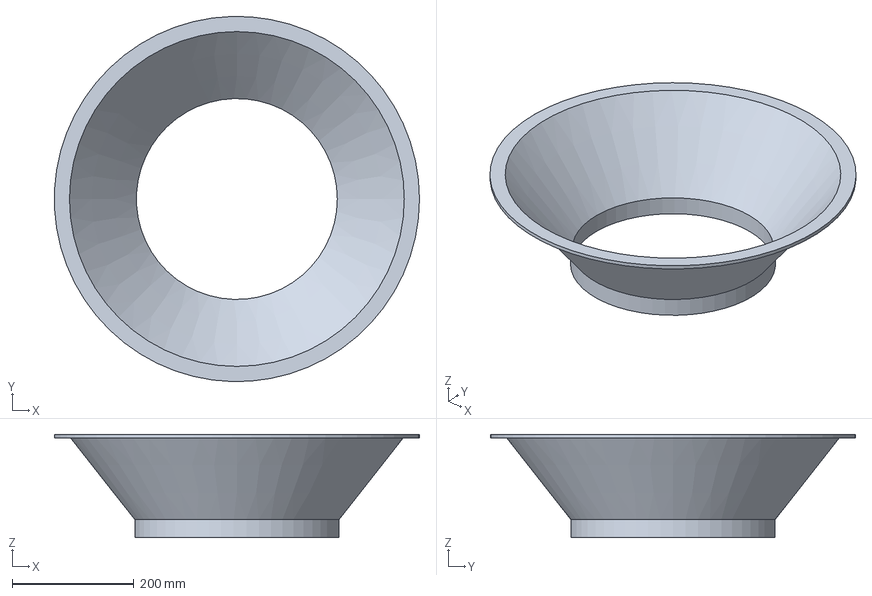
[picture p73: CAD file, 2026-10-09]
design/v3/parts/intake_funnel.step
599.6 x 599.8 x 170.0 mm
