trawngson/aware/design/ab/b_frame/parts/drawer_front_left.step

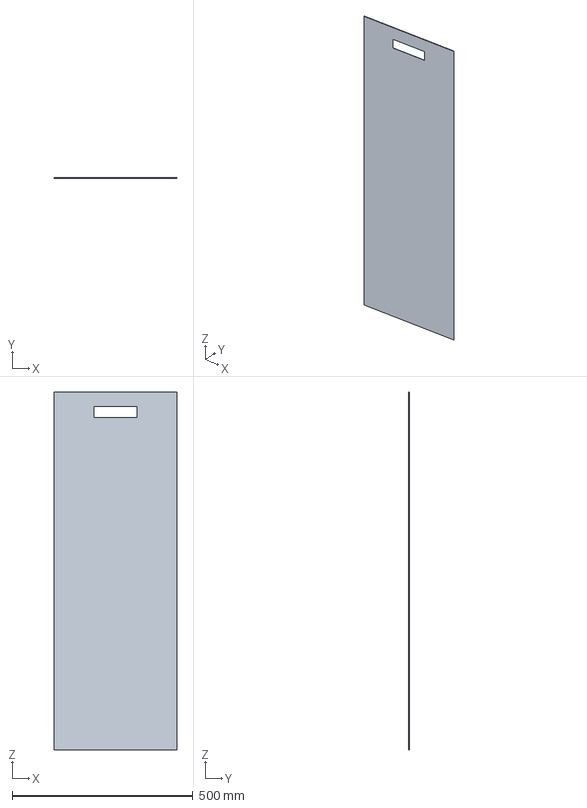
[picture p74: CAD file, 2026-11-06]
design/ab/b_frame/parts/drawer_front_left.step
339.0 x 2.00 x 990.0 mm
