trawngson/aware/design/v3/parts/plate_support_spider.step

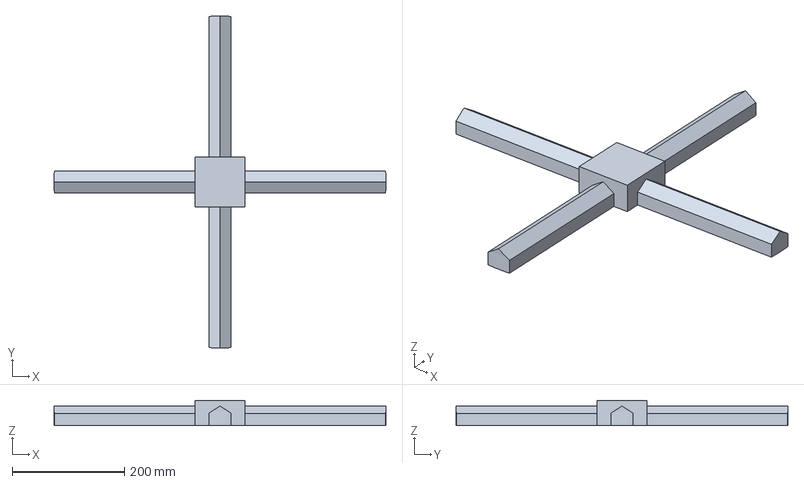
[picture p75: CAD file, 2026-10-09]
design/v3/parts/plate_support_spider.step
592.0 x 592.0 x 45.0 mm
