trawngson/aware/design/v3/parts/moving_plate_yoke.step

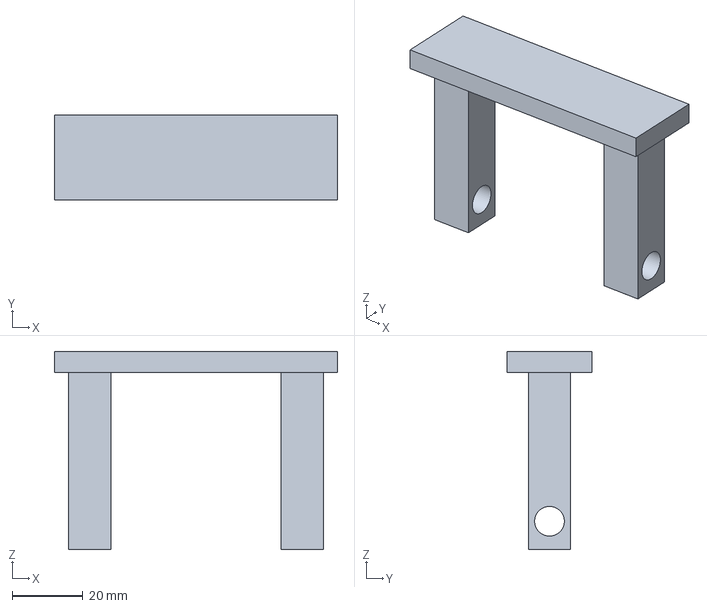
[picture p76: CAD file, 2026-10-09]
design/v3/parts/moving_plate_yoke.step
80.0 x 24.0 x 56.0 mm
