trawngson/aware/design/ab/b_frame/parts/head_panel_front.stl

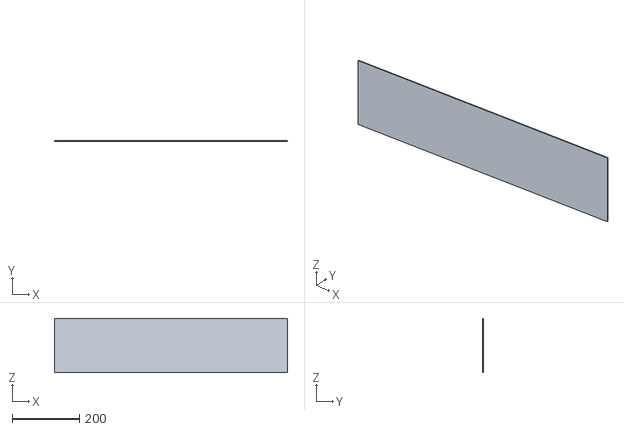
[picture p77: CAD file, 2026-11-06]
design/ab/b_frame/parts/head_panel_front.stl
692.0 x 2.00 x 161.0
