trawngson/aware/design/v3/parts/display_camera_console.step

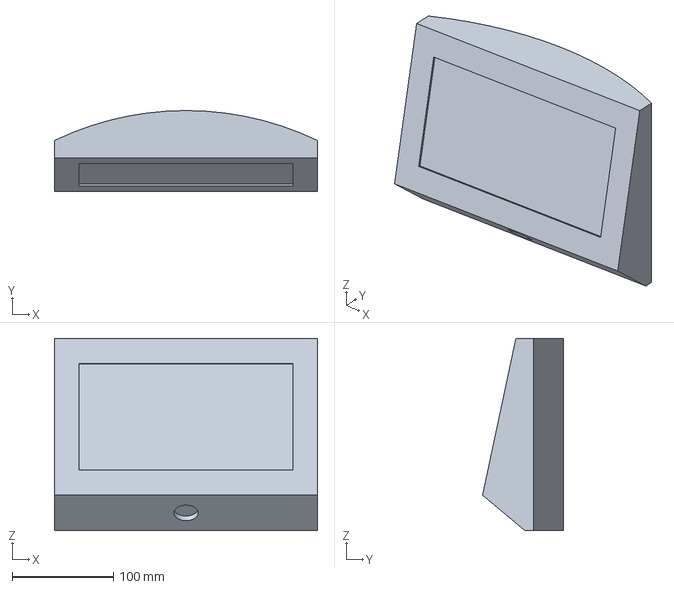
[picture p78: CAD file, 2026-10-09]
design/v3/parts/display_camera_console.step
260.0 x 80.0 x 190.0 mm
