trawngson/aware/design/ab/b_frame/parts/tray_corner_right_1.step

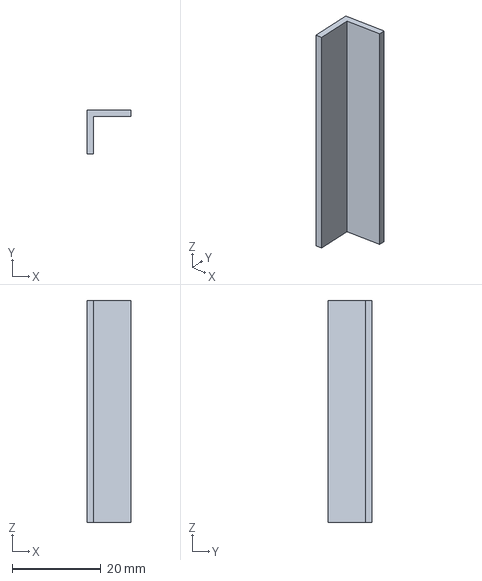
[picture p79: CAD file, 2026-11-06]
design/ab/b_frame/parts/tray_corner_right_1.step
10.0 x 10.0 x 50.0 mm
