trawngson/aware/design/v3/parts/head_shell.step

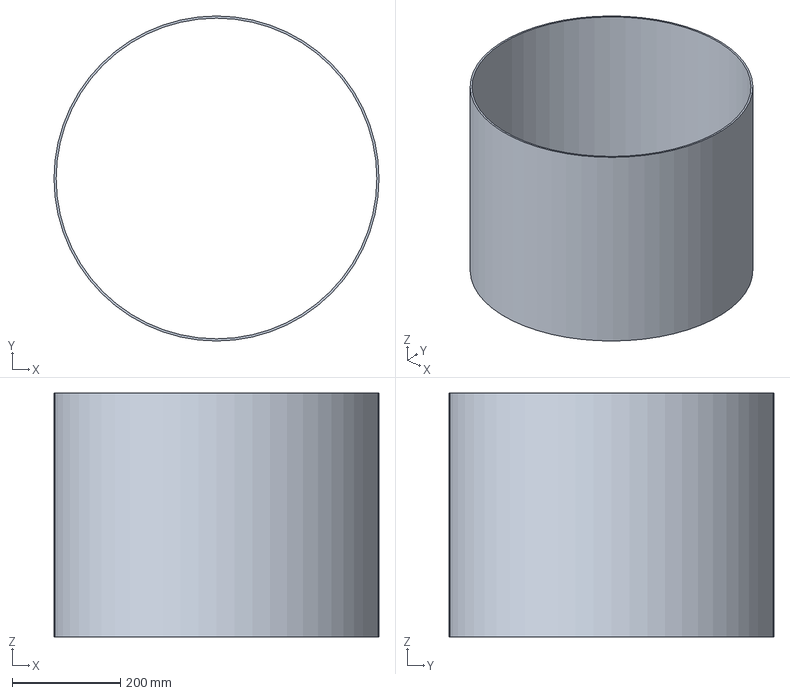
[picture p80: CAD file, 2026-10-09]
design/v3/parts/head_shell.step
600.0 x 600.0 x 450.0 mm
