trawngson/aware/design/v3/parts/blank_display_face.step

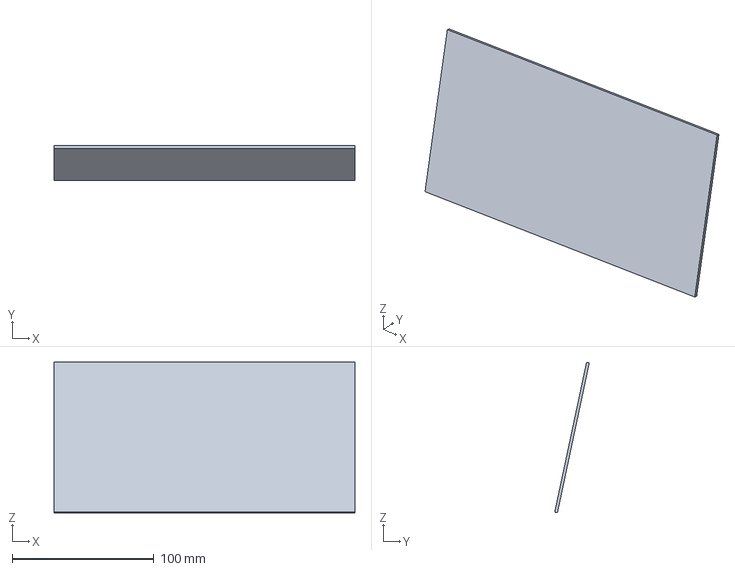
[picture p81: CAD file, 2026-10-09]
design/v3/parts/blank_display_face.step
212.0 x 24.4 x 106.1 mm
