trawngson/aware/design/ab/b_frame/parts/center_wall_clip_1.step

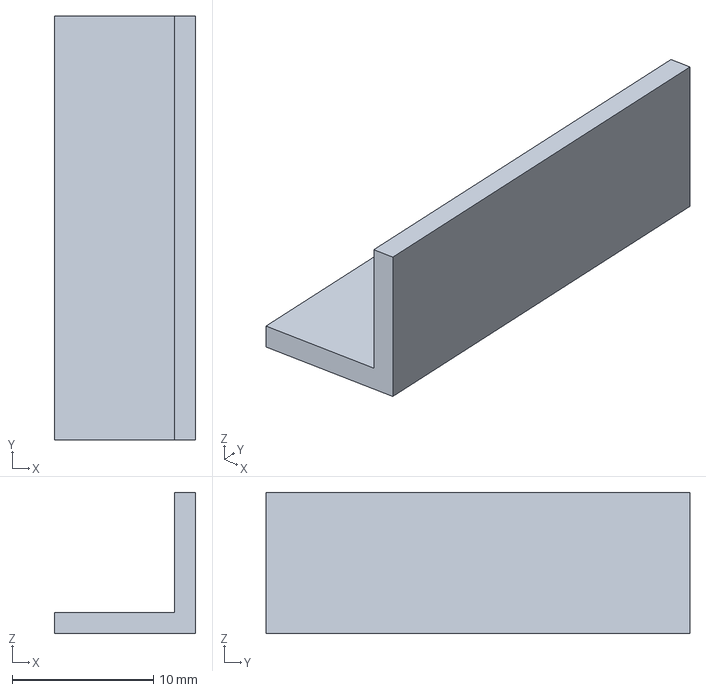
[picture p82: CAD file, 2026-11-06]
design/ab/b_frame/parts/center_wall_clip_1.step
10.0 x 30.0 x 10.0 mm
