trawngson/aware/design/v3/parts/foot_3.step

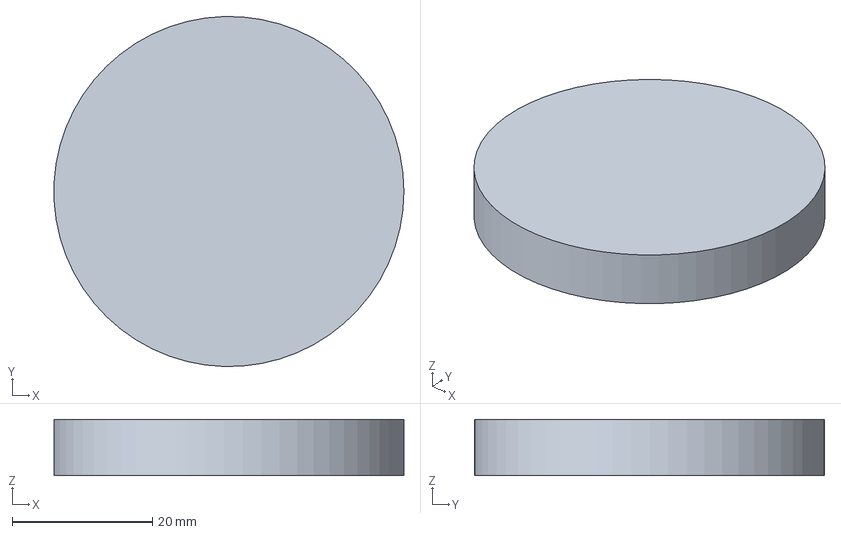
[picture p83: CAD file, 2026-10-09]
design/v3/parts/foot_3.step
50.0 x 50.0 x 8.00 mm
