trawngson/aware/design/ab/b_frame/parts/camera_window.step

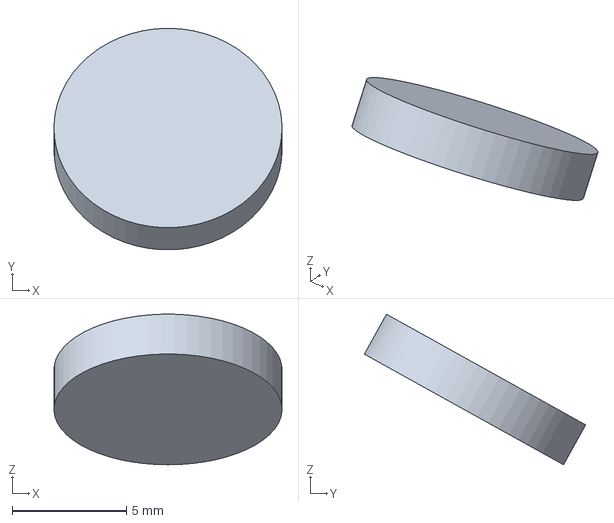
[picture p84: CAD file, 2026-11-06]
design/ab/b_frame/parts/camera_window.step
10.00 x 9.71 x 6.60 mm
