trawngson/aware/design/ab/b_frame/parts/slide_mount_right.step

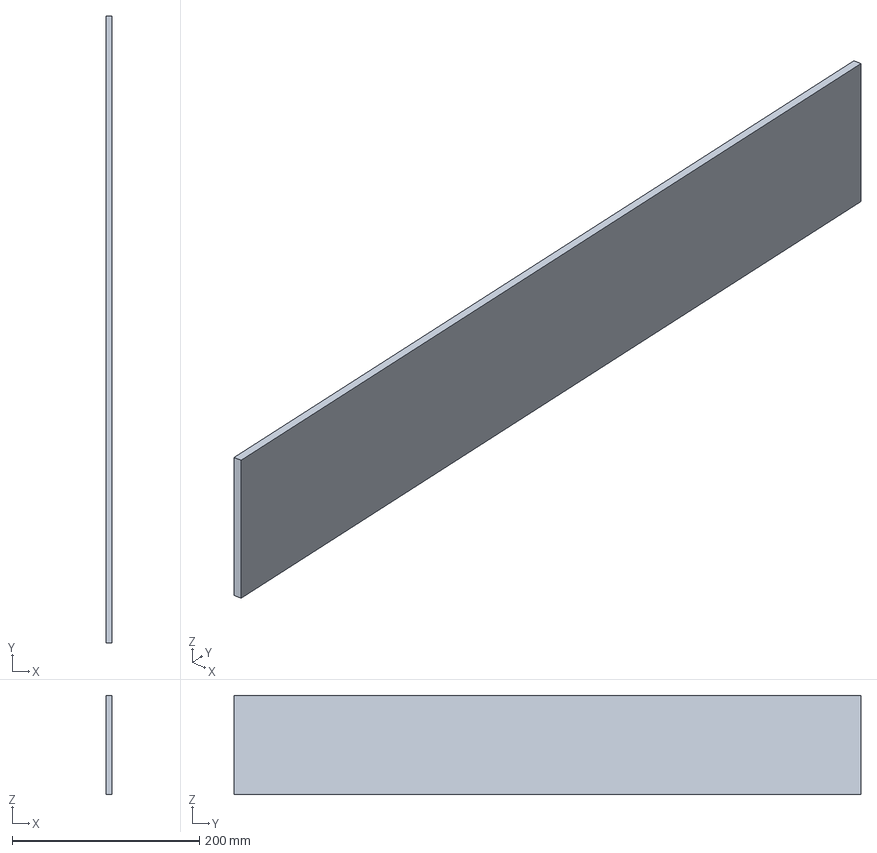
[picture p85: CAD file, 2026-11-06]
design/ab/b_frame/parts/slide_mount_right.step
6.00 x 670.0 x 106.0 mm
