trawngson/aware/design/ab/b_frame/parts/yaw_bracket.stl

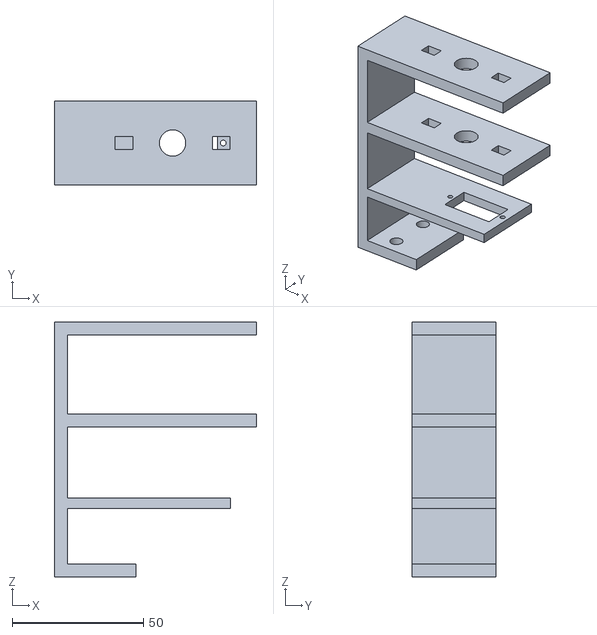
[picture p86: CAD file, 2026-11-06]
design/ab/b_frame/parts/yaw_bracket.stl
77.0 x 32.0 x 97.0
