trawngson/aware/design/ab/b_frame/parts/locating_ring_clip_3.step

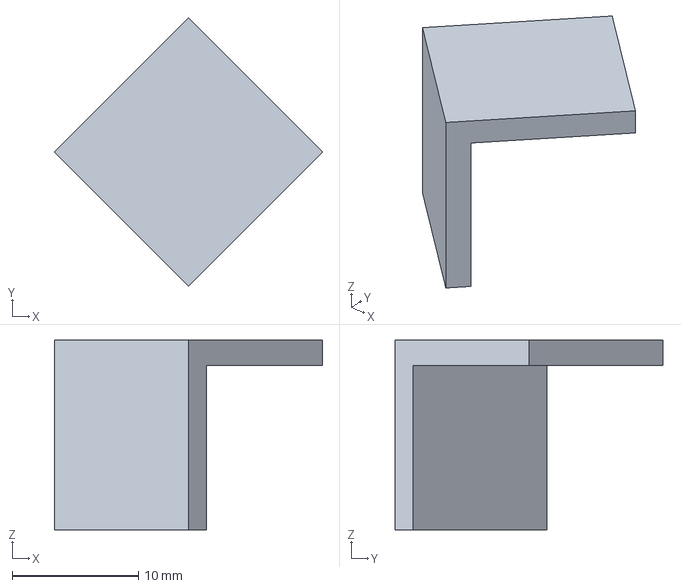
[picture p87: CAD file, 2026-11-06]
design/ab/b_frame/parts/locating_ring_clip_3.step
21.2 x 21.2 x 15.0 mm
