trawngson/aware/design/v3/parts/fixed_tilt_yoke.step

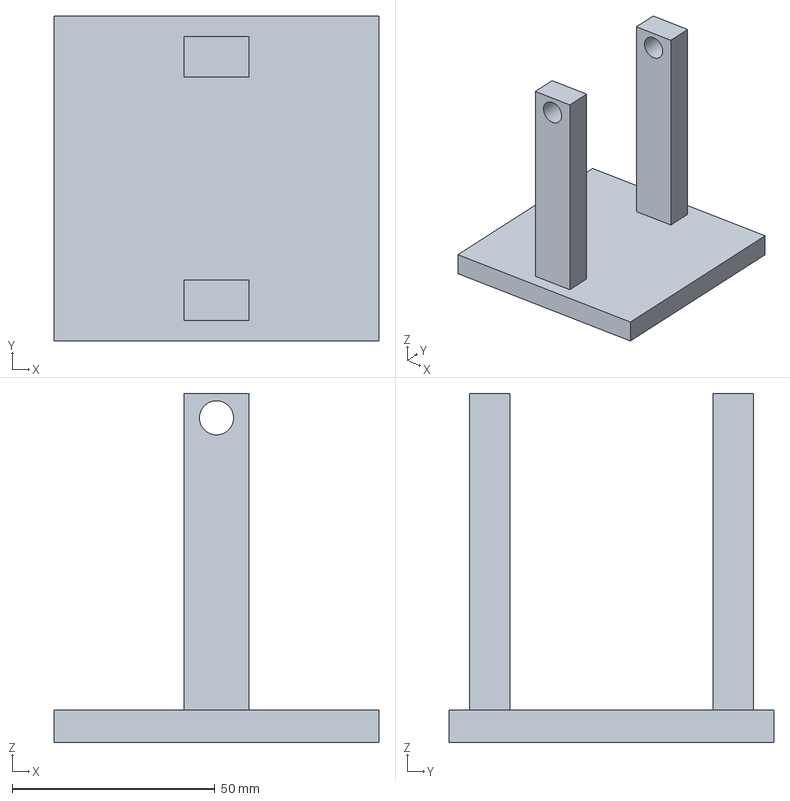
[picture p88: CAD file, 2026-10-09]
design/v3/parts/fixed_tilt_yoke.step
80.0 x 80.0 x 86.0 mm
