trawngson/aware/design/ab/b_frame/parts/tipping_plate.stl

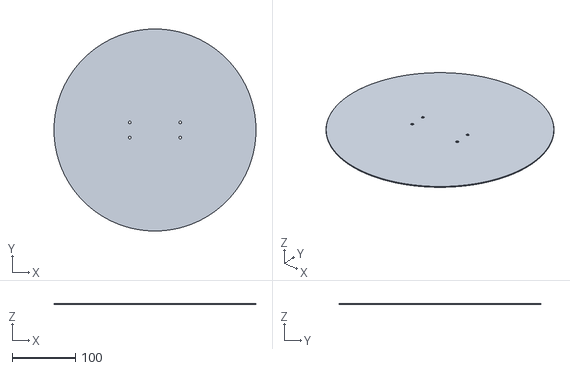
[picture p89: CAD file, 2026-11-06]
design/ab/b_frame/parts/tipping_plate.stl
320.0 x 319.9 x 1.50
