trawngson/aware/design/ab/b_frame/parts/bin_bag_band_4.stl

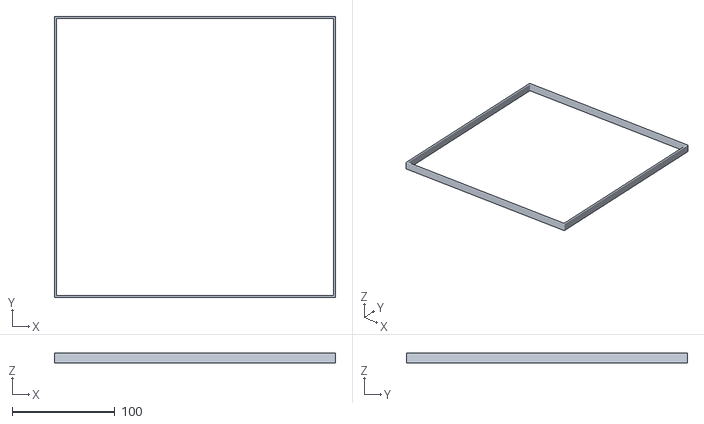
[picture p90: CAD file, 2026-11-06]
design/ab/b_frame/parts/bin_bag_band_4.stl
274.0 x 274.0 x 10.0
