trawngson/aware/design/ab/b_frame/parts/plate_lug_2.step

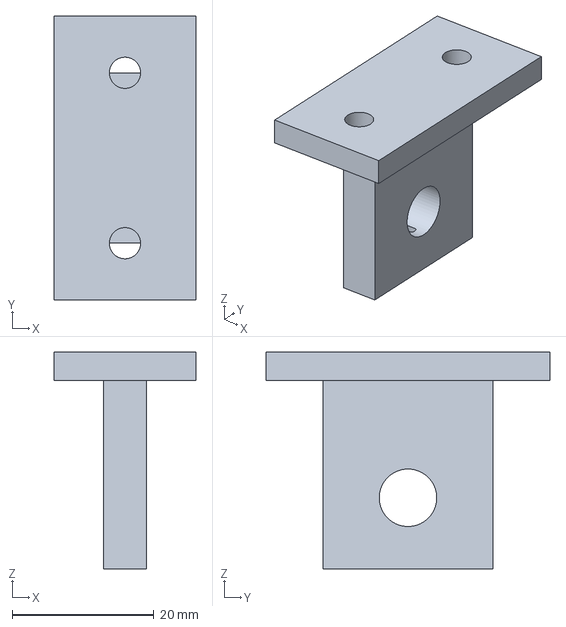
[picture p91: CAD file, 2026-11-06]
design/ab/b_frame/parts/plate_lug_2.step
20.0 x 40.0 x 30.5 mm
