trawngson/aware/design/ab/b_frame/parts/tft_screen.step

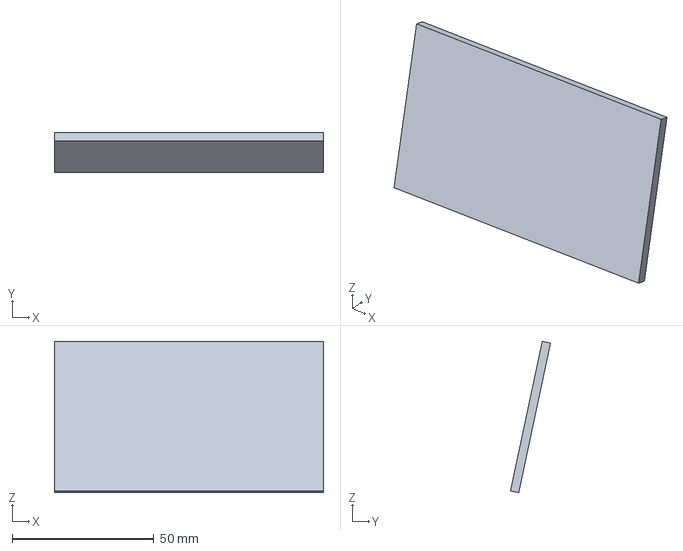
[picture p92: CAD file, 2026-11-06]
design/ab/b_frame/parts/tft_screen.step
95.0 x 14.2 x 53.4 mm
