trawngson/aware/design/ab/b_frame/parts/hanger_2.step

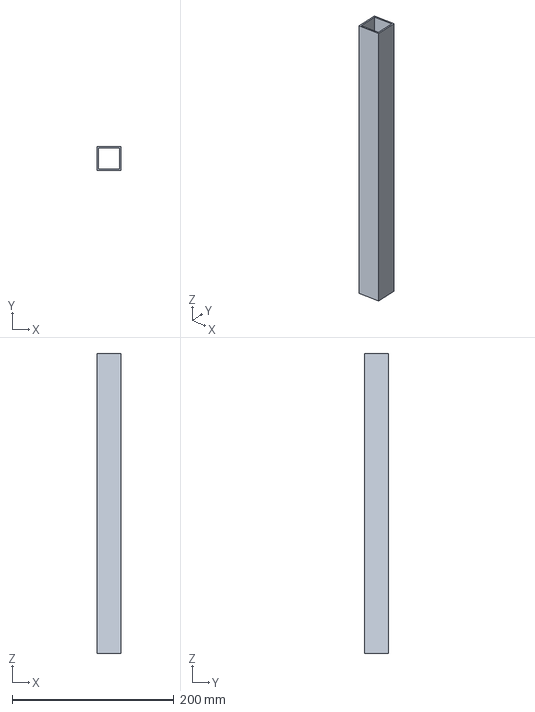
[picture p93: CAD file, 2026-11-06]
design/ab/b_frame/parts/hanger_2.step
30.0 x 30.0 x 371.0 mm
