trawngson/aware/design/ab/b_frame/parts/joint_beam.step

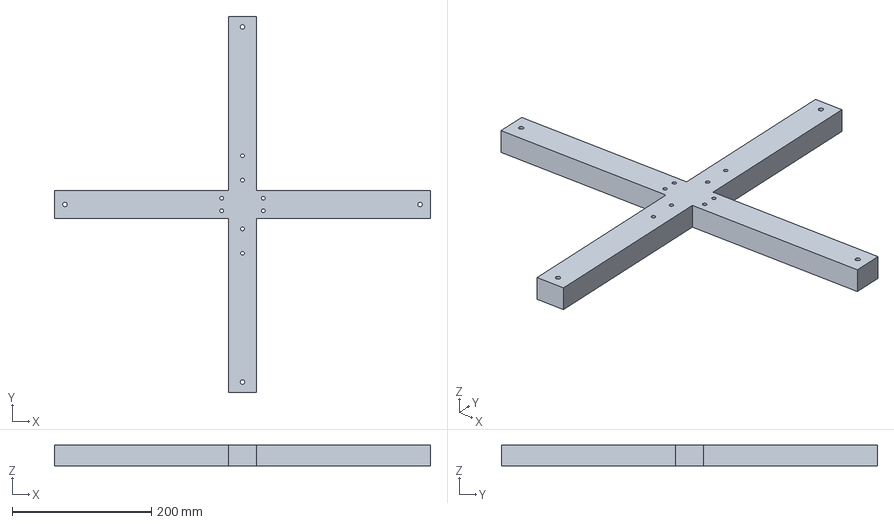
[picture p94: CAD file, 2026-11-06]
design/ab/b_frame/parts/joint_beam.step
540.0 x 540.0 x 30.0 mm
