trawngson/aware/design/ab/b_frame/parts/tilt_servo.step

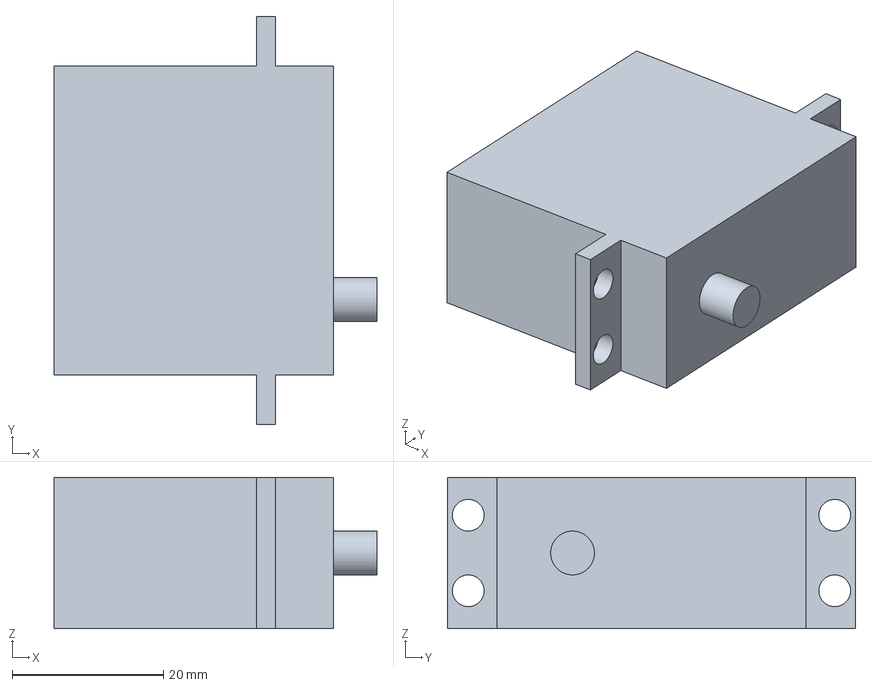
[picture p95: CAD file, 2026-11-06]
design/ab/b_frame/parts/tilt_servo.step
42.7 x 54.0 x 20.0 mm
