trawngson/aware/design/ab/b_frame/parts/foot_plate_2.step

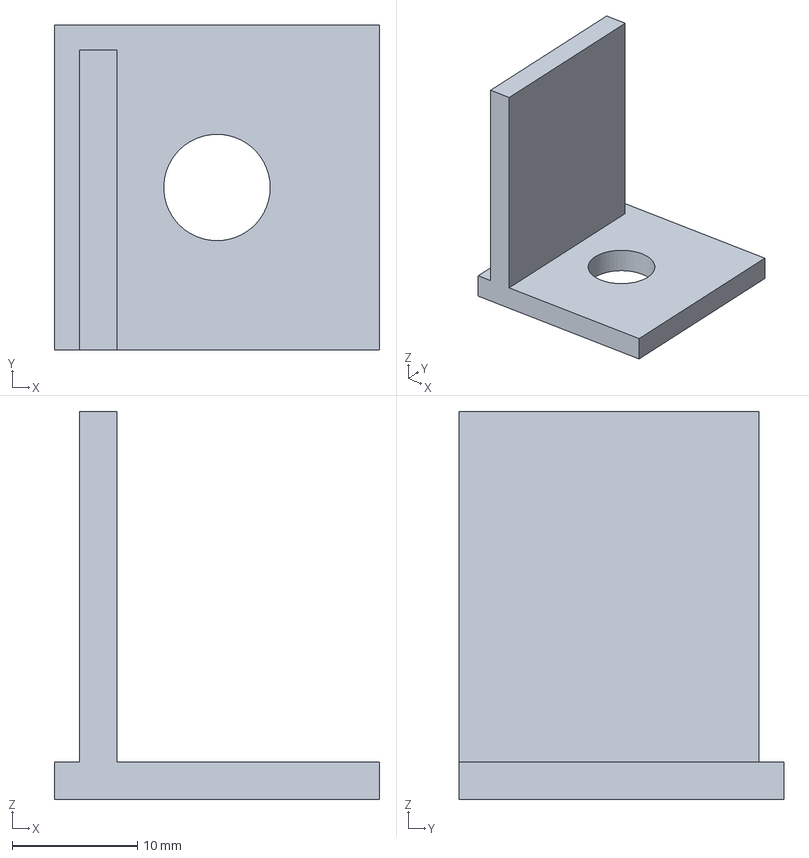
[picture p96: CAD file, 2026-11-06]
design/ab/b_frame/parts/foot_plate_2.step
26.0 x 26.0 x 31.0 mm
