trawngson/aware/design/ab/b_frame/parts/drawer_switch_right.step

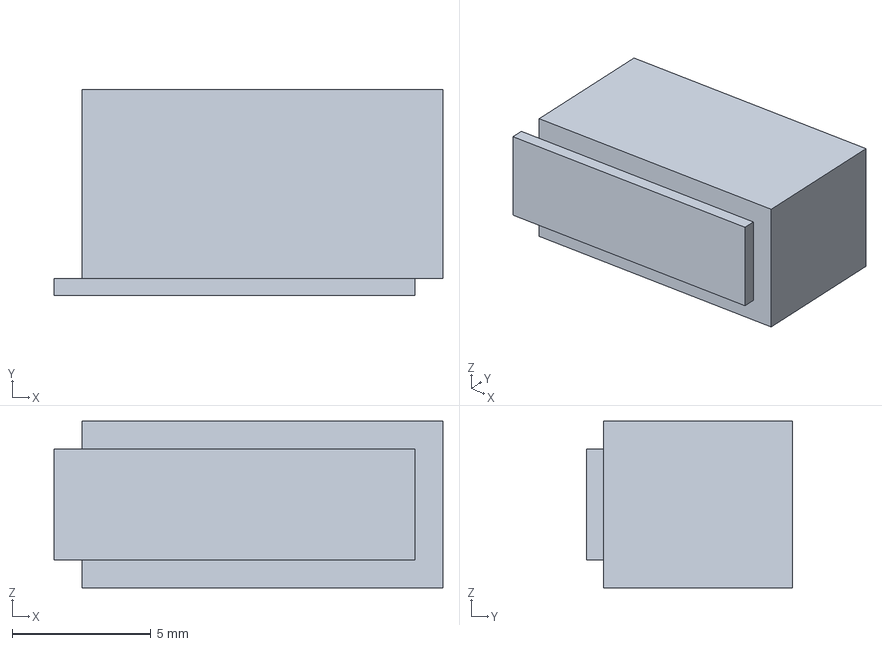
[picture p97: CAD file, 2026-11-06]
design/ab/b_frame/parts/drawer_switch_right.step
14.0 x 7.40 x 6.00 mm
