trawngson/aware/design/ab/b_frame/parts/tilt_servo_horn.step

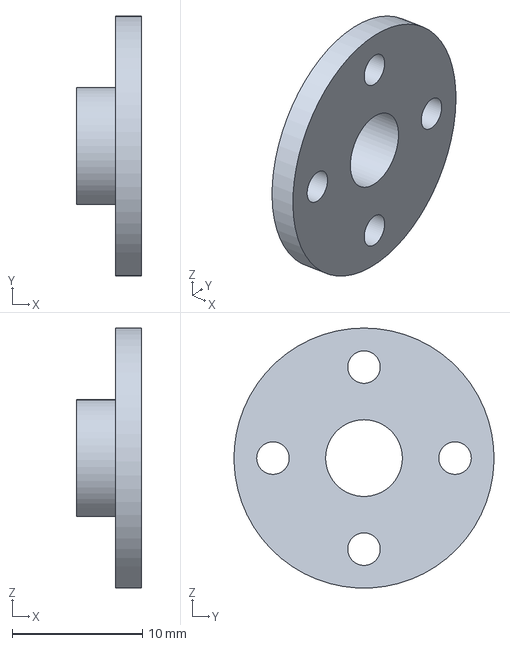
[picture p98: CAD file, 2026-11-06]
design/ab/b_frame/parts/tilt_servo_horn.step
5.00 x 20.0 x 20.0 mm
