trawngson/aware/design/ab/b_frame/parts/yaw_servo_horn.step

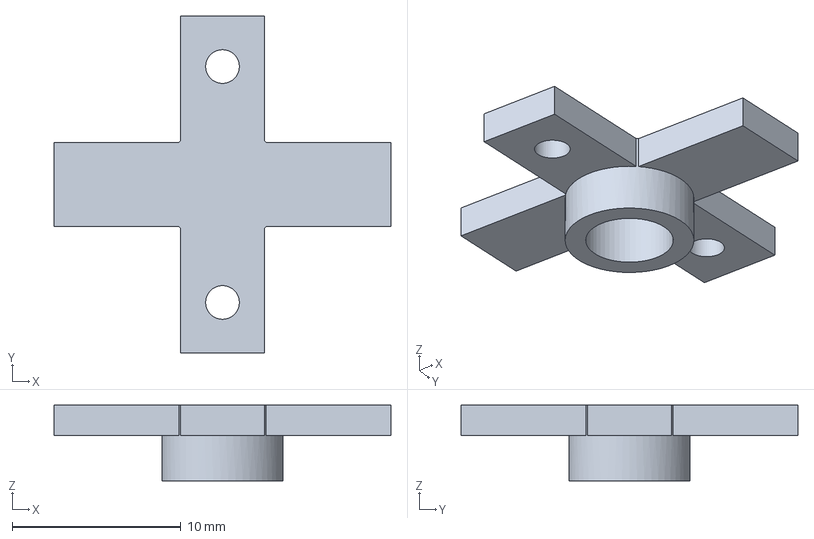
[picture p99: CAD file, 2026-11-06]
design/ab/b_frame/parts/yaw_servo_horn.step
20.0 x 20.0 x 4.50 mm
