trawngson/aware/design/ab/b_frame/parts/display_console.stl

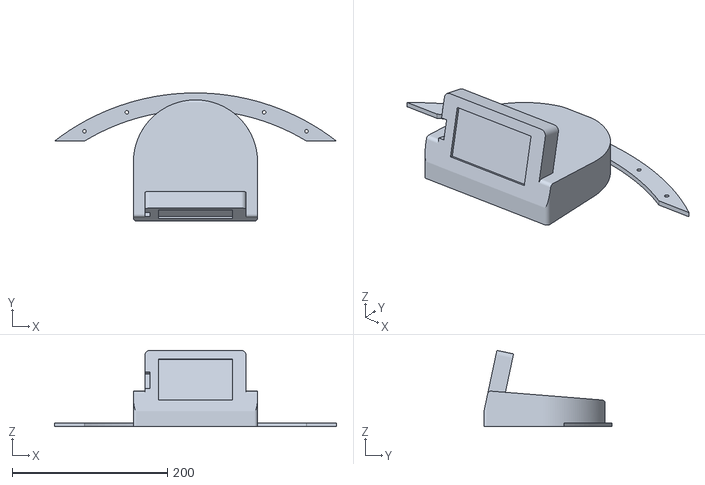
[picture p100: CAD file, 2026-11-06]
design/ab/b_frame/parts/display_console.stl
363.2 x 164.9 x 98.3
