trawngson/aware/design/ab/b_frame/parts/bin_2.step

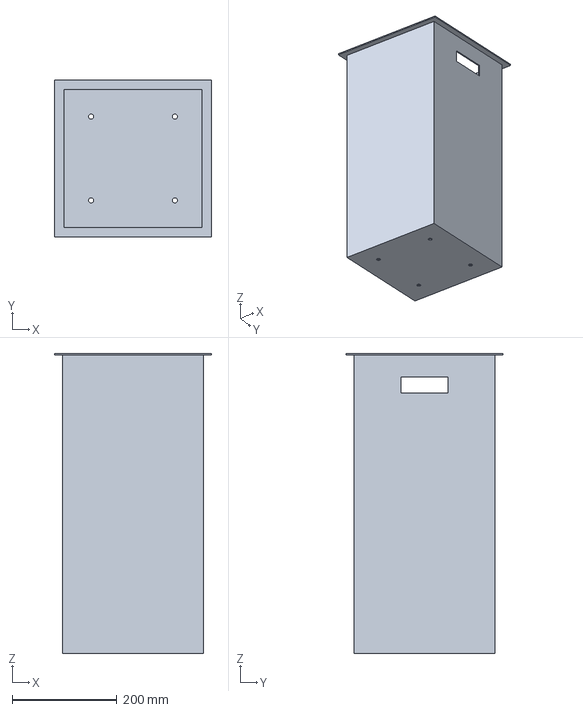
[picture p101: CAD file, 2026-11-06]
design/ab/b_frame/parts/bin_2.step
300.0 x 300.0 x 573.0 mm
