trawngson/aware/design/ab/b_frame/parts/yaw_cable_drum.step

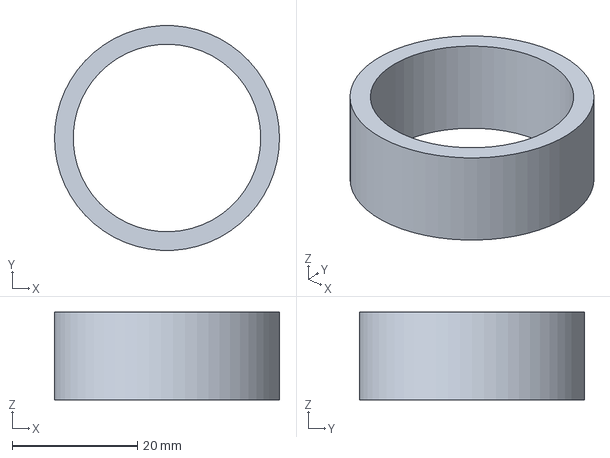
[picture p102: CAD file, 2026-11-06]
design/ab/b_frame/parts/yaw_cable_drum.step
36.0 x 35.9 x 14.0 mm
