trawngson/aware/design/ab/b_frame/parts/yaw_shaft.step

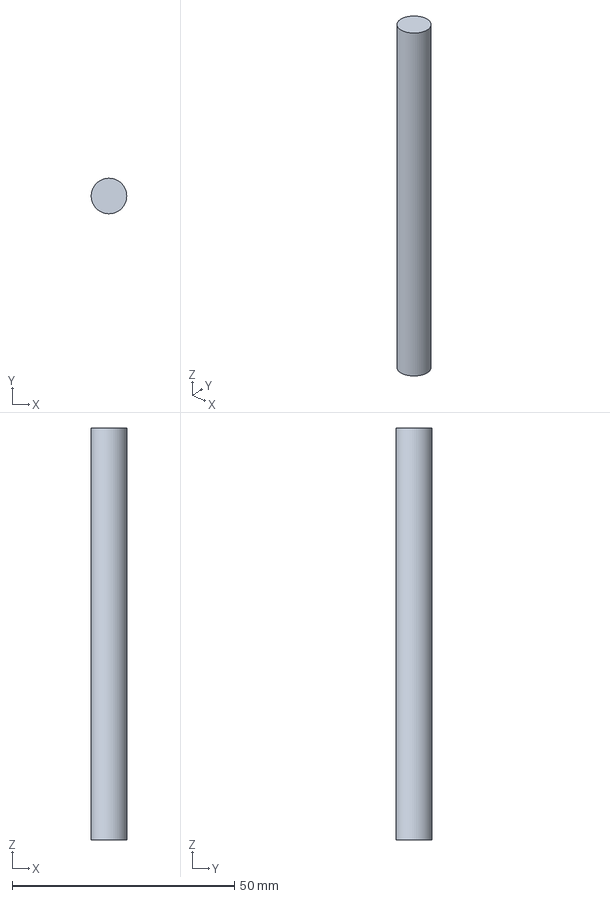
[picture p103: CAD file, 2026-11-06]
design/ab/b_frame/parts/yaw_shaft.step
7.99 x 8.00 x 92.6 mm
