trawngson/aware/design/ab/b_frame/parts/drawer_switch_bracket_left.step

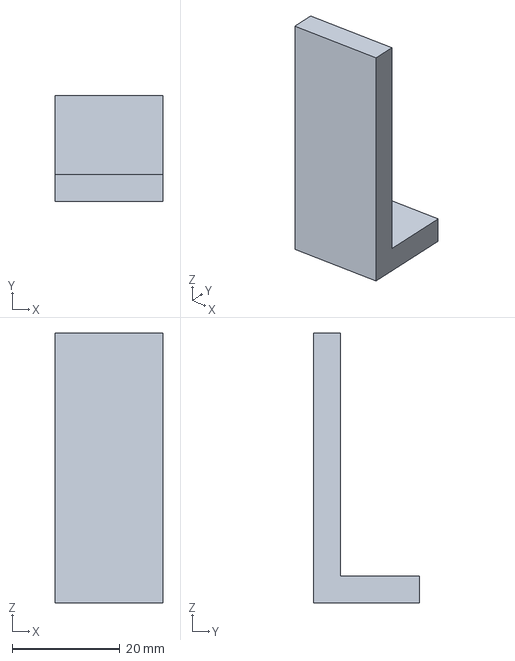
[picture p104: CAD file, 2026-11-06]
design/ab/b_frame/parts/drawer_switch_bracket_left.step
20.0 x 19.6 x 50.0 mm
