trawngson/aware/design/ab/b_frame/parts/yaw_stop_pin.step

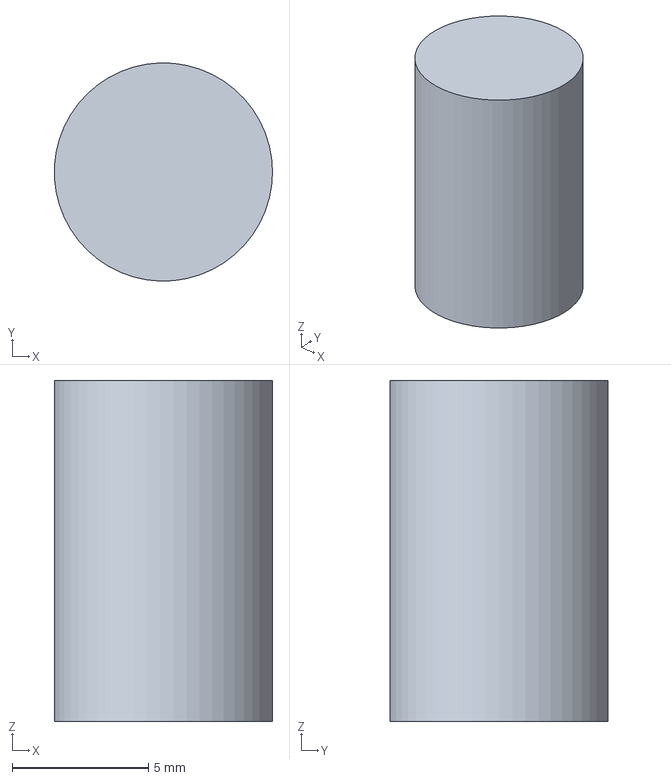
[picture p105: CAD file, 2026-11-06]
design/ab/b_frame/parts/yaw_stop_pin.step
7.99 x 8.00 x 12.5 mm
