trawngson/aware/design/ab/b_frame/parts/yaw_ribbon_loop.step

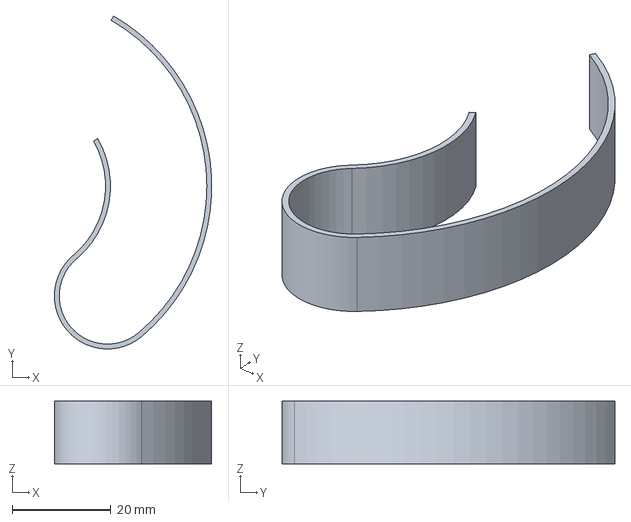
[picture p106: CAD file, 2026-11-06]
design/ab/b_frame/parts/yaw_ribbon_loop.step
31.8 x 67.4 x 12.7 mm
