trawngson/aware/design/ab/b_frame/parts/yaw_flange.stl

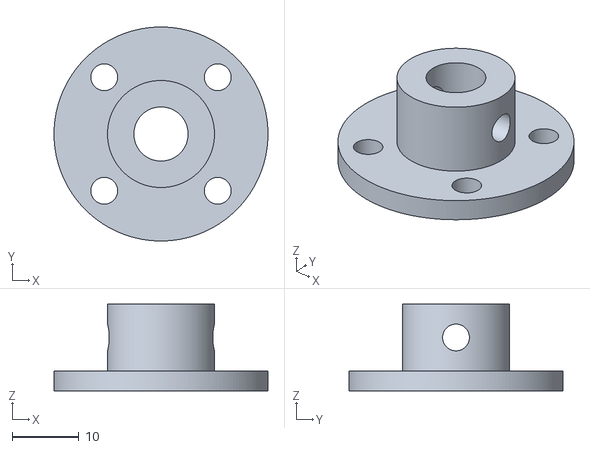
[picture p107: CAD file, 2026-11-06]
design/ab/b_frame/parts/yaw_flange.stl
32.0 x 32.0 x 13.0
