trawngson/aware/design/ab/b_frame/parts/rail_bottom_yp.stl

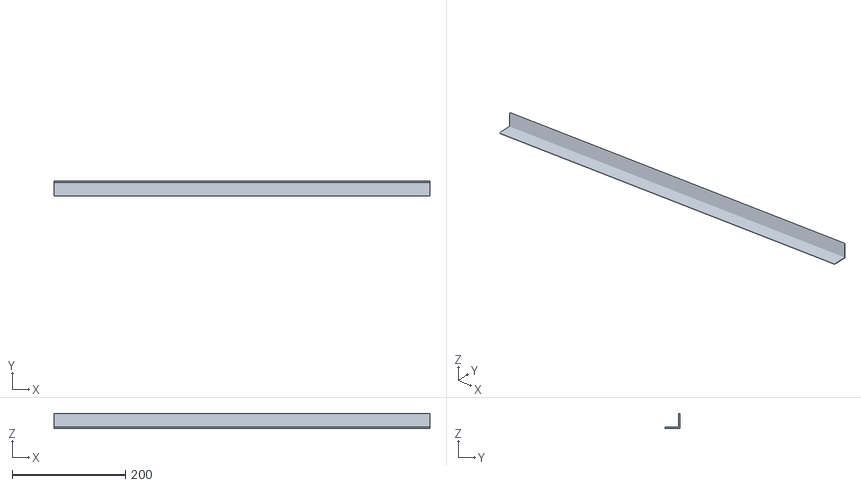
[picture p108: CAD file, 2026-11-06]
design/ab/b_frame/parts/rail_bottom_yp.stl
665.0 x 26.0 x 26.0
