trawngson/aware/(list of files, cad)

Other CAD files:
design/v3/tilt_to_sub_bin_4.step
design/v3/tilt_to_sub_bin_3.step
design/v3/tilt_to_sub_bin_1.step
design/v3/tilt_to_sub_bin_2.step
design/v3/parts/fill_sensor_window_3.step
design/v3/parts/fill_sensor_housing_2.step
design/v3/parts/fill_sensor_window_4.step
design/v3/parts/blank_label_3.step
design/v3/parts/fill_sensor_housing_3.step
design/v3/parts/blank_label_4.step
design/ab/b_frame/parts/foot_3.step
design/v3/parts/sub_bin_3.step
design/ab/b_frame/parts/shell_ring_clip_high_2.stl
design/v3/parts/blank_label_2.step
design/v3/parts/fill_sensor_housing_4.step
design/ab/b_frame/parts/slide_right_outer.step
design/v3/parts/fill_sensor_bracket_3.step
design/v3/parts/sub_bin_4.step
design/ab/b_frame/parts/shell_ring_clip_high_3.step
design/v3/parts/fill_sensor_window_1.step
design/ab/b_frame/parts/post_1.step
design/ab/b_frame/parts/rail_seat_yp.stl
design/v3/parts/fill_sensor_bracket_2.step
design/ab/b_frame/parts/spider_foot_1.step
design/v3/parts/fill_sensor_bracket_1.step
design/v3/parts/foot_1.step
design/v3/parts/foot_2.step
design/ab/b_frame/parts/tray_corner_left_1.step
design/v3/parts/sub_bin_2.step
design/v3/parts/foot_4.step
design/ab/b_frame/parts/fill_sensor_pod_4.step
design/ab/b_frame/parts/center_wall_clip_3.step
design/ab/b_frame/parts/rail_mid_xp.step
design/ab/b_frame/parts/bin_bag_band_1.stl
design/ab/b_frame/parts/hinge_collar_2.step
design/ab/b_frame/parts/fill_sensor_pod_1.step
design/ab/b_frame/parts/drawer_stiffener_left_2.stl
design/ab/b_frame/parts/hanger_insert_top_3.stl
design/ab/b_frame/parts/post_4.step
design/ab/b_frame/parts/hanger_insert_top_4.stl
design/ab/b_frame/parts/hanger_1.step
design/ab/b_frame/parts/hinge_block_1.step
design/ab/b_frame/parts/rail_seat_xn.stl
design/ab/b_frame/parts/drawer_stiffener_right_1.step
design/ab/b_frame/parts/rail_bottom_xn.stl
design/ab/b_frame/parts/foot_4.stl
design/ab/b_frame/parts/locating_ring_clip_1.step
design/ab/b_frame/parts/yaw_collar.step
design/ab/b_frame/parts/flexible_throat_skirt.step
design/ab/b_frame/parts/slide_left_inner.step
design/ab/b_frame/parts/drawer_front_right.step
design/ab/b_frame/parts/shell_ring_clip_low_2.stl
design/ab/b_frame/parts/shell_ring_clip_high_1.step
design/ab/b_frame/parts/hanger_insert_top_2.step
design/ab/b_frame/parts/fill_sensor_arm_1.stl
design/ab/b_frame/parts/foot_plate_4.stl
design/ab/b_frame/parts/hinge_post_2.stl
design/ab/b_frame/parts/spider_foot_3.step
design/ab/b_frame/parts/slide_right_inner.step
design/ab/b_frame/parts/fill_sensor_pod_2.stl
design/ab/b_frame/parts/shell_ring_clip_low_3.stl
design/ab/b_frame/parts/spider_foot_2.step
design/ab/b_frame/parts/rail_mid_yp.stl
design/ab/b_frame/parts/bin_bag_band_3.step
design/ab/b_frame/parts/side_panel_right.step
design/ab/b_frame/parts/bin_4.step
design/ab/b_frame/parts/fill_sensor_arm_2.step
design/ab/b_frame/dxf/drawer_front_right.dxf
design/ab/b_frame/dxf/head_deck.dxf
design/ab/b_frame/dxf/side_panel_left.dxf
design/ab/b_frame/dxf/tipping_plate.dxf
design/ab/b_frame/dxf/top_cover.dxf
design/ab/b_frame/parts/bin_1.step
design/ab/b_frame/parts/bin_1.stl
design/ab/b_frame/parts/bin_2.stl
design/ab/b_frame/parts/bin_4.stl
design/ab/b_frame/parts/bin_bag_band_2.stl
design/ab/b_frame/parts/bin_bag_band_3.stl
design/ab/b_frame/parts/camera_window.stl
design/ab/b_frame/parts/center_wall_clip_1.stl
design/ab/b_frame/parts/center_wall_clip_2.step
design/ab/b_frame/parts/center_wall_clip_2.stl
design/ab/b_frame/parts/center_wall_clip_3.stl
design/ab/b_frame/parts/center_wall_clip_4.step
design/ab/b_frame/parts/center_wall_clip_4.stl
design/ab/b_frame/parts/drawer_front_left.stl
design/ab/b_frame/parts/drawer_right.step
design/ab/b_frame/parts/drawer_stiffener_right_1.stl
design/ab/b_frame/parts/drawer_switch_bracket_left.stl
design/ab/b_frame/parts/drawer_switch_left.stl
design/ab/b_frame/parts/drawer_switch_right.stl
design/ab/b_frame/parts/fill_sensor_pod_1.stl
design/ab/b_frame/parts/floor_plate.stl
design/ab/b_frame/parts/foot_1.stl
design/ab/b_frame/parts/foot_3.stl
design/ab/b_frame/parts/foot_plate_2.stl
design/ab/b_frame/parts/hanger_1.stl
design/ab/b_frame/parts/hanger_2.stl
design/ab/b_frame/parts/hanger_insert_bottom_3.step
design/ab/b_frame/parts/head_deck.stl
design/ab/b_frame/parts/head_locating_ring.stl
design/ab/b_frame/parts/hinge_block_2.stl
design/ab/b_frame/parts/hinge_collar_2.stl
design/ab/b_frame/parts/locating_ring_clip_3.stl
design/ab/b_frame/parts/post_1.stl
design/ab/b_frame/parts/rail_bottom_xp.step
design/ab/b_frame/parts/shell_ring_clip_high_3.stl
design/ab/b_frame/parts/side_panel_left.stl
design/ab/b_frame/parts/side_panel_right.stl
design/ab/b_frame/parts/slide_left_inner.stl
design/ab/b_frame/parts/slide_mount_left.stl
design/ab/b_frame/parts/slide_mount_right.stl
design/ab/b_frame/parts/slide_right_inner.stl
design/ab/b_frame/parts/tilt_belt.step
design/ab/b_frame/parts/tilt_belt.stl
design/ab/b_frame/parts/tilt_pulley_large.stl
design/ab/b_frame/parts/tilt_servo.stl
design/ab/b_frame/parts/tilt_servo_horn.stl
design/ab/b_frame/parts/tilt_stop_pad_2.stl
design/ab/b_frame/parts/top_cover.stl
design/ab/b_frame/parts/tray_corner_left_1.stl
design/ab/b_frame/parts/tray_corner_left_2.stl
design/ab/b_frame/parts/tray_corner_right_1.stl
design/ab/b_frame/parts/yaw_cable_channel.step
design/ab/b_frame/parts/yaw_cable_channel.stl
design/ab/b_frame/parts/yaw_hub.stl
design/ab/b_frame/parts/yaw_platform.stl
design/ab/b_frame/parts/yaw_ribbon_loop.stl
design/ab/b_frame/parts/yaw_servo.step
design/v2/parts/blank_display_face.step
design/v2/parts/blank_display_face.stl
design/v2/parts/blank_label_1.step
design/v2/parts/blank_label_1.stl
design/v2/parts/blank_label_2.step
design/v2/parts/blank_label_2.stl
design/v2/parts/blank_label_3.step
design/v2/parts/blank_label_3.stl
design/v2/parts/blank_label_4.step
design/v2/parts/blank_label_4.stl
design/v2/parts/camera_canopy_hanger.step
design/v2/parts/camera_canopy_hanger.stl
design/v2/parts/camera_lens_placeholder.step
design/v2/parts/camera_lens_placeholder.stl
design/v2/parts/canopy.step
design/v2/parts/canopy.stl
design/v2/parts/display_housing.step
design/v2/parts/display_housing.stl
design/v2/parts/fill_sensor_housing_1.step
design/v2/parts/fill_sensor_housing_1.stl
design/v2/parts/fill_sensor_housing_2.step
design/v2/parts/fill_sensor_housing_2.stl
design/v2/parts/fill_sensor_housing_3.step
design/v2/parts/fill_sensor_housing_3.stl
design/v2/parts/fill_sensor_housing_4.step
design/v2/parts/fill_sensor_housing_4.stl
design/v2/parts/fill_sensor_window_1.step
design/v2/parts/fill_sensor_window_1.stl
design/v2/parts/fill_sensor_window_2.step
design/v2/parts/fill_sensor_window_2.stl
design/v2/parts/fill_sensor_window_3.step
design/v2/parts/fill_sensor_window_3.stl
design/v2/parts/fill_sensor_window_4.step
design/v2/parts/fill_sensor_window_4.stl
design/v2/parts/fixed_tilt_yoke.step
design/v2/parts/fixed_tilt_yoke.stl
design/v2/parts/foot_1.step
design/v2/parts/foot_2.step
design/v2/parts/foot_3.step
design/v2/parts/foot_4.step
design/v2/parts/foot_5.step
design/v2/parts/foot_5.stl
design/v2/parts/identification_camera_housing.step
design/v2/parts/identification_camera_housing.stl
design/v2/parts/liner_support_deck.step
design/v2/parts/moving_plate_yoke.step
design/v2/parts/moving_plate_yoke.stl
design/v2/parts/outer_shell.step
design/v2/parts/outer_shell.stl
design/v2/parts/pitch_actuator_envelope.step
design/v2/parts/pitch_actuator_envelope.stl
design/v2/parts/plinth_with_rear_mast_base.step
design/v2/parts/plinth_with_rear_mast_base.stl
design/v2/parts/rear_canopy_cleat.step
design/v2/parts/rear_canopy_cleat.stl
design/v2/parts/rear_cantilever_plate_support.step
design/v2/parts/rear_cantilever_plate_support.stl
design/v2/parts/rear_display_standoff.step
design/v2/parts/rear_display_standoff.stl
design/v2/parts/rear_hollow_mast.step
design/v2/parts/rear_hollow_mast.stl
design/v2/parts/rear_mast_mount_flange.step
design/v2/parts/rear_mast_mount_flange.stl
design/v2/parts/roll_actuator_envelope.step
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
