trawngson/aware/design/v3/assembled.png

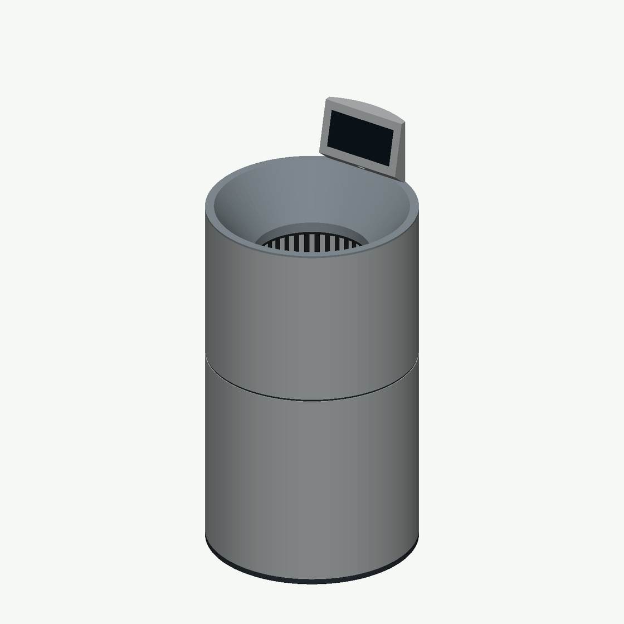
design/v3/assembled.png
