trawngson/aware/backend/tests/fixtures/open_images/boxes.csv

ImageID | LabelName | XMin | XMax | YMin | YMax | IsGroupOf | IsDepiction | IsInside
abc | /m/plastic_bag | 0.1 | 0.5 | 0.2 | 0.8 | 0 | 0 | 0
abc | /m/bottle | 0.55 | 0.9 | 0.1 | 0.95 | 0 | 0 | 0
abc | /m/plastic_bag | 0.2 | 0.4 | 0.2 | 0.4 | 0 | 1 | 0
