trawngson/aware/backend/tests/fixtures/open_images/classes.csv

/m/bottle | Bottle
/m/plastic_bag | Plastic bag
