trawngson/aware/.github/readme/screens/scan-results.png

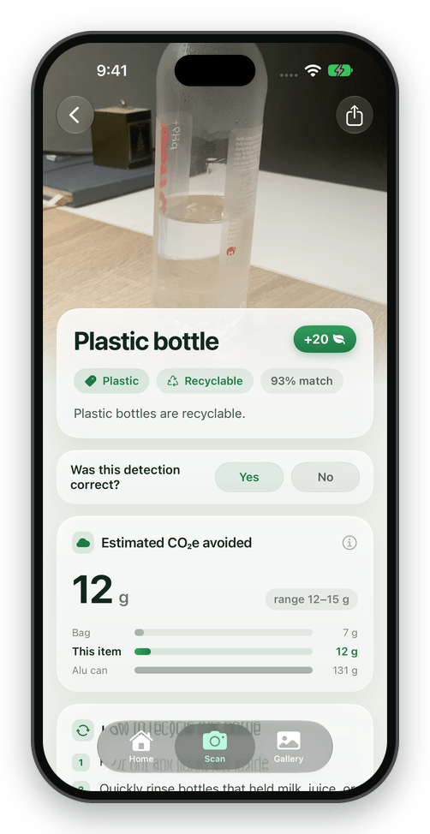
.github/readme/screens/scan-results.png
