trawngson/aware/firmware/include/status_report.h

// "status", in the style of neofetch: the bin on the left, facts on the right.
// Console only.
#pragma once

void printStatus();

// "imu": what the MPU-6050 under the plate reads now.
void printImu();
