trawngson/aware/(commit log)

2026-07-22 Archive current app and backend pipeline
    [boxes.csv, classes.csv, images.csv]
2026-07-23 Fix isolated kernel GPU device setup
2026-07-23 Defer battery from training ontology
2026-07-24 Add Open Images training metadata selection
    [boxes.csv]
2026-09-16 Track project docs and target test-set tooling
    The repository is now private, so the governing documents can live in git
    where cloud sessions and collaborators read them instead of existing only
    on one machine.
    Add CLAUDE.md, backend/AGENTS.md, SPECIFICATION.md, and WORKFLOW_CHECKLIST.md
    via an explicit force-add rather than removing the ignore rules, so local
    assistant session state stays untracked.
    Add the target-domain test-set tooling and its text inputs: the label review
    script, the accepted-image list, and the labeling instructions. Test-set
    media and returned label archives are newly ignored at the repository root
    so they can never be committed.
    Rewrite the closing section of WORKF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
2026-09-18 Record controlled training runs and select YOLO26n
    Both controlled runs finished on the approved recipe: YOLO26n (best epoch
    131, validation mAP50 0.409) and YOLO26s (best epoch 168, validation mAP50
    0.423). YOLO26n is selected before any test-set evaluation because validation
    accuracy is effectively tied and it is the smaller, faster model for on-device
    use.
    Also add the test set v2 change record, which the v2 commit referenced but the
    backend markdown ignore rule had kept out.
2026-09-19 Ship YOLO26n with an explicit Hanoi recycling policy
    Replace the COCO demo model with the selected YOLO26n FP16 package and
    replace substring label matching with an explicit, versioned
    canonical-label-to-policy table (hanoi-2026.1). The table is based on Hanoi
    Decision No. 87, the Law on Environmental Protection 2020 Article 75, and
    MONRE guidance 9368/BTNMT-KSONMT. Cups and cardboard ask the user about
    material or cleanliness before giving guidance. A separate reward layer awards
    each scan event at most once. Guidance is in English and Vietnamese via a
    String Catalog, and auto-confirm now covers all seven classes instead of
    bottles only.
    Policy and reward logic were compiled and checked on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
2026-09-19 Keep scan guidance casual and link to recycling ideas
    Scan results no longer show jurisdiction, sources, or policy version. They
    now live on a Recycling guidance page under a new More screen, opened from the
    Home header. Guidance text drops regulatory phrasing, and the unsupported-item
    fallback suggests rescanning instead of checking with the ward. Each result
    ends with a prompt and a button to the Gallery's recycling ideas.
2026-09-19 Add an iPhone XR benchmark mode to the app
    The shared "awareapp Benchmark" scheme builds Release, launches without
    the debugger, and passes -AWAREDeviceBenchmark, which opens a benchmark
    screen instead of the tabs. It runs the Scan tab's camera component and
    records the raw duration of every frame's inference, since the YOLO
    package only reports smoothed timings. It also samples memory
    (phys_footprint), thermal state, and battery once a second.
    The local UltralyticsYOLO copy is what the app actually compiles (it
    shadows the SPM package), so the timing hook lives there:
    BasePredictor.predict reports each frame's start and duration, and
    YOLOView forwards it once the model loads.
    A run refuse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
2026-09-19 Score iPhone XR benchmark runs against the approved limits
    records/device-benchmark-protocol-v1.yaml fixes the run settings, the
    SPECIFICATION.md 5.1.1 limits, their definitions, and the weight hashes
    of the YOLO26n and YOLO26s FP16 packages. It was approved on 2026-09-19,
    before any run; changes need a new protocol version.
    scripts/check_device_benchmark.py checks one run file from
    PROJECT_OUTPUT_ROOT, writes a .check.json result next to it without
    overwriting, and reports PASS, FAIL, or INVALID. Sustained FPS is gated on
    the worst measured minute, p95 latency uses the nearest rank over all
    measured frames, and a run that breaks the protocol (charging, wrong
    build or device, unknown model,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
2026-09-19 Keep the benchmark screen awake and settle its brightness
    Auto-lock now stays off for the whole benchmark session, so the phone can't
    lock while it rests unplugged before a run, and the screen holds 50%
    brightness throughout. A run starts 1.5 s after the brightness is set:
    the first run's first sample read the previous brightness because iOS had
    not applied the change yet, which made that run invalid. The live overlay
    also shows how often items are detected, to help aim the camera.
2026-09-19 Record the YOLO26n app decision and iPhone XR benchmark results
    The app ships YOLO26n by the user's decision; YOLO26s was not measured on
    a device.
    On the iPhone XR (iOS 18.7.10), YOLO26n passes every protocol v1 limit
    except thermal: p95 latency 30.5 ms, at least 21.6 FPS in every minute,
    78 MiB peak memory, 9% latency drift, and a 5-point battery drop over ten
    minutes, but iOS reports the serious thermal state after about 3 min 45 s.
    The user then revised the thermal gate to fail only at critical (protocol
    v2, all else unchanged), since the app is used for short scans and FPS and
    latency drift already gate throttling. The run passes v2. The results
    record keeps the v1 FAIL, the reason for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
2026-09-19 Point the test evaluation record to the app model decision
    The record said the app model would be revisited after both models were measured on the iPhone. The user chose YOLO26n without that comparison, so the record now points to where the decision and the device results are recorded.
2026-09-25 Redesign the app in the Liquid Glass style
    - Add a design system (glass surfaces, forest backdrop, theme) and rebuild
    Home, Scan, Gallery, insights, leaderboard, More and onboarding on it;
    add the recycling map, post thread, new post, detection overlay, impact
    card and correction sheet; remove the old components they replace.
    - Replace the low-resolution forest background with a CC0 photo ("Spruce
    forest at Holma by Gullmarn 3" by W.carter, Wikimedia Commons), 2880x2880
    and color-matched to the previous image.
    - Let the tab bar follow the device's Light/Dark setting; screens over the
    forest keep their dark content and navigation bars, and light sheets set
    their own appearance.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
2026-09-25 Pin the render check's language and region
    Fresh simulators take their region from the host, so CI (en_US) showed
    24,100 and Sep 19, 2026 where the Mac (en_VN) shows 24.100 and 19 Sep 2026.
2026-09-26 Keep the tab bar in the device's appearance on the map
    The map switched the whole window to Light, so in Dark mode its tab bar
    turned light. Only its navigation bar needs the light appearance, which
    it already sets itself; the status bar follows it.
2026-09-26 Let the render check use an existing simulator
    SIMULATOR=existing picks the machine's simulator named DEVICE on the
    runtime, a booted one first, instead of creating one; it restores the
    simulator's status bar and appearance afterwards. The script also times
    the status bar override, which the last CI run spent minutes on.
2026-09-26 Keep the map's tab bar dark in Dark mode
    The CI screenshots showed that dropping the window's Light override was
    not enough: on iOS 27 the tab bar takes its appearance from the screen
    under it, so the light map still lightened it, and the forest screens
    keep it dark in Light mode too. The map now asks for a dark tab bar
    when the device is in Dark mode.
2026-09-26 Make the tab bar follow the device's Light/Dark setting
    On iOS 27 the tab bar took its appearance from the screen under it, so
    it was dark over the forest and light over the map in either setting,
    and forcing it with toolbarColorScheme turned the selected tab white.
    The tab bar now gets the device's style and a green selected tab (mint
    on the dark bar) directly.
2026-09-26 Keep the scrolling screens' scroll views in the device's appearance
    On iOS 27 the tab bar was dark over the forest screens' cards in Light
    mode too, while screens with nothing under it followed the device. The
    bar seems to take its style from the scroll view under it, which had
    the tabs' dark appearance. TabScrollView gives the scroll view itself
    the device's setting and keeps its content dark, so the screens look
    the same. ContentView passes the setting down as deviceColorScheme,
    since the tabs override colorScheme.
2026-09-26 Show the recycling map dark in Dark mode
    The tab bar takes its style from the map under it, so the always-light
    map kept a light tab bar in Dark mode. In Dark mode the map now follows
    the device, with a dark top shade, a dark navigation bar, white back
    button and mint "nearby" count. Light mode is unchanged.
2026-09-26 Remove the shadow behind the map's filter chips
    The chips' drop shadows were clipped by their horizontal scroll view
    into a grey band with a hard bottom edge behind the row. The chips now
    use the chrome glass without its shadow, and the selected chip drops
    its green glow.
2026-09-26 Keep the tab bar in the device's appearance over scrolling content
    Built with Xcode 26, the tab bar was dark over Home in Light mode and
    turned light only where no content scrolled under it (the bottom of
    Home, the Leaderboard). It took the content's dark style through the
    bottom scroll edge effect. TabScrollView now hides that effect, so the
    bar follows the device's Light/Dark setting on every screen.
2026-09-28 Add a README tour to the render check, with a step timeline
    RENDER_STEPS=readme runs a tour paced for the README's GIFs: onboarding,
    Home and its insights, the recycling map's filters, the leaderboard,
    More, the Gallery (liking, a post, the composer) and a scan through to
    its results and Add to Gallery. A new glide:up|down step drags slowly
    and holds before lifting, so pages move without a fling.
    Next to the screenshots the test now writes timeline.json: each step's
    start and end time and where it touched the window. When recording, the
    script saves when the video started on the same clock, so clips can be
    cut from the recording at any step.
2026-09-28 Add a script that builds the README's screenshots and GIFs
    readme-media.py takes a render check run of the README tour (both
    appearances, with video) and writes .github/readme/: the tour's
    screenshots in an iPhone frame, a banner of five of them over the app's
    forest, the app icon, and GIFs cut from the recordings at the tour's
    steps, with a dot where each tap and glide lands, long pauses shortened
    and a crossfade back to the start. A last GIF reveals Light and Dark in
    turn.
2026-09-28 Lay out the README around new screenshots and GIFs
    The README gets a banner, a tour (a scan in detail, then Home, the
    recycling map, the Gallery, insights, posting and Light and Dark as
    GIFs) and framed screenshots, all from .github/readme/, which
    readme-media.py builds from a render check run. The logo comes from the
    repository instead of an image host, and the install commands render as
    code blocks again.
2026-09-28 Say where the render check stopped when it fails
    The test now writes each step to timeline.json before running it, so
    the step without an end time is the one that failed, and the script
    prints that step and the failure messages from the result bundle.
    The README tour taps CO₂ Saved by "CO", which doesn't depend on how the
    subscript two comes through in the accessibility label; a run of the
    tour stopped around that step in both appearances.
2026-09-28 Swipe back after scrolling in the README tour
    The last run stopped at "back" after scrolling Waste Saved down: the
    navigation bar had no back button to find. After a glide the tour now
    swipes back from the edge, there and on the leaderboard.
    Swipes and glides share one drag helper that also records the drag's
    speed and hold in the timeline, so readme-media.py draws the fingertip
    along any drag, not only vertical ones.
2026-09-28 Go back by swiping when a screen has no back button
    The README tour got further (four screenshots) and then stopped at
    "back" on CO₂ Saved, reached after swiping back from Waste Saved: no
    back button in its navigation bar again. The back step now also looks
    for the system back button by name, and when there is none it swipes
    back from the edge and says so in the log.
    Typing first taps the first text field when none has focus yet, so the
    composer step doesn't depend on how fast its field takes focus.
2026-09-29 Show how the README recordings line up with their tours
    The media job logs each recording's timing (stamped start, recorder log,
    frame timestamps) and uploads a contact sheet of it, a frame a second
    labeled with the step running then. media_args passes more arguments to
    readme-media.py.
2026-09-29 Line the README recordings up with the tour's screenshots
    Tap times make poor anchors: a tap step lasts 3-5 s while XCUITest waits
    for the app to settle, so matching the screen's reactions picked a wrong
    shift. Each screenshot shows exactly what was on screen when it was
    taken, and the recording frames that match all of them give the shift
    (on the last run the recordings ran about 4 s ahead of their stamps).
    The UI test now notes when each screenshot was taken, the scan's live
    still is taken once the bottle is outlined, and the contact sheets
    label frames with the aligned steps.
2026-09-29 Add the README's screenshots and GIFs
    Built by the render check's readme-media job from a README tour on
    Xcode 27 and iOS 27 (run 36588753778): the icon, the banner, eight
    framed screenshots and six GIFs the README already points to.
2026-09-30 Draw the README frames' island where the recordings show it
    The simulator draws the Dynamic Island into its screen recordings but
    not into the tour's screenshots. The frame drew a wider, higher iPhone
    Pro island over every screen, so in the GIFs the recorded island showed
    below it like a second one. readme-media.py now measures the island
    from the recordings (the part of the top that stays dark in every
    frame) and draws its own exactly over it, in the GIFs and the
    screenshots alike. Without a recording it falls back to the old size.
2026-10-06 Add v2 smart-bin physical design and animated preview
    [blank_display_face.step, blank_display_face.stl, blank_label_1.step, blank_label_1.stl, blank_label_2.step, blank_label_2.stl, blank_label_3.step, blank_label_3.stl]
2026-10-09 Add v3 smart-bin physical design with raised walls and funnel
    V3 becomes the documented design: thrown items funnel onto one enclosed
    tipping plate, with the display and camera in a console on the rear rim.
    V2 stays in design/v2 as the previous revision.
    [blank_display_face.step, blank_display_face.stl, blank_label_1.step, blank_label_1.stl, blank_label_2.step, blank_label_2.stl, blank_label_3.step, blank_label_3.stl]
2026-10-13 feat(design): add buildable A (drum) and B (aluminium frame) bin CAD
    Shared head for both bodies: funnel, soft skirt, 320 mm aluminium plate on a
    two-axis joint with two DS3218 servos and GT2 2:1 belts, 47 degree stop ring,
    IMU on the plate yoke, four fill sensors, and a rear ESP32-S3 console with the
    camera hidden under its chin.
    Body A: 220 L drum with half-lapped dividers, divider cap, quarter bag frames,
    latches, lid switch and an orientation socket.
    Body B: 20x20 aluminium frame with two drawers on full-extension slides, a
    fixed back panel and drawer switches.
    The script checks every tilt pose for positive-volume overlaps, the camera
    sightline over the throat lip and servo load at or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
2026-10-13 feat(design): add the A/B design viewer page
    design/ab/index.html is the tabbed design page shared as an artifact: one tab
    per subsystem with its own 3D view of the CAD meshes, dimensions, assembly
    steps, bad cases and a cost estimate. It reads a_drum/ and b_frame/ next to it,
    so serve the folder (python3 -m http.server) instead of opening it as a file.
2026-10-13 fix(design): use the agreed yaw-then-tilt drive for the A/B head
    The head now follows the drive chosen earlier for the tilting plate instead of
    a two-servo gimbal. An MG90S turns the tilt stage +/-45 degrees on a vertical
    8 mm shaft in two flanged bearings; an MG996R then tilts the plate +/-45
    degrees through a GT2 2:1 belt (158 mm loop, 48.58 mm centres). The hinge sits
    22 mm under the plate surface on two KP08 pillow blocks, so the servo only
    supplies torque and lifts a 0.63 kg item at the edge within half of stall.
    The fixed stop ring is replaced by two stop pads on the turning platform,
    since the low plate edge now only reaches r128. Pose checks cover yaw with the
    plate level and each t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
2026-10-13 feat(design): matte aluminium colour finishes for body B, hide option A
    The A/B viewer page now shows body B in a smooth matte anodised aluminium
    finish with four colours (silver, gray, dark green, black; black is the
    default). The picker sits on the overview tab and in a new "Màu vỏ" card on
    the "Thân B" tab. The funnel mouth, tilting plate and display console take
    the same colour, with the mouth and plate slightly lighter than the shell.
    The colour is a 3D preview only; materials and costs are unchanged.
    Rendering: studio reflections for the metal panels, a soft contact shadow, a
    floor that fades into the background, and a default camera that fits the
    whole bin (further back on narrow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
2026-10-13 feat(design): route the servo cables in the A/B head
    Both servo cables are modelled as 3.5 mm round bundles from the rear console,
    through holes in the funnel collar and the deck, down the rear hanger and along
    the joint beam. The MG996R cable climbs beside the yaw bracket, makes a
    quarter slack loop 23.4 mm from the yaw axis between two printed clips and
    runs on the platform away from the belt. The loop stretches 37 mm over the
    full 90 degree yaw travel.
    The pose checks now include the cables, the deck and collar DXF patterns carry
    the cable holes, and the reported cable lengths are 787 mm (MG90S) and 959 mm
    (MG996R).
2026-10-13 feat(design): rolling-loop cable channel and yaw hard stop
    The MG996R and IMU cable now crosses the yaw joint as a 10-core flat ribbon in
    a rolling loop: a fixed outer channel wall and a drum that turns with the
    platform. Turning only rolls the U fold along the channel, so the ribbon bends
    at one radius (10.2 mm) and is never pulled tight. This replaces the free
    quarter loop, which had no spare length for the full yaw travel.
    A stop pin under the platform meets two lugs on the channel at +/-70 degrees,
    so a slipping coupling, stripped servo gears, a 360-degree servo fitted by
    mistake or a hand on the plate cannot wind the cable round the shaft. A pose
    check confirms the pin is clear at 68 d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
2026-10-13 feat(design): taller body B, larger inner bins and a 10.1 inch display console
    Body B stands 120 mm taller (rim at 1170 mm) through a new parameter,
    frame.extra_height_mm, which raises the frame, the skin and the whole head
    together. Body A keeps the height of its drum. The inner bins grow from 470 to
    590 mm to use that space: 32.5 -> 40.9 L each.
    The rear console becomes a 10.1 inch display slab leaning back on a low base,
    replacing the 260 x 190 block with a 3.5 inch TFT. The display shows the
    sorting status and, while idle, facts about waste; it needs its own controller
    board. The camera moves 8 mm further over the mouth (camera_y 150), which
    raises its sight margin at the throat lip fro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
2026-10-16 fix(design): keep the motor cable holes inside the new console back
    The half-round back of the 10.1 inch console put its wall over the
    collar holes at y 285. Move them to y 278 and assert the holes open
    inside the console so a later outline change cannot hide them again.
2026-10-16 feat(design): stainless shell, real 10.1 inch display and itemised costs
    - Body B shell is 1 mm 304 stainless: closed 10 mm hems, a 15 mm skirt
    on the top cover, a back mid rail and four bonded hat stiffeners on
    the drawer fronts. Silver (bead-blasted, no plating) is the costed
    build and the default colour; the other colours need PVD.
    - The display is the TJC X5 10.1 inch TJC1060X5101 without touch. The
    slab grows from 246 to 268 mm to hold its 258 x 152 x 11.5 mm board,
    the glass is its 235 x 143 mm visible area, and the idle screen shows
    the panel's black border. Both bodies rebuilt.
    - The cost tab lists every part on its own row with quantity, unit
    price, line total, shop an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
2026-10-17 fix(design): count 3D printing as free, parts are printed at school
    The PETG lot is now 0đ with an "In ở trường" status; the self-print and
    outsourced prices stay in its note. Body B drops to 8,8–12,8 triệu and
    body A's over-budget note shows small amounts in k instead of "0 triệu".
2026-10-17 fix(design): buy a full-metal MG996R and stop claiming unverified gears
    The Linh Kiện 3M "MG996" page says its gears are plastic and its torque
    figures contradict each other. The tilt servo now links a Shopee listing
    that states full metal gears (pick the Mg996r model, the shop also sells a
    360 version). The MG90S note no longer claims metal gears the page never
    mentions, the torque table keeps 11 kg·cm as the cautious figure, and the
    buying notes add the scale, gear and 1500 µs checks.
2026-10-17 fix(design): one price each for the 40T pulley and the GT2 belt
    The Lazada pulley link opened the 40 tooth 5 mm bore model; it now opens
    the 8 mm bore one (49k, same price). The closed GT2 belt moves to a Shopee
    listing that states GT2, closed loop, 6 mm and a 158 mm model (39.505đ);
    its note says the length must be exact because the servo slots only give
    ±1 mm.
2026-10-17 feat(design): HC-SR04 fill sensors with printed horns, drop body A
    Body A (the 220 L drum) is gone: its generator code, its parameters, the
    design/ab/a_drum outputs and every mention on the page. Body B's heights
    now sit in the base parameters; its geometry is unchanged byte for byte.
    Each fill-sensor pod now holds an HC-SR04 face down (45 x 20 board, two
    16 mm transducers, 26 mm pitch until a real board is measured) and flares
    each transducer into a 15 mm printed horn with a 24 mm mouth, which
    narrows the beam. A 45 degree web carries the connector shelf so the pod
    prints without supports. dimensions.json gains a fill_sensor block listing
    the edges nearer than the 90 % full level with thei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
2026-10-17 fix(design): cheaper KP08 pillow blocks from a well-rated Shopee shop
    Two KP08 (8 mm) blocks at 11.500đ each instead of 35–48k; the note says
    to pick the KP08 model because the listing's main photo shows a KP003.
2026-10-17 fix(design): buy all four pillow blocks from one Shopee shop
    KP08 and KFL08 now come from the same well-rated shop with same-day
    delivery, 12.000đ each (2 + 2). The KP08 row shares the listing link, which
    opens on the KFL08 model, so its note says to switch to KP08 - Phi 8mm. The
    KFL08 note warns that the yaw C-bracket has no bolt holes for the blocks
    yet.
2026-10-17 feat(design): drive the yaw shaft through a printed horn hub
    A 5 x 8 flexible coupling is 25 mm long, but only 13 mm was free between
    the servo shelf and the lower yaw arm, and its 5 mm half would grip only
    the tip of the MG90S spline. The MG90S now turns the shaft through its
    round horn and a printed PETG hub (20 x 11 mm, M3 set screw and nut on
    the shaft flat). The lower yaw arm moves up 5 mm, so the bearings are now
    35 mm apart, and the yaw shaft shortens to 70 mm. All 24 yaw and tilt
    poses pass.
    The page drops the coupling row, adds an estimated M3 set screw and nut,
    and updates the drive sketch, shaft lengths, print list and assembly
    notes, including measuring the real MG90S spline bef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
2026-10-17 fix(design): switch the LED switch to an XY-MOS dual MOSFET module
    The Linh Kiện 3M module is opto-isolated and drives the gate through a
    4.7k/4.7k divider from its own supply, so on the 5 V LED rail the gate
    only sees about 2.3 V and the strip may stay dim. The XY-MOS board
    (two D4184 in parallel, 3.3-20 V trigger) turns fully on from the
    ESP32's 3.3 V pin with VIN on the 5 V buck.
    The LED row now says how to wire the USB-plug strip: cut the piece at
    the cabled end, drop the plug and land + and - on OUT+ and OUT-.
2026-10-20 feat(design): Mix 2 body, folded PP bins and in-place bag changing
    Body B now stands on a bolted slotted-steel-angle frame with Formex
    boards inside, Formex 8 mm skins and only the top cover in stainless
    (frame.style "vlo"; any other value rebuilds the aluminium and stainless
    body). The four bins are folded from 3 mm PP sheet with flat patterns
    on CUT/BEND/NOTE layers, keep their bags in place with an elastic band
    and vent holes, and the viewer gains a tab that animates emptying a
    full bin. Part tables no longer collapse into one column.
2026-10-20 docs(design): roadmap, S3-1 circuit and body option pages
2026-11-01 feat(design): stainless body, slotted-angle frame on feet, measured tilt drive
    - Body B: hemmed 1 mm stainless skins with a 6 mm gap, drawer fronts with
    pull slot and stiffeners, slotted-angle posts on welded foot plates with
    M8 levelling feet, overlap-bolted rails, notched floor and seat boards
    - Tilt drive D redrawn from catalogue sizes: KP08/KFL08, shaft flange,
    25T horn and pulley adapter, MG996R/MG90S geometry; 42 fasteners and
    35 body fasteners recorded in dimensions.json
    - Console relayout for measured board sizes, Guition mount holes,
    100 mm LED groove, HC-SR04 pitch 27
    - Pages: main design page, parts-on-CAD page, drive C vs D comparison and
    drive D assembly steps
2026-11-01 feat(design): record every joint of body B, bolted head hangers and splice plate, joint page
2026-11-01 docs(design): match material page head plate and laser cut to the sheet
2026-11-02 docs(design): order material page by purchase batch with the sheet's item numbers
2026-11-02 docs(design): list materials by group without purchase batches
2026-11-02 docs(design): order one pack of slotted-angle bolts
2026-11-02 docs(design): show only the low price on the material page
2026-11-02 docs(design): add the head shell ring panel to the material page
2026-11-02 docs(design): show both material tabs with specs and totals on the material page
2026-11-04 docs(design): name the CAD page as the final self-sorting bin design
2026-11-04 docs(design): drop the material tab from the CAD page and link the material page instead
2026-11-04 docs(design): describe the bin in the CAD page header and drop the overview log cards
2026-11-04 docs(design): list key specs in the CAD page header and let tables wrap inside cards
2026-11-04 docs(design): add a price-free copy of the material page
2026-11-07 Add the smart-bin firmware for the camera and servo board
    The ESP32-S3 camera board photographs the plate, sends the photo to the
    detection server, applies routing-v1 on the board and turns the servo.
    - PlatformIO project on espressif32 8.0.0: Arduino core 3.3.12 built inside
    ESP-IDF 5.5.5, so sdkconfig.defaults can raise the TCP send buffer to 64 KB
    - One kept-open HTTPS connection to the server, reopened in the background
    - Every request carries the bin token in X-Bin-Token, from a git-ignored
    include/secrets.h; the build stops if it is missing
    - routing-v1 on the board, with native unit tests
    - Automatic scans when the plate changes, plus the BOOT button and serial
    commands; settin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
2026-11-07 Run the bin on three tasks and add a live camera view
    - Typed commands work at all times: a console task reads them, a worker
    task owns the camera, servo and LED, and a link task keeps the server
    connection open, so a slow reconnect or scan no longer blocks typing.
    - The serial console has a zsh-style prompt and line editor (history, Tab
    completion, UTF-8 input such as "TS’s iPhone"), a neofetch-style status,
    and prints the chip's own log lines above the prompt.
    - The RGB LED shows each scan's stage: blue scanning, green sorted, red held.
    - The viewer shows the camera live beside the last scan, over the USB cable
    at 2 Mbit/s. "feed" opens it from the PlatformIO monitor, whose fil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
2026-11-10 Add LLM mode and split the firmware into modules
    - "mode llm" sends each photo straight to an OpenAI model (GPT-6-Luna by
    default) through the ChatGPT Codex backend instead of to the detection
    server; routing-v1 routes the items the model names. "mode yolo"
    switches back, and the mode is saved.
    - "llm login" signs the board in to ChatGPT with the Codex device-code
    flow. The board keeps its tokens in NVS and renews them in the
    background a day before they run out; "llm logout" forgets them.
    - The kept-open link takes a request with its own URL, headers, reply
    size and timeout, and switches server first when the mode changed.
    - main.cpp is split into commands, worker, scan, plate_w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
2026-11-10 Fix the detection server's token check, routing table and pins
    - Refuse to start when REQUIRE_TOKEN is on and BIN_TOKEN is empty,
    instead of accepting every request; compare tokens as bytes so a
    non-ASCII header gets 401, not 500.
    - /config now follows routing-v1, as in include/routing.h: paper to
    liner 1, plastic bottles to liner 2, everything else to other.
    - Pin the image's packages (onnxruntime 1.31.1 as in the model's parity
    check).
    - Set min_containers from the Vietnam time at deploy, since a deploy
    resets it: a night deploy no longer keeps a container warm all night.
    - Point the firmware README at the server.
2026-11-13 Add an optional MPU-6050 IMU under the plate
    The IMU checks the plate is level before each scan, reports how far it
    tipped and whether it came back, and weighs felt impacts with what the
    camera sees for automatic scans. Without the chip the bin runs as before.
    Adds the imu command, unit tests for the IMU maths and presence rules,
    and an MPU-6050 to the Wokwi diagram. Firmware version mvp-0.7.0.
